Lucaszyf/Solar-Enhanced-Biomimetic-UAV/cad/No2/9gServo舵机/servo2.jpg

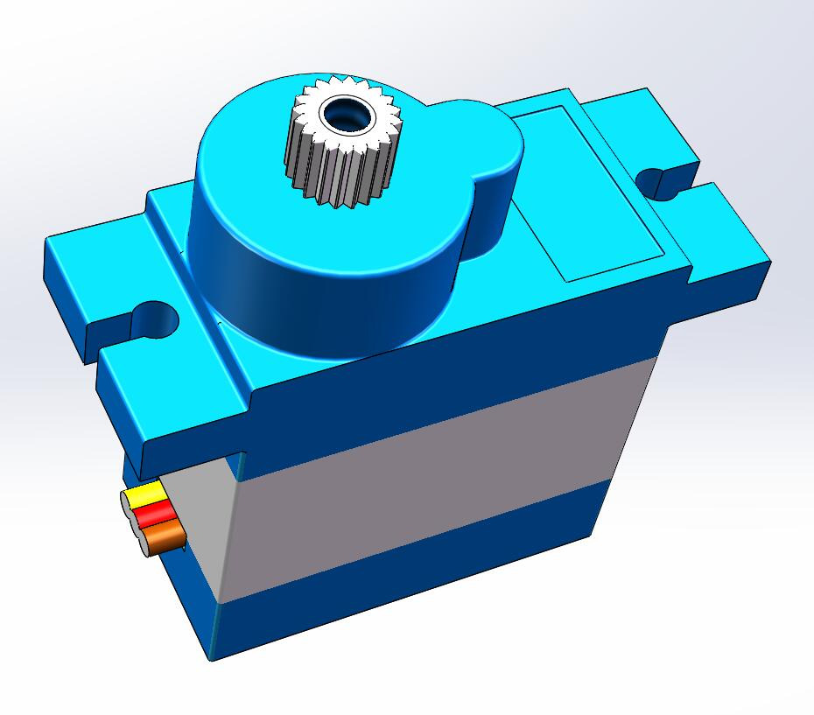
cad/No2/9gServo舵机/servo2.jpg
