Lucaszyf/Solar-Enhanced-Biomimetic-UAV/cad/No2/太阳能折叠总装/temp/images/6afcfdeb6e5e799abb95b9de54fae45f_preview_featured.jpg

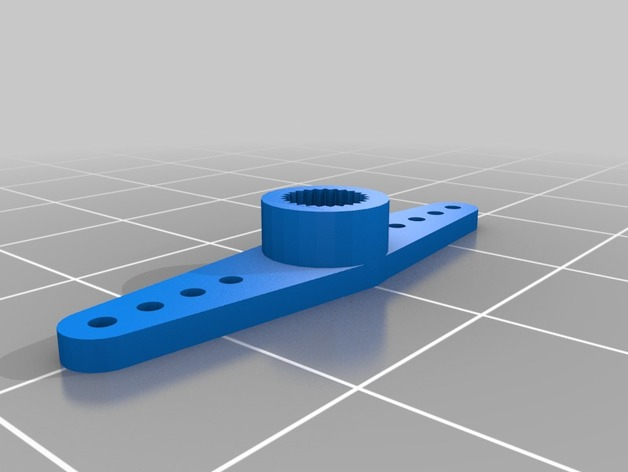
cad/No2/太阳能折叠总装/temp/images/6afcfdeb6e5e799abb95b9de54fae45f_preview_featured.jpg
