Lucaszyf/Solar-Enhanced-Biomimetic-UAV/cad/No2/太阳能折叠总装/temp/images/27f57d334d398717d7f864618033304d_preview_featured.jpg

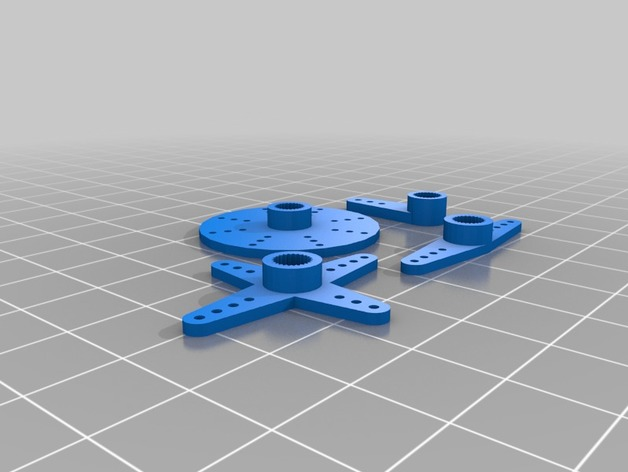
cad/No2/太阳能折叠总装/temp/images/27f57d334d398717d7f864618033304d_preview_featured.jpg
