Lucaszyf/Solar-Enhanced-Biomimetic-UAV/cad/No2/太阳能折叠总装/temp/images/63d8c76050e472f91e92825d48e62a55_preview_featured.jpg

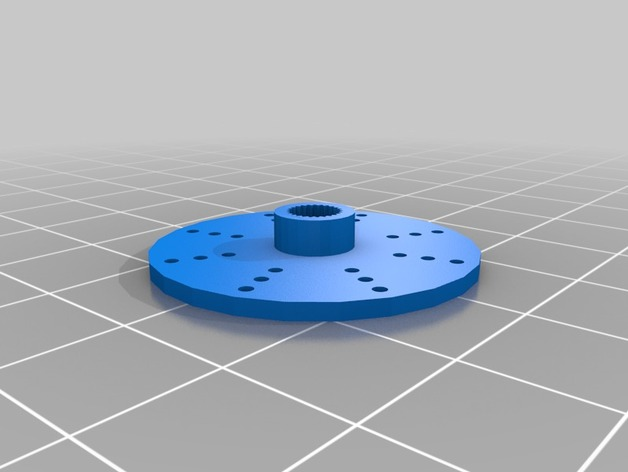
cad/No2/太阳能折叠总装/temp/images/63d8c76050e472f91e92825d48e62a55_preview_featured.jpg
