Lucaszyf/Solar-Enhanced-Biomimetic-UAV/cad/No2/太阳能折叠总装/temp/images/a5b6eb91ea950f15ae837887f96c0987_preview_featured.jpg

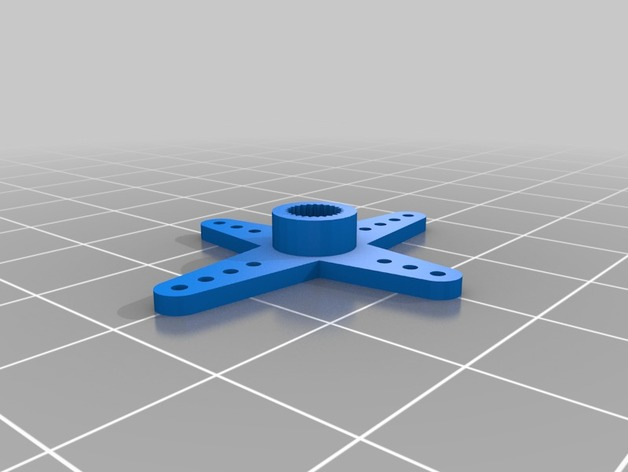
cad/No2/太阳能折叠总装/temp/images/a5b6eb91ea950f15ae837887f96c0987_preview_featured.jpg
