Lucaszyf/Solar-Enhanced-Biomimetic-UAV/cad/No2/太阳能折叠总装/temp/images/cd8d0d1ee94c76521f08f14a7efa53d7_preview_featured.jpg

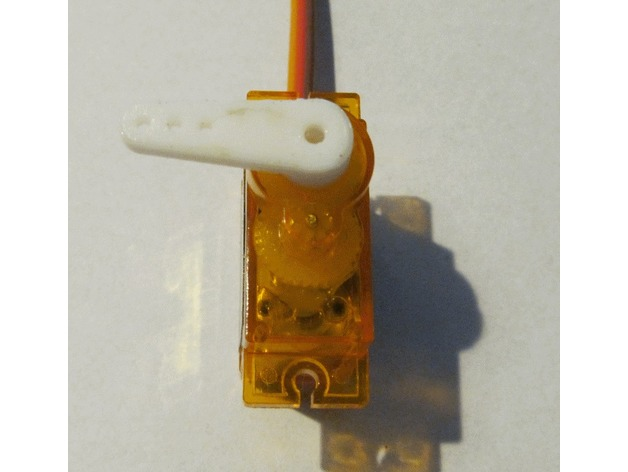
cad/No2/太阳能折叠总装/temp/images/cd8d0d1ee94c76521f08f14a7efa53d7_preview_featured.jpg
