Lucaszyf/Solar-Enhanced-Biomimetic-UAV/cad/No1/Lucas_3Dfile/尼龙碳纤维打印/数量.xlsx

名称 | 数量
inner suction cup connector | 2
outerconnectorv2 | 2
partCon01 | 1
partCon02 | 1
蜗杆1×1 | 2
蜗轮27×1 | 2
折叠架电机 | 4
齿条0.106814150222053×2 | 4
太阳能板夹持件 | 4
