Lucaszyf/Solar-Enhanced-Biomimetic-UAV/cad/No2/太阳能折叠总装/太阳能板子建模/n20 motor.SLDASM

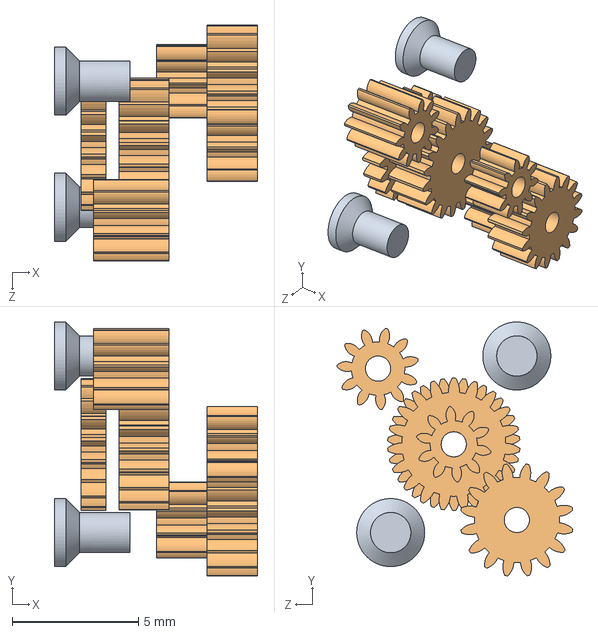
[picture p71: CAD file, 2026-10-14]
cad/No2/太阳能折叠总装/太阳能板子建模/n20 motor.SLDASM
8.05 x 10.1 x 9.34 mm
cross recessed countersunk head screws gb1 x 2
spur gear_gb x 6
