Lucaszyf/Solar-Enhanced-Biomimetic-UAV/cad/No3/三维模型总装配/Microswitch-SS-3GL13SL.SLDASM

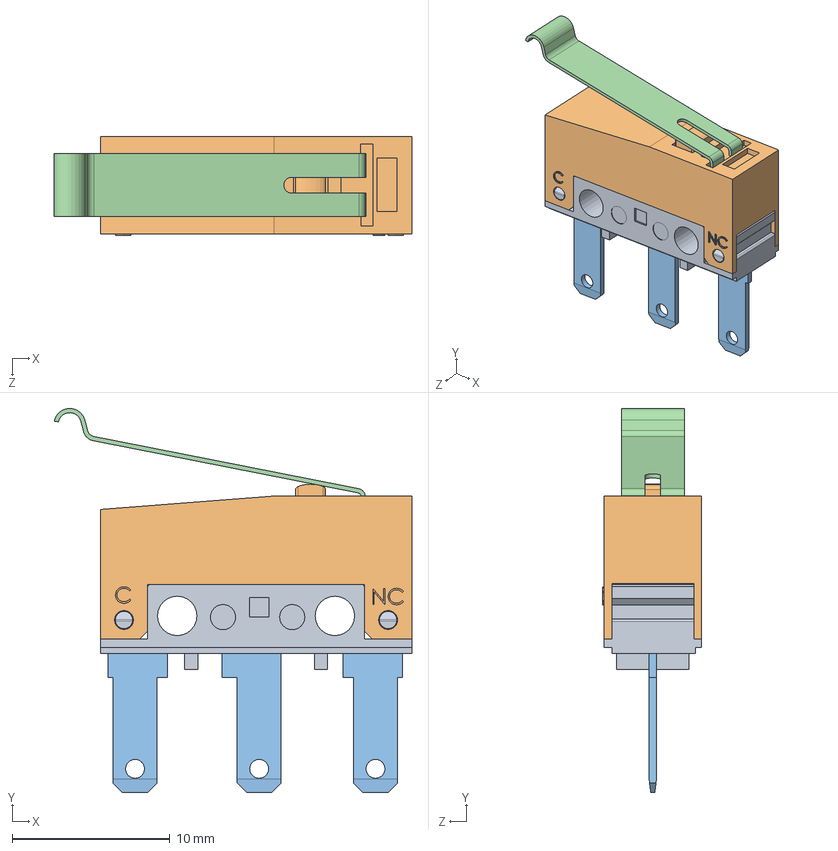
[picture p72: CAD file, 2026-10-14]
cad/No3/三维模型总装配/Microswitch-SS-3GL13SL.SLDASM
22.7 x 24.4 x 6.30 mm
limit-switch-bottomcase
limit-switch-top-case
pins
switch_lever
