Lucaszyf/Solar-Enhanced-Biomimetic-UAV/cad/No1/Lucas_3Dfile/整体装配.SLDASM

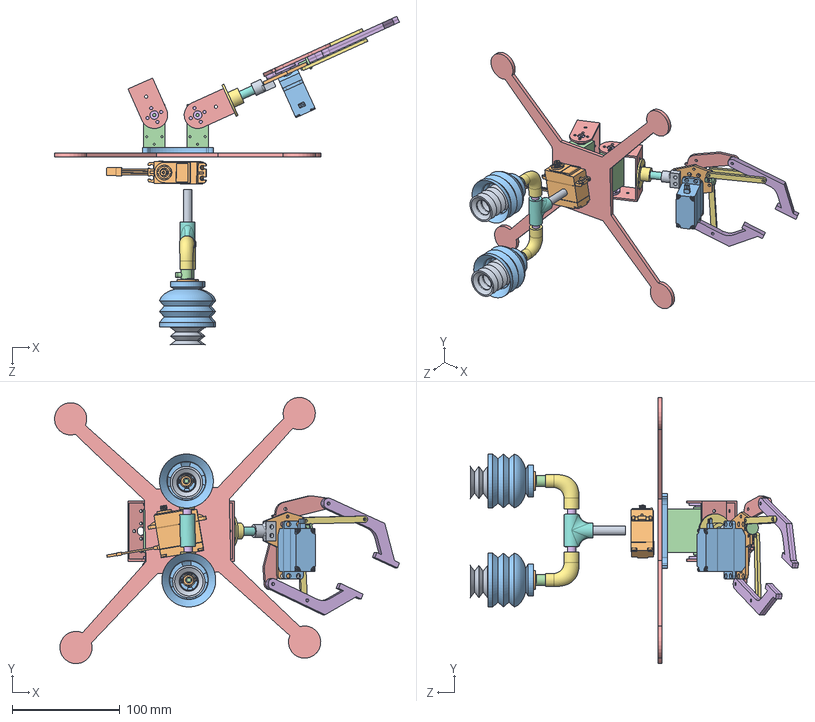
[picture p73: CAD file, 2026-10-14]
cad/No1/Lucas_3Dfile/整体装配.SLDASM
320.1 x 247.0 x 304.7 mm
INT_TUBE x 2
CON_2 x 2
EXT_TUBE x 2
CUP_HOL x 2
UAV_FRAME01
8x6碳管
CON_3 x 2
CON_4
8x6碳管02
25KG铝中壳舵机外形图
servodeck.step
3115舵机 x 2
短U支架 x 2
金属主舵盘 x 5
法兰盘01
8mm碳管
机械爪C01
单轴舵机
圆柱齿轮17×1.25从动 x 2
