Lucaszyf/Solar-Enhanced-Biomimetic-UAV/cad/No2/舵机云台/solidworks/pan_tilt.SLDASM

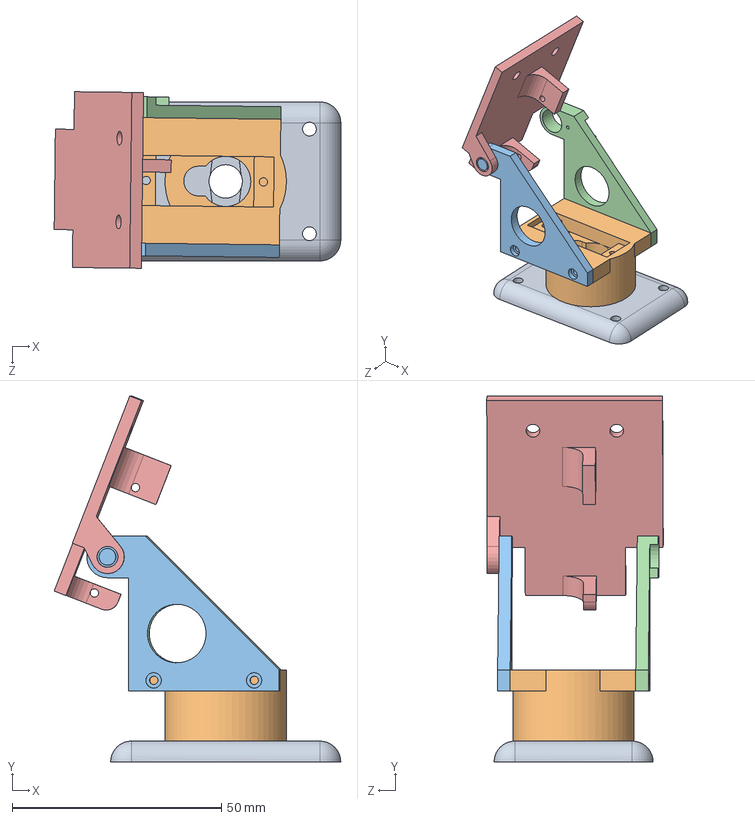
[picture p74: CAD file, 2026-10-14]
cad/No2/舵机云台/solidworks/pan_tilt.SLDASM
68.5 x 87.4 x 42.2 mm
base
rotate
left
right
head
