Lucaszyf/Solar-Enhanced-Biomimetic-UAV/cad/No1/3D零件图/双轴舵机3D图/3115舵机加舵盘.sldasm

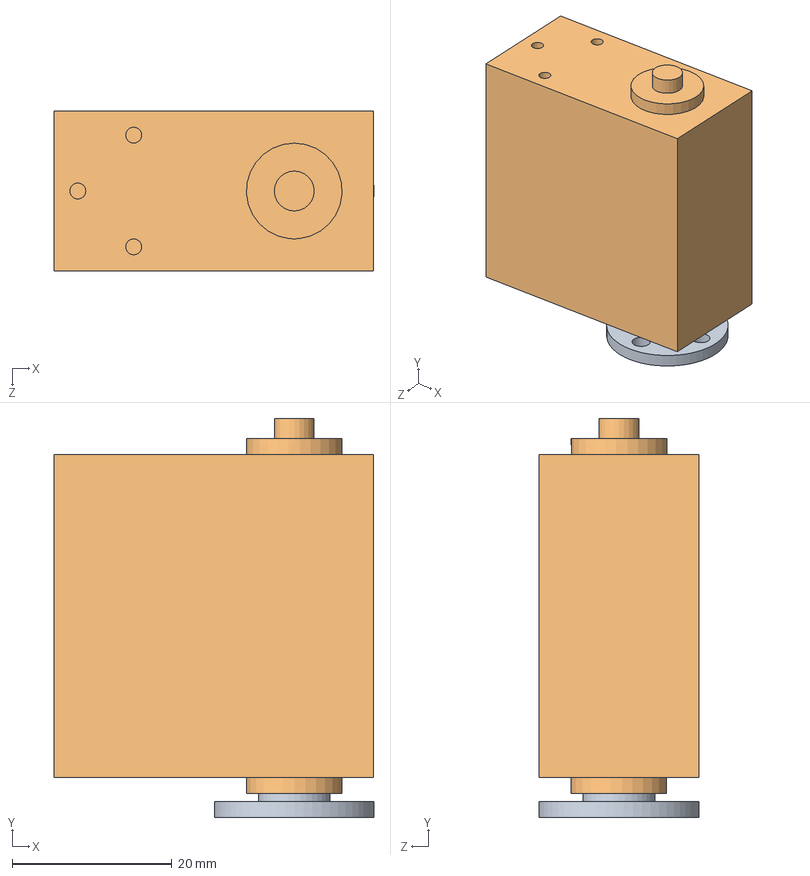
[picture p75: CAD file, 2026-10-14]
cad/No1/3D零件图/双轴舵机3D图/3115舵机加舵盘.sldasm
40.1 x 50.0 x 20.0 mm
3115舵机
虚轴舵盘
