Lucaszyf/Solar-Enhanced-Biomimetic-UAV/cad/No1/3D零件图/机械臂总装.SLDASM

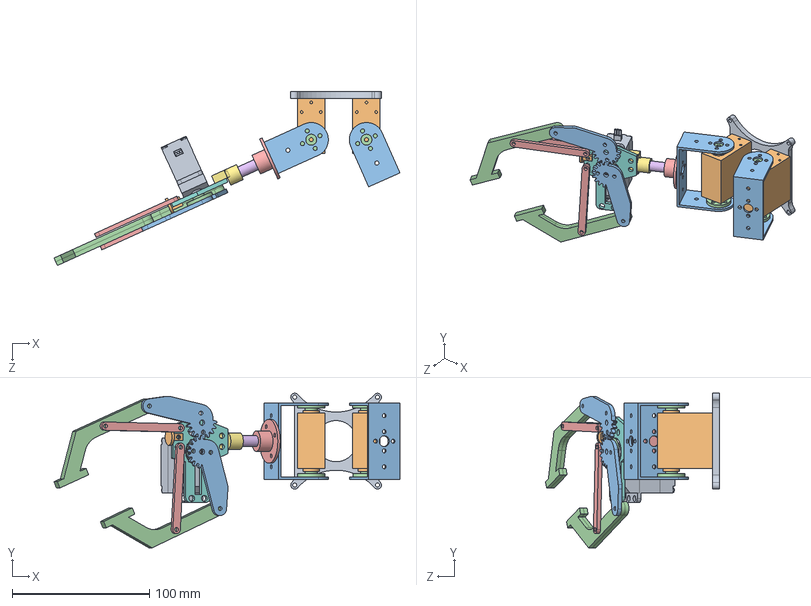
[picture p77: CAD file, 2026-10-14]
cad/No1/3D零件图/机械臂总装.SLDASM
251.9 x 112.6 x 126.7 mm
servodeck.step
3115舵机 x 2
短U支架 x 2
金属主舵盘 x 5
法兰盘01
8mm碳管
机械爪C01
单轴舵机
圆柱齿轮17×1.25从动 x 2
