Lucaszyf/Solar-Enhanced-Biomimetic-UAV/cad/No1/Lucas_3Dfile/机械爪/总装.SLDASM

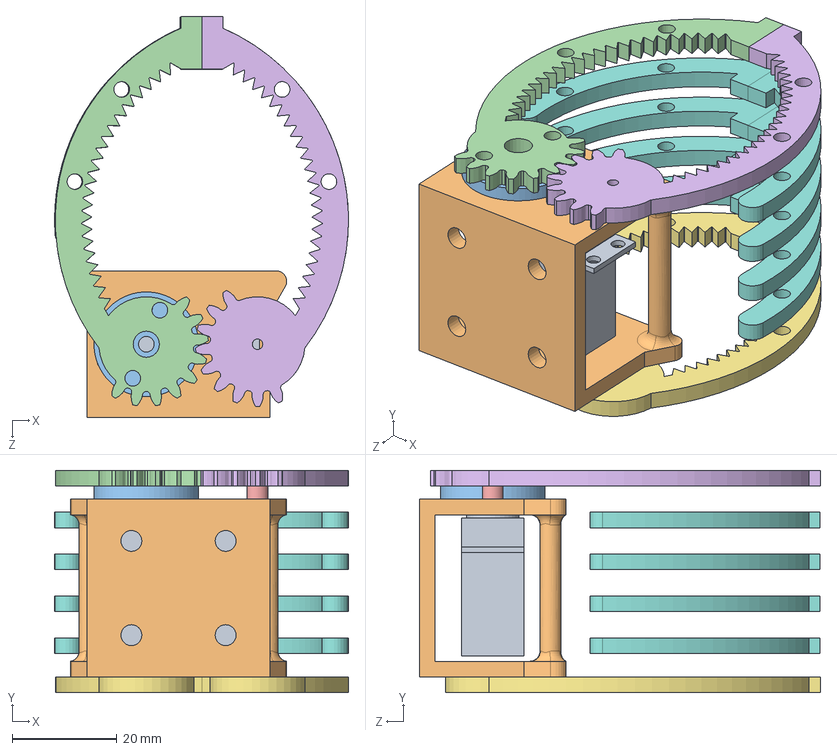
[picture p78: CAD file, 2026-10-14]
cad/No1/Lucas_3Dfile/机械爪/总装.SLDASM
56.2 x 42.5 x 76.6 mm
servo
金属主舵盘
圆柱齿轮17×1.25
圆柱齿轮17×1.2502
