Lucaszyf/Solar-Enhanced-Biomimetic-UAV/cad/No1/Lucas_3Dfile/吸盘支架总装.SLDASM

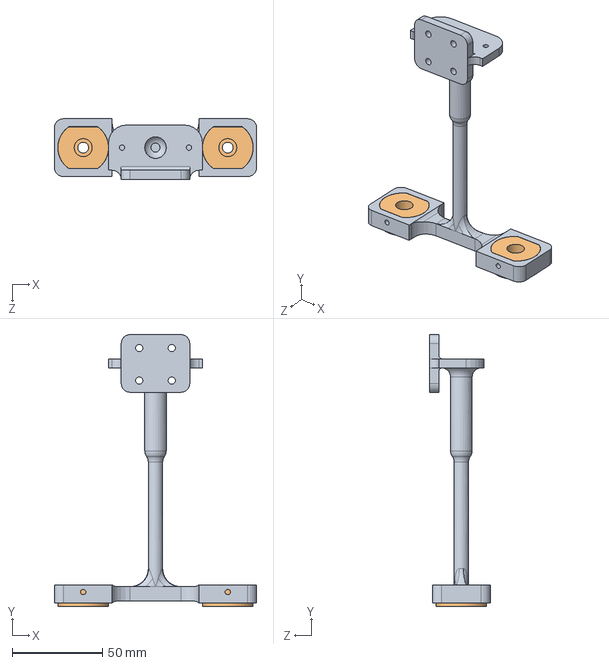
[picture p79: CAD file, 2026-10-14]
cad/No1/Lucas_3Dfile/吸盘支架总装.SLDASM
112.0 x 150.5 x 33.5 mm
partCon01
iconCon x 2
