Lucaszyf/Solar-Enhanced-Biomimetic-UAV/cad/No1/Lucas_3Dfile/模具总装.SLDASM

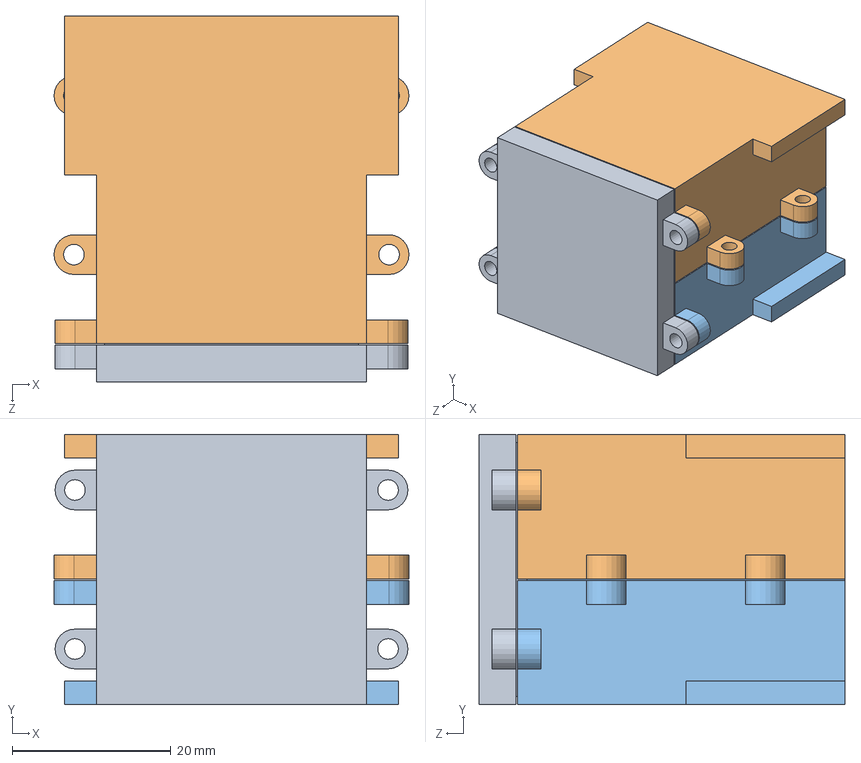
[picture p80: CAD file, 2026-10-14]
cad/No1/Lucas_3Dfile/模具总装.SLDASM
44.7 x 34.0 x 46.0 mm
模型内胆
上模具
下模具
