Lucaszyf/Solar-Enhanced-Biomimetic-UAV/cad/No1/Lucas_3Dfile/模具总装02.SLDASM

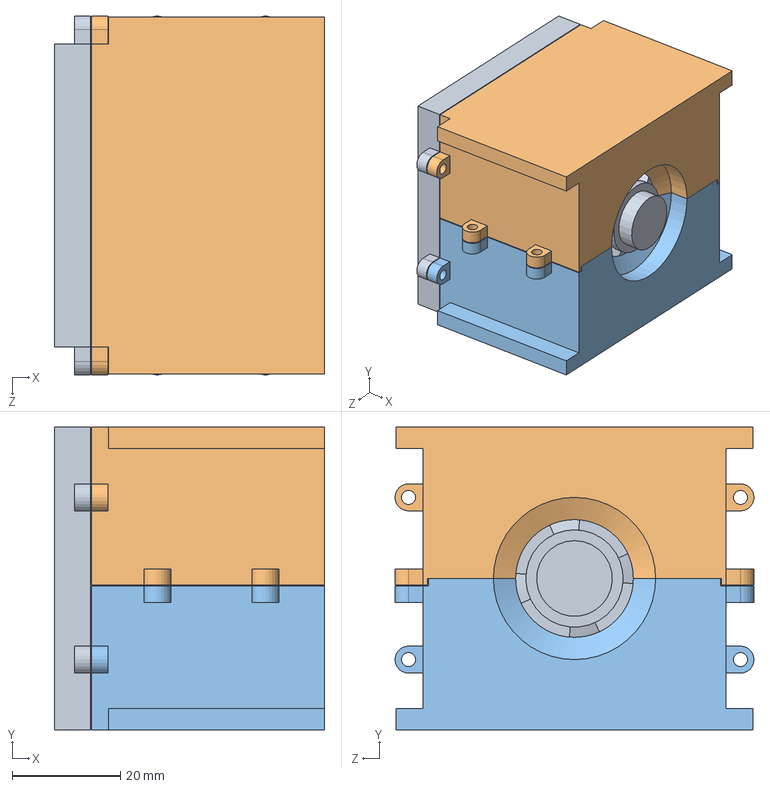
[picture p81: CAD file, 2026-10-14]
cad/No1/Lucas_3Dfile/模具总装02.SLDASM
50.0 x 56.0 x 66.4 mm
模型内胆02
上模具02
下模具02
