Lucaszyf/Solar-Enhanced-Biomimetic-UAV/cad/No1/2D/圆柱齿轮17×1.25从动.dxf

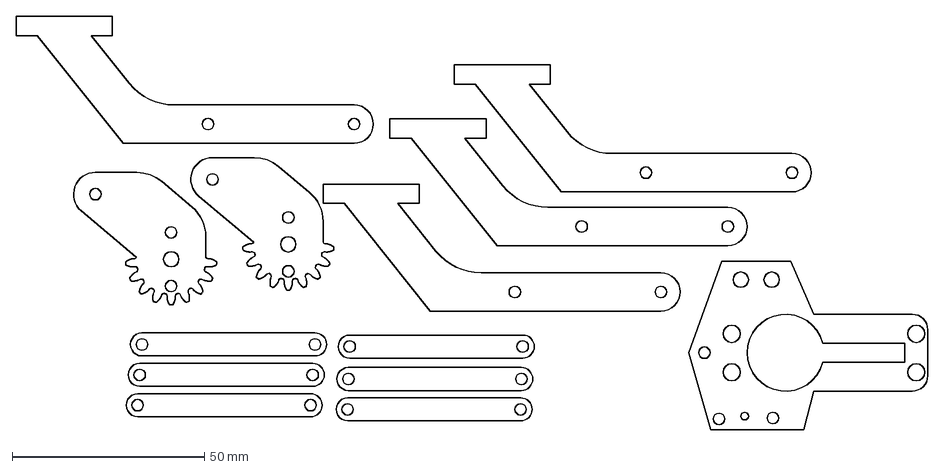
[picture p82: CAD file, 2026-10-14]
cad/No1/2D/圆柱齿轮17×1.25从动.dxf
237.1 x 107.5 mm
