Lucaszyf/Solar-Enhanced-Biomimetic-UAV/cad/No1/3D尺寸图/202315抛投器零件PDF档/1.抛丸器图纸.STEP

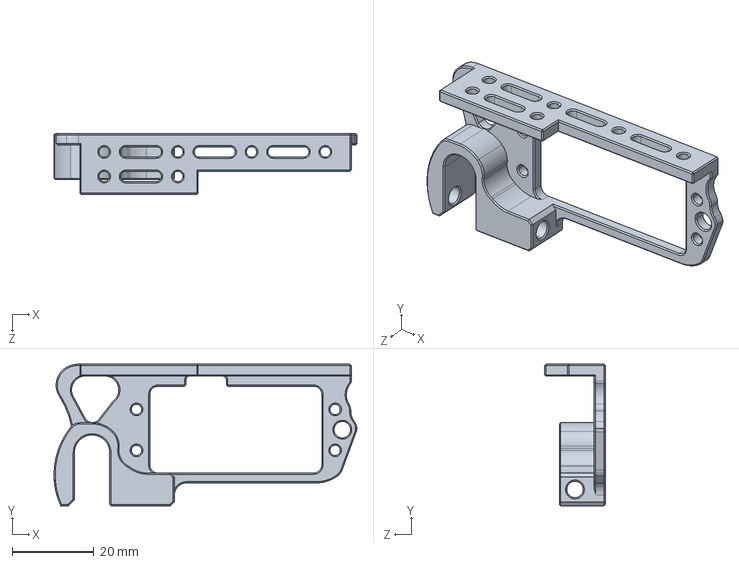
[picture p83: CAD file, 2026-10-14]
cad/No1/3D尺寸图/202315抛投器零件PDF档/1.抛丸器图纸.STEP
74.0 x 34.6 x 14.8 mm
