Lucaszyf/Solar-Enhanced-Biomimetic-UAV/cad/No1/3D尺寸图/TD-9412MG.stp

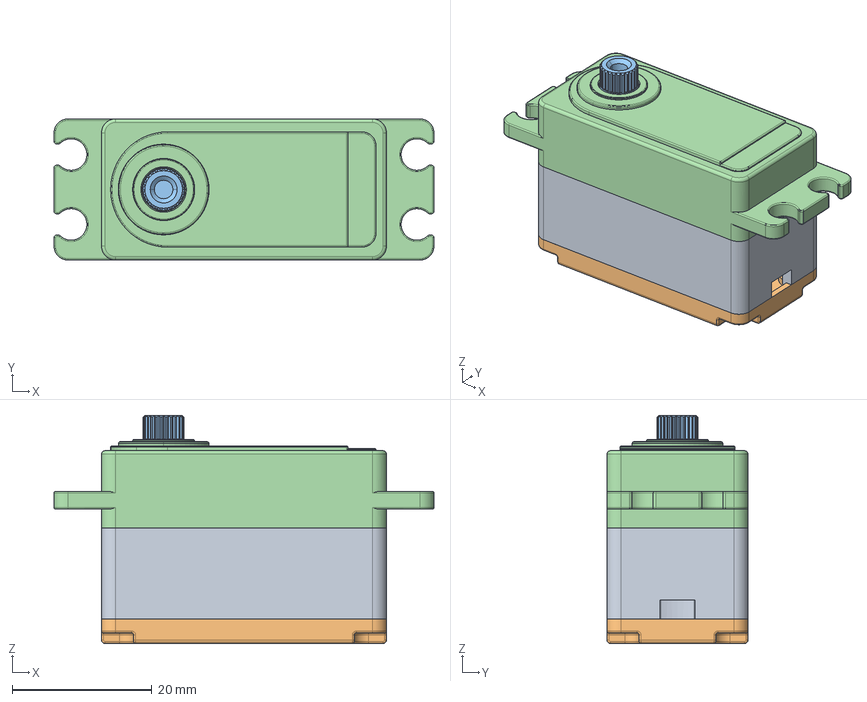
[picture p84: CAD file, 2026-10-14]
cad/No1/3D尺寸图/TD-9412MG.stp
54.4 x 20.2 x 32.6 mm
PRT0007_1
PRT0008_1
PRT0009_1
