Lucaszyf/Solar-Enhanced-Biomimetic-UAV/cad/No1/3D零件图/一字型支架.stp

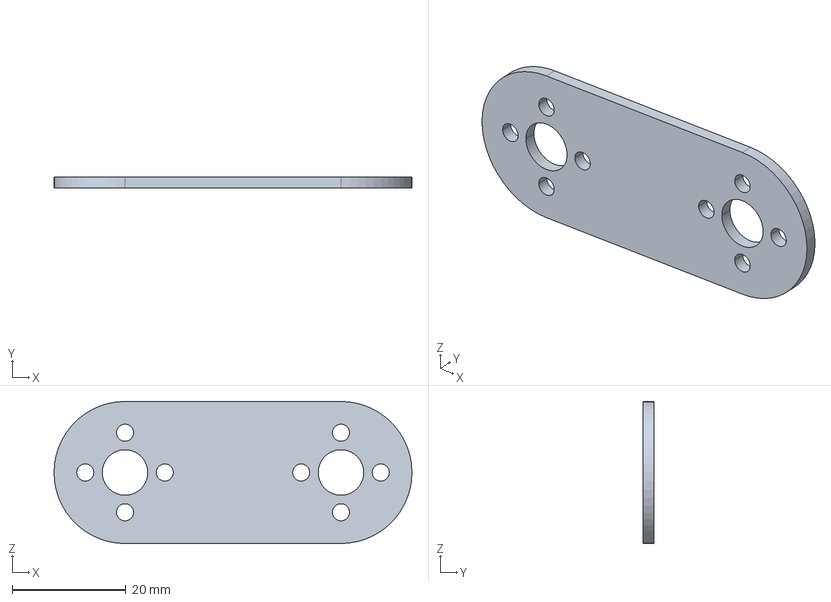
[picture p86: CAD file, 2026-10-14]
cad/No1/3D零件图/一字型支架.stp
63.0 x 2.00 x 25.0 mm
