Lucaszyf/Solar-Enhanced-Biomimetic-UAV/cad/No1/3D零件图/双轴舵机3D图/3115舵机.SLDPRT

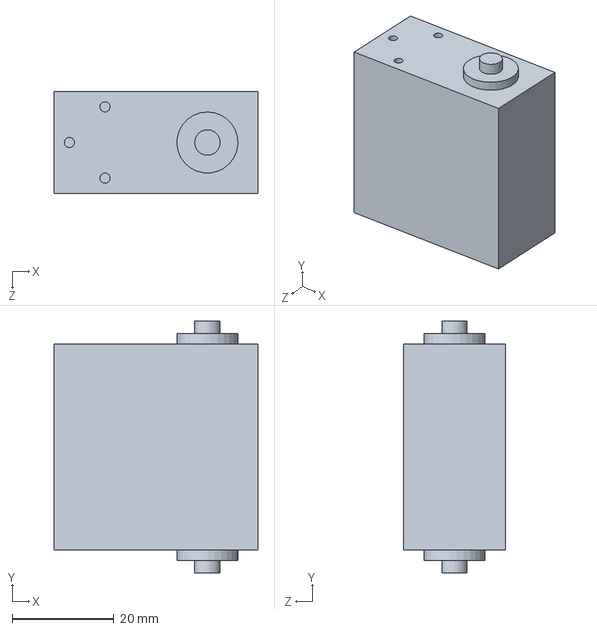
[picture p87: CAD file, 2026-10-14]
cad/No1/3D零件图/双轴舵机3D图/3115舵机.SLDPRT
40.0 x 49.5 x 20.0 mm
