Lucaszyf/Solar-Enhanced-Biomimetic-UAV/cad/No1/Lucas_3Dfile/CNC加工/iconCon.STEP

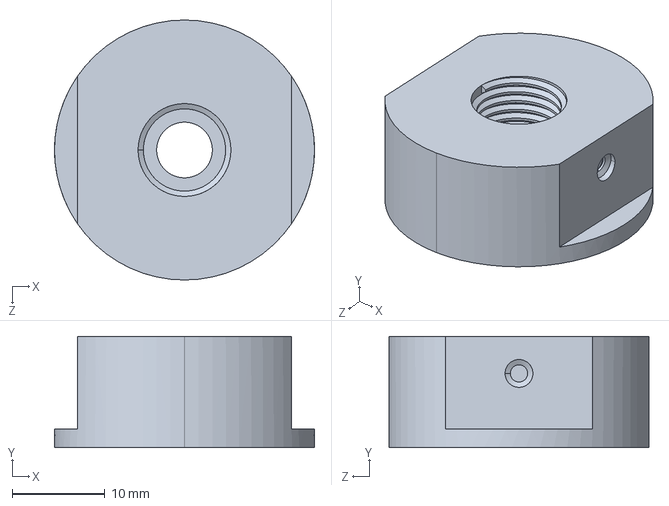
[picture p88: CAD file, 2026-10-14]
cad/No1/Lucas_3Dfile/CNC加工/iconCon.STEP
28.0 x 12.0 x 28.0 mm
