Lucaszyf/Solar-Enhanced-Biomimetic-UAV/cad/No1/Lucas_3Dfile/Lucas/inner suction cup connector.STEP

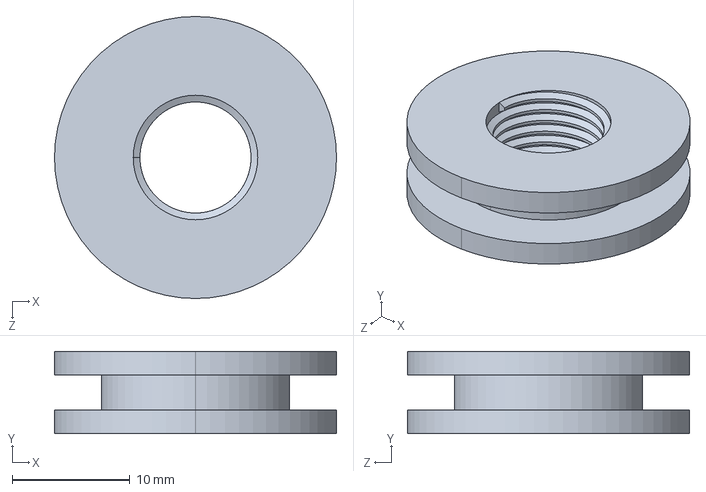
[picture p89: CAD file, 2026-10-14]
cad/No1/Lucas_3Dfile/Lucas/inner suction cup connector.STEP
24.0 x 7.00 x 24.0 mm
