Lucaszyf/Solar-Enhanced-Biomimetic-UAV/cad/No1/Lucas_3Dfile/上模具02.SLDPRT

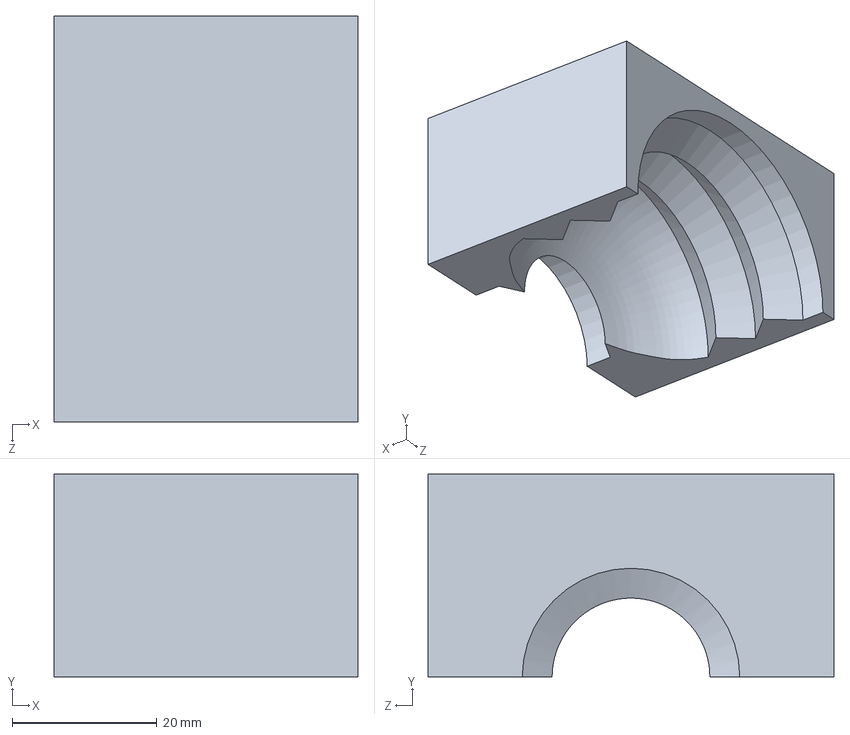
[picture p90: CAD file, 2026-10-14]
cad/No1/Lucas_3Dfile/上模具02.SLDPRT
41.9 x 28.0 x 56.0 mm
