Lucaszyf/Solar-Enhanced-Biomimetic-UAV/cad/No1/Lucas_3Dfile/尼龙碳纤维打印/齿条0.106814150222053×2.STEP

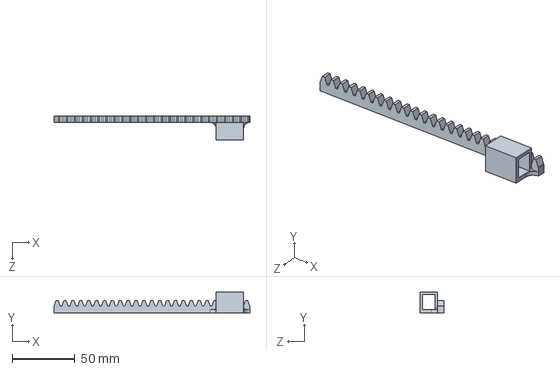
[picture p91: CAD file, 2026-10-14]
cad/No1/Lucas_3Dfile/尼龙碳纤维打印/齿条0.106814150222053×2.STEP
156.0 x 16.5 x 19.0 mm
