Lucaszyf/Solar-Enhanced-Biomimetic-UAV/cad/No1/Lucas_3Dfile/机械爪/2D/part04.dxf

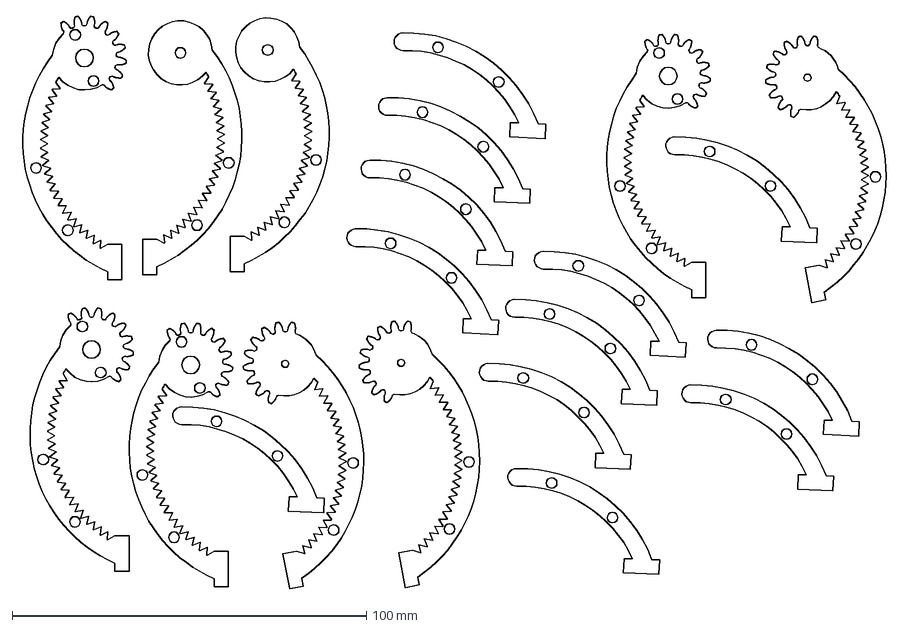
[picture p92: CAD file, 2026-10-14]
cad/No1/Lucas_3Dfile/机械爪/2D/part04.dxf
246.3 x 161.7 mm
