Lucaszyf/Solar-Enhanced-Biomimetic-UAV/cad/No1/Lucas_3Dfile/机械爪/part02.SLDPRT

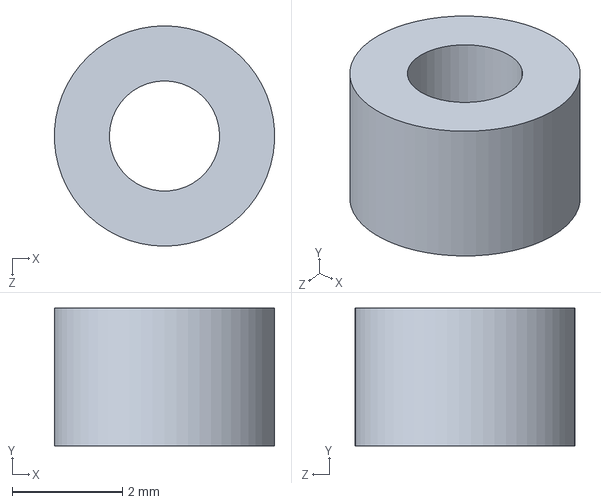
[picture p93: CAD file, 2026-10-14]
cad/No1/Lucas_3Dfile/机械爪/part02.SLDPRT
3.99 x 2.50 x 4.00 mm
