Lucaszyf/Solar-Enhanced-Biomimetic-UAV/cad/No1/吸盘打印件/吸盘支撑.SLDPRT

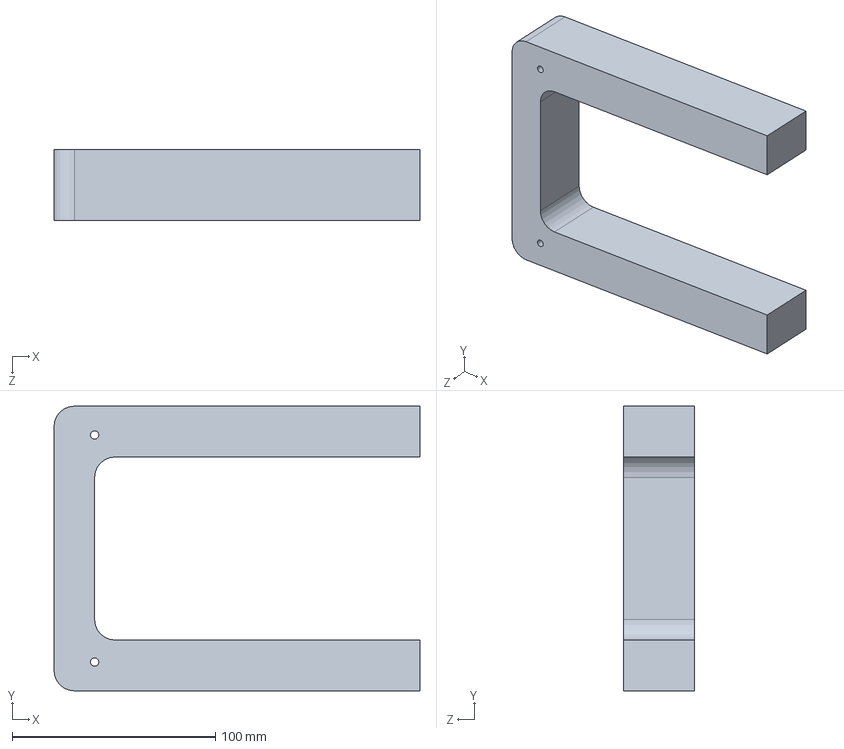
[picture p94: CAD file, 2026-10-14]
cad/No1/吸盘打印件/吸盘支撑.SLDPRT
180.0 x 140.0 x 35.0 mm
