Lucaszyf/Solar-Enhanced-Biomimetic-UAV/cad/No1/第二版/CON01.SLDPRT

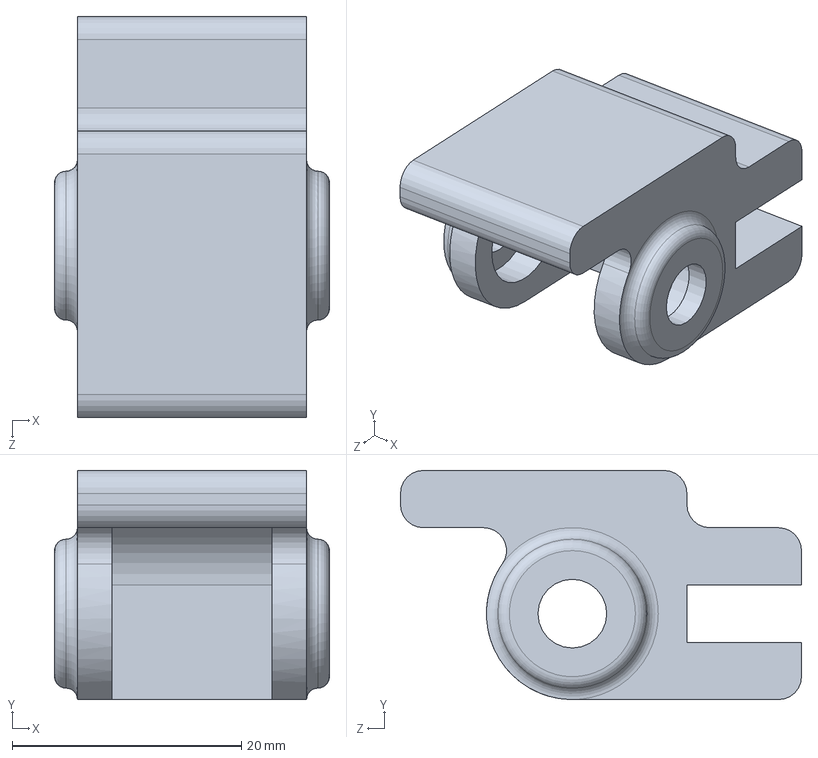
[picture p95: CAD file, 2026-10-14]
cad/No1/第二版/CON01.SLDPRT
24.0 x 20.0 x 35.0 mm
