Lucaszyf/Solar-Enhanced-Biomimetic-UAV/cad/No2/9gServo舵机/舵机.SLDPRT

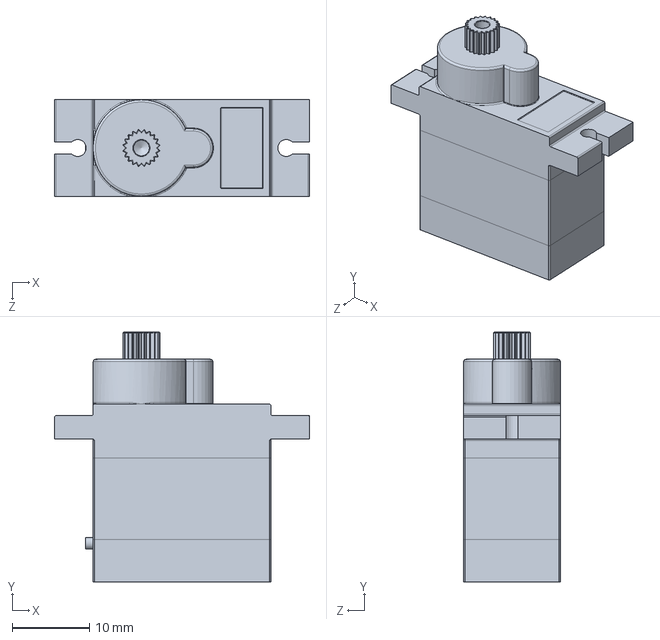
[picture p96: CAD file, 2026-10-14]
cad/No2/9gServo舵机/舵机.SLDPRT
33.0 x 32.3 x 12.5 mm
