Lucaszyf/Solar-Enhanced-Biomimetic-UAV/cad/No2/N20微型金属齿轮电机/motor.SLDPRT

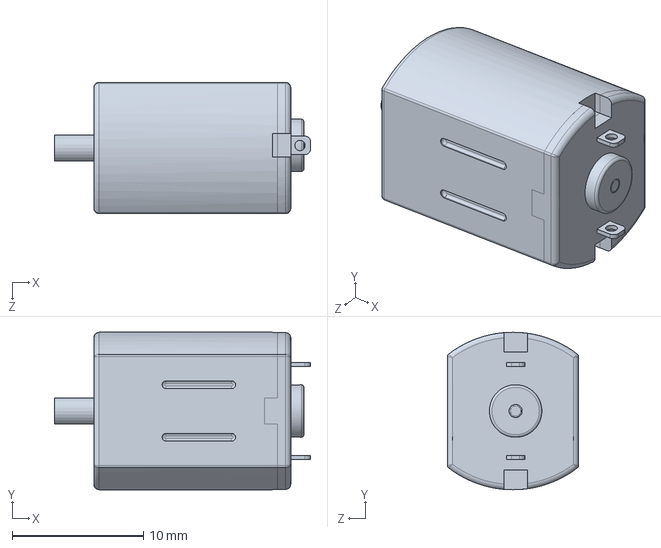
[picture p97: CAD file, 2026-10-14]
cad/No2/N20微型金属齿轮电机/motor.SLDPRT
19.5 x 12.0 x 10.0 mm
