Lucaszyf/Solar-Enhanced-Biomimetic-UAV/cad/No2/太阳能折叠总装/temp/files/9g_servo_arm_single.stl

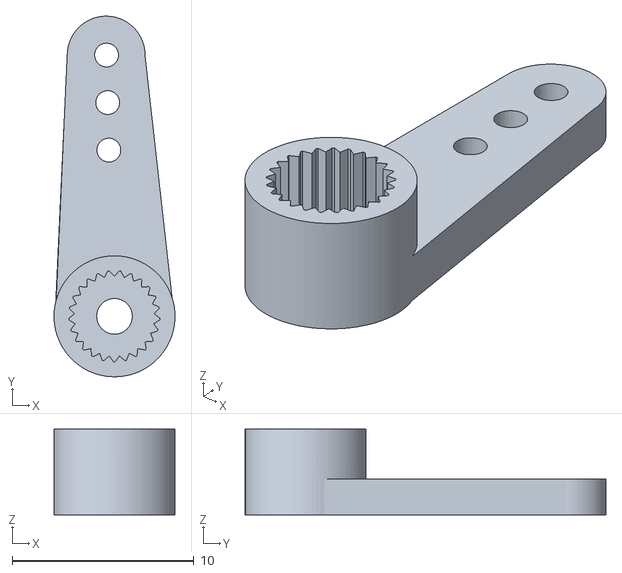
[picture p98: CAD file, 2026-10-14]
cad/No2/太阳能折叠总装/temp/files/9g_servo_arm_single.stl
6.65 x 19.8 x 4.70
