Lucaszyf/Solar-Enhanced-Biomimetic-UAV/cad/No2/太阳能折叠总装/圆柱齿轮17×21.SLDPRT

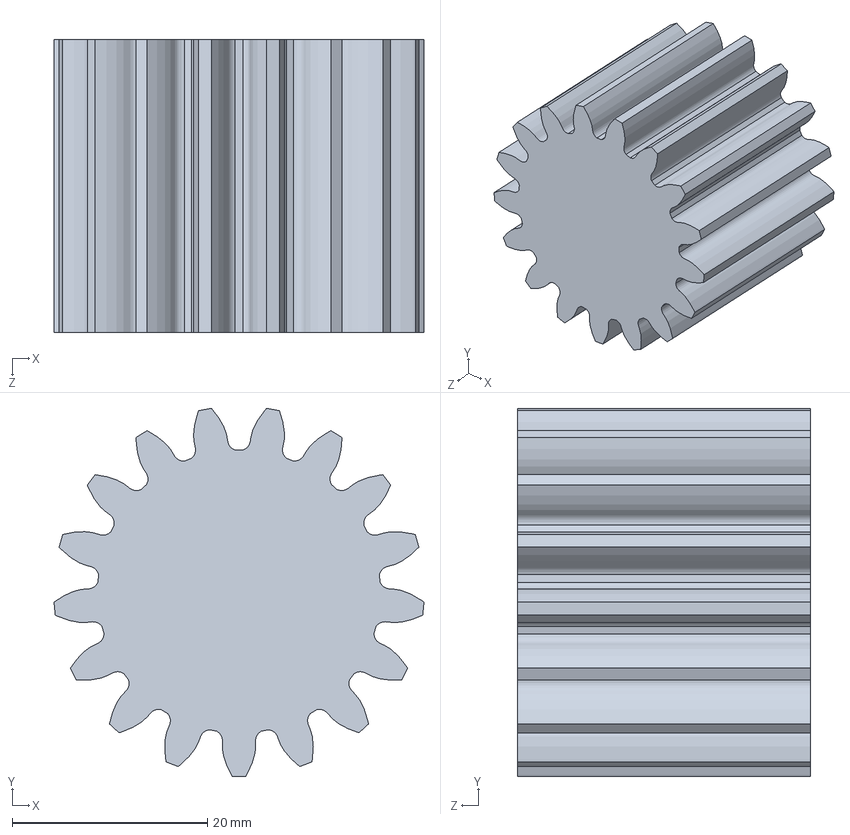
[picture p99: CAD file, 2026-10-14]
cad/No2/太阳能折叠总装/圆柱齿轮17×21.SLDPRT
37.9 x 37.8 x 30.0 mm
