Lucaszyf/Solar-Enhanced-Biomimetic-UAV/cad/No2/舵机云台/solidworks/left.SLDPRT

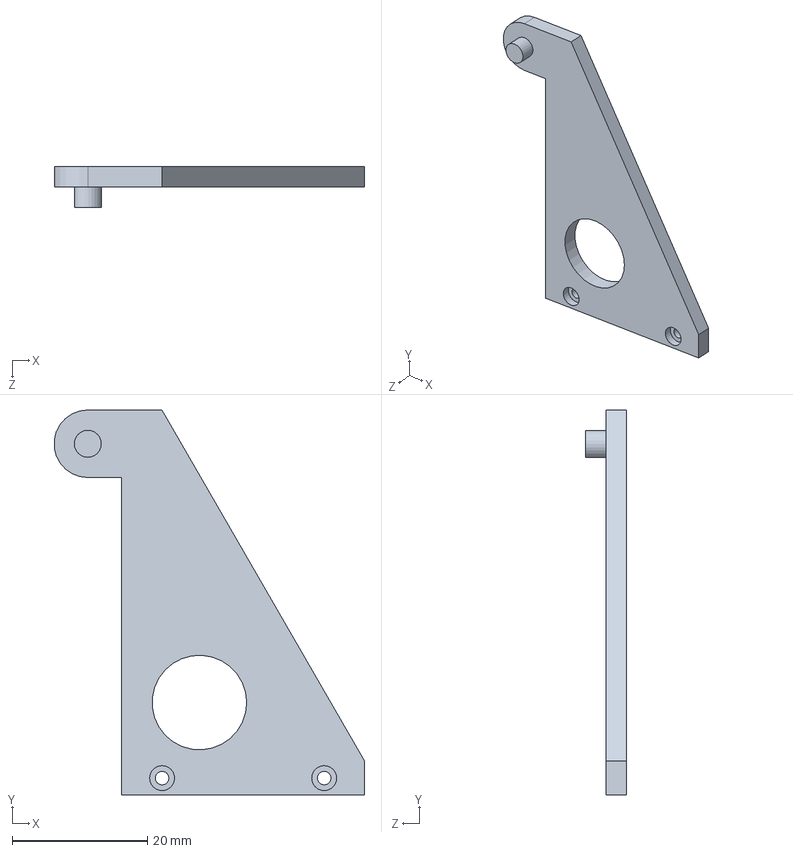
[picture p100: CAD file, 2026-10-14]
cad/No2/舵机云台/solidworks/left.SLDPRT
46.0 x 57.0 x 6.00 mm
