Lucaszyf/Solar-Enhanced-Biomimetic-UAV/cad/No3/三维模型总装配/part05.SLDPRT

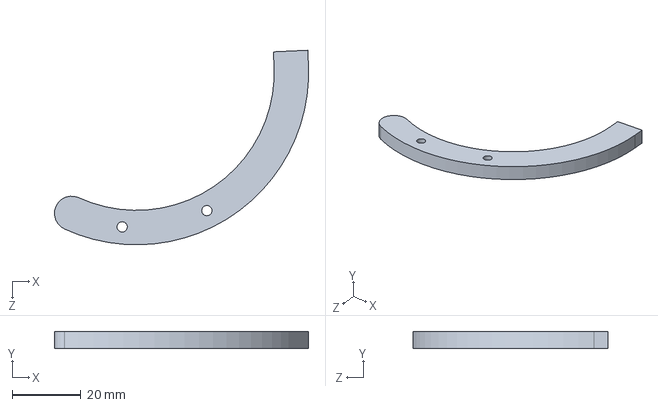
[picture p101: CAD file, 2026-10-14]
cad/No3/三维模型总装配/part05.SLDPRT
73.8 x 5.00 x 56.5 mm
