Lucaszyf/Solar-Enhanced-Biomimetic-UAV/cad/No3/游泳圈建模/rotate-s.SLDPRT

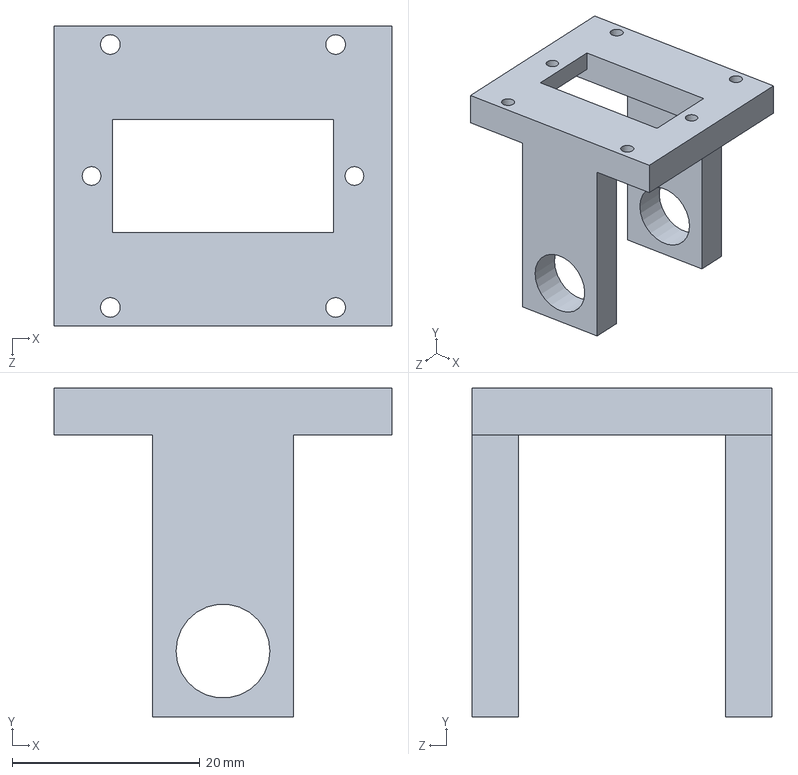
[picture p102: CAD file, 2026-10-14]
cad/No3/游泳圈建模/rotate-s.SLDPRT
36.0 x 35.0 x 32.0 mm
