Lucaszyf/Solar-Enhanced-Biomimetic-UAV/cad/华馨京科技 25-50kg 舵机模型图纸（含配件）/华馨京 25-50kg单轴舵机系列/华馨京 25-50kg单轴舵机 3D.STEP

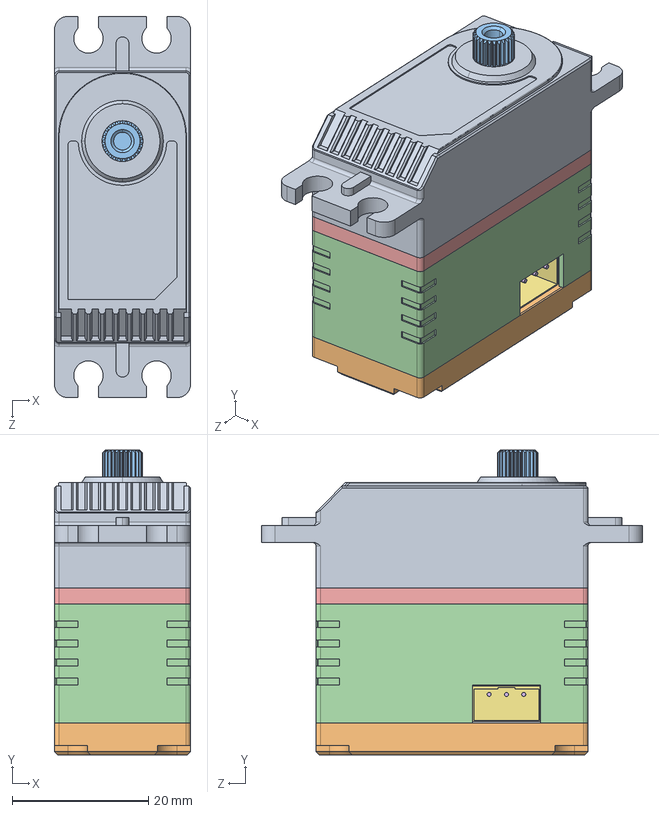
[picture p103: CAD file, 2026-10-14]
cad/华馨京科技 25-50kg 舵机模型图纸（含配件）/华馨京 25-50kg单轴舵机系列/华馨京 25-50kg单轴舵机 3D.STEP
20.0 x 44.8 x 56.0 mm
上盖（单轴）.step
下盖（单轴）.step
怀堤喘.step
中段-绿色
中盖组件
3pin諉諳.step x 2
