Lucaszyf/Solar-Enhanced-Biomimetic-UAV/cad/华馨京科技 25-50kg 舵机模型图纸（含配件）/华馨京 舵机 D型输出轴系列/华馨京 25-50kg双轴舵机外观尺寸图-D型输出轴/华馨京 25-50kg双轴舵机（D轴）-3D.STEP

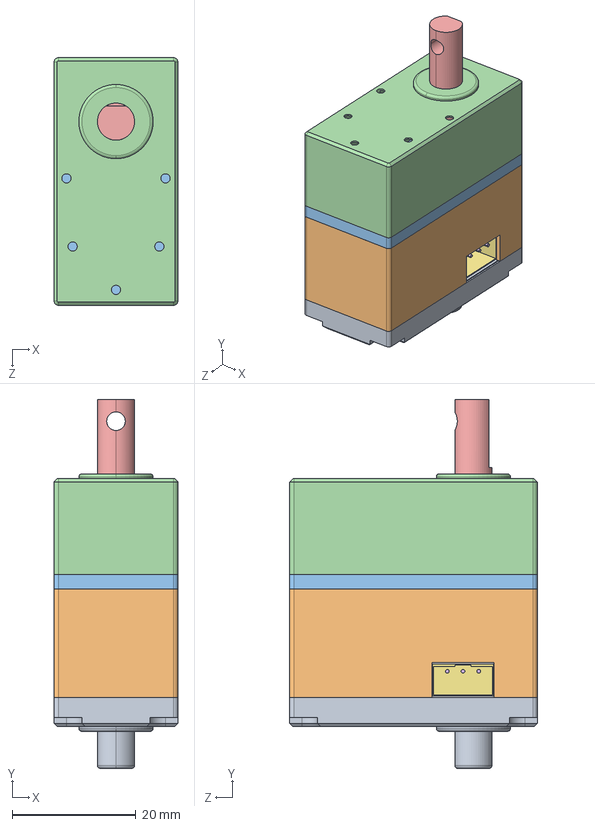
[picture p104: CAD file, 2026-10-14]
cad/华馨京科技 25-50kg 舵机模型图纸（含配件）/华馨京 舵机 D型输出轴系列/华馨京 25-50kg双轴舵机外观尺寸图-D型输出轴/华馨京 25-50kg双轴舵机（D轴）-3D.STEP
20.0 x 59.6 x 40.0 mm
442Dﾏﾂｸﾇ｣ｨﾋｫﾖ皀ｩ
442D笢僇
442D中盖组件
442Dﾉﾏｸﾇ｣ｨﾋｫﾖ皀ｩ
D型输出齿.step
3pin諉諳.step x 2
