Lucaszyf/Solar-Enhanced-Biomimetic-UAV/cad/华馨京科技 OpenMV舵机云台图纸/华馨京 OpenMV舵机云台-3D.STEP

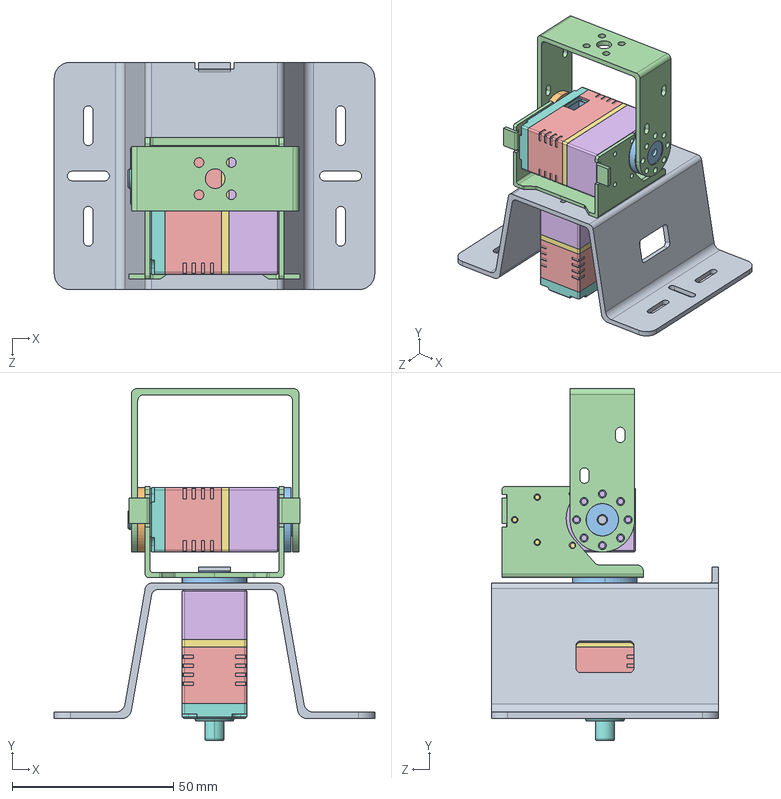
[picture p105: CAD file, 2026-10-14]
cad/华馨京科技 OpenMV舵机云台图纸/华馨京 OpenMV舵机云台-3D.STEP
99.4 x 109.1 x 70.5 mm
底部支架（新款,正确）
嗆攫ㄗ萵ㄘ
嗆攫ㄗ翋ㄘ x 2
二级支架（新款）.step
____-____.STEP x 2
____________.STEP x 2
________.STEP x 2
____________-0.STEP x 2
______.step.STEP x 2
3pin____.step.STEP x 4
大U舵机支架
