Lucaszyf/Solar-Enhanced-Biomimetic-UAV/cad/No1/3D尺寸图/3.7克微型舵机.SLDPRT

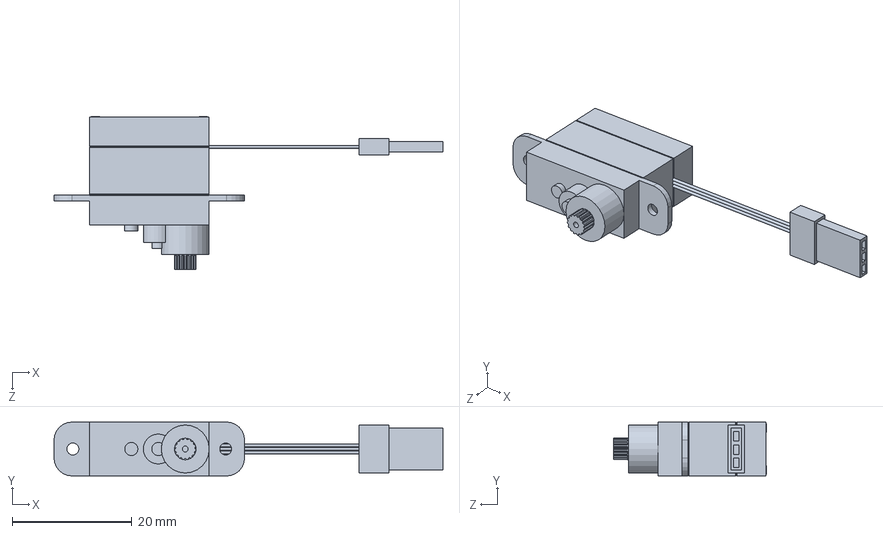
[picture p106: CAD file, 2026-10-14]
cad/No1/3D尺寸图/3.7克微型舵机.SLDPRT
64.9 x 9.00 x 25.6 mm
