Lucaszyf/Solar-Enhanced-Biomimetic-UAV/cad/No1/3D零件图/双轴舵机3D图/窄U支架.SLDPRT

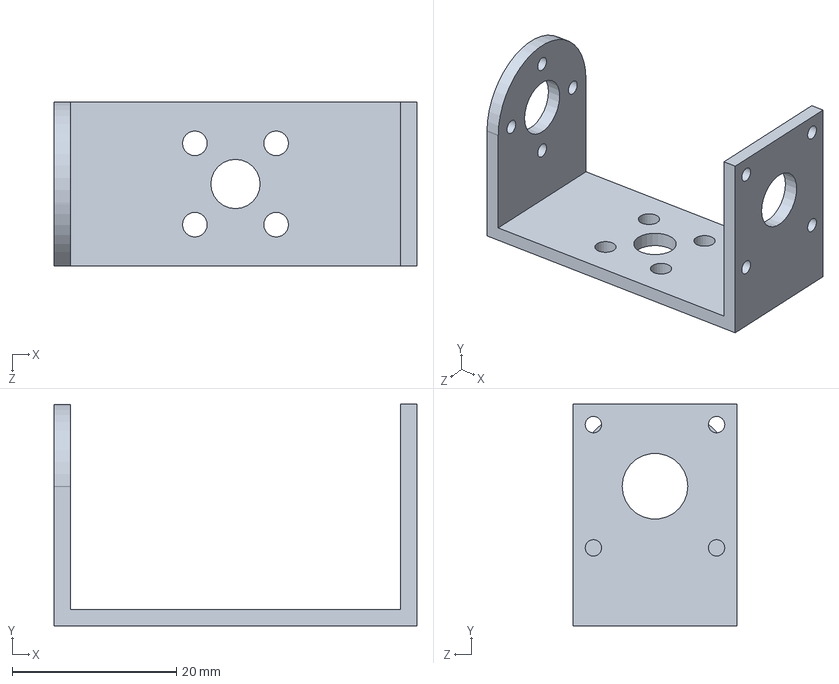
[picture p107: CAD file, 2026-10-14]
cad/No1/3D零件图/双轴舵机3D图/窄U支架.SLDPRT
44.2 x 27.0 x 20.0 mm
