Lucaszyf/Solar-Enhanced-Biomimetic-UAV/cad/No1/3D零件图/斜u支架.STEP

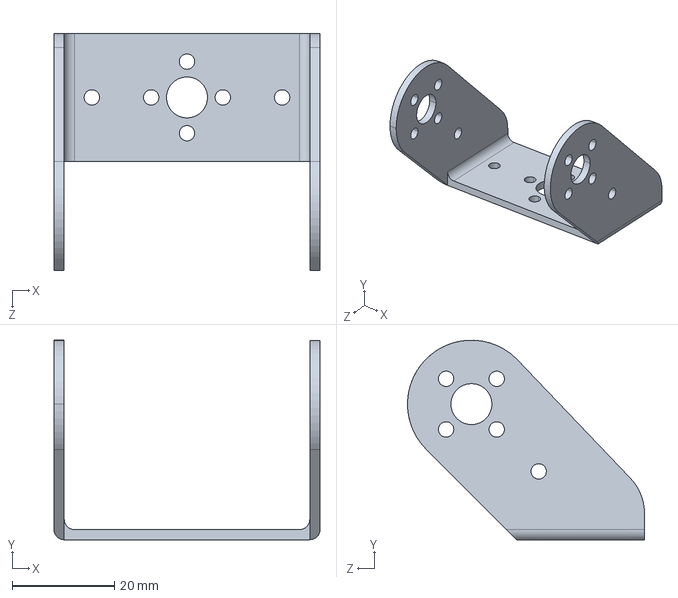
[picture p108: CAD file, 2026-10-14]
cad/No1/3D零件图/斜u支架.STEP
52.0 x 39.0 x 46.3 mm
