Lucaszyf/Solar-Enhanced-Biomimetic-UAV/cad/No1/Lucas_3Dfile/Lucas/outer suction cup.STEP

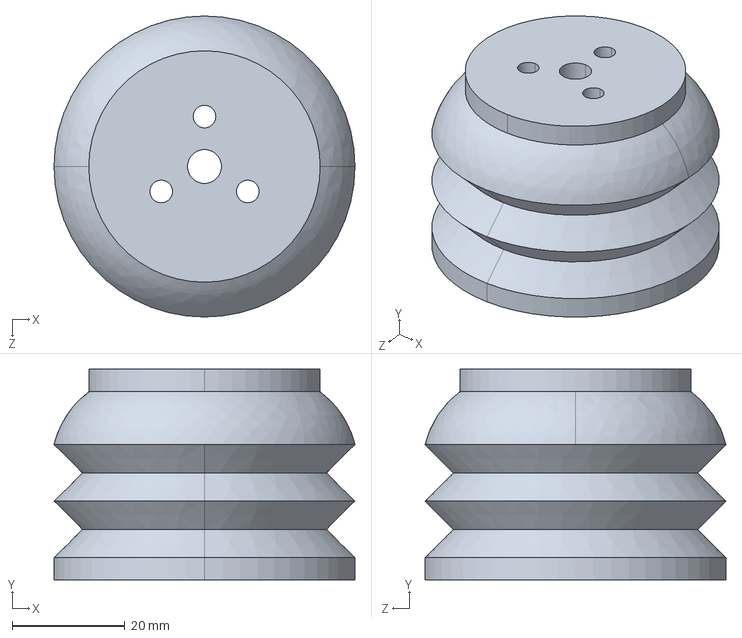
[picture p109: CAD file, 2026-10-14]
cad/No1/Lucas_3Dfile/Lucas/outer suction cup.STEP
53.3 x 37.3 x 53.3 mm
