Lucaszyf/Solar-Enhanced-Biomimetic-UAV/cad/No1/Lucas_3Dfile/part03.SLDPRT

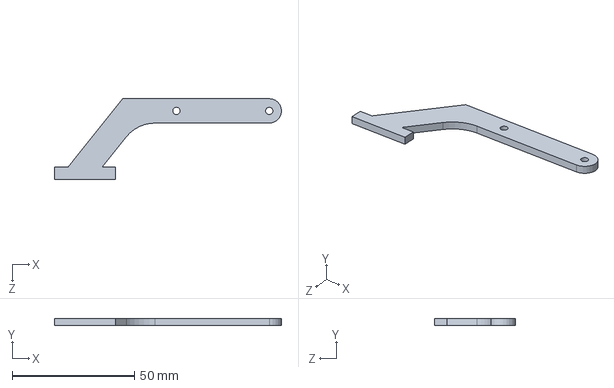
[picture p110: CAD file, 2026-10-14]
cad/No1/Lucas_3Dfile/part03.SLDPRT
92.9 x 3.00 x 33.0 mm
