Lucaszyf/Solar-Enhanced-Biomimetic-UAV/cad/No1/Lucas_3Dfile/机械爪/servo.SLDPRT

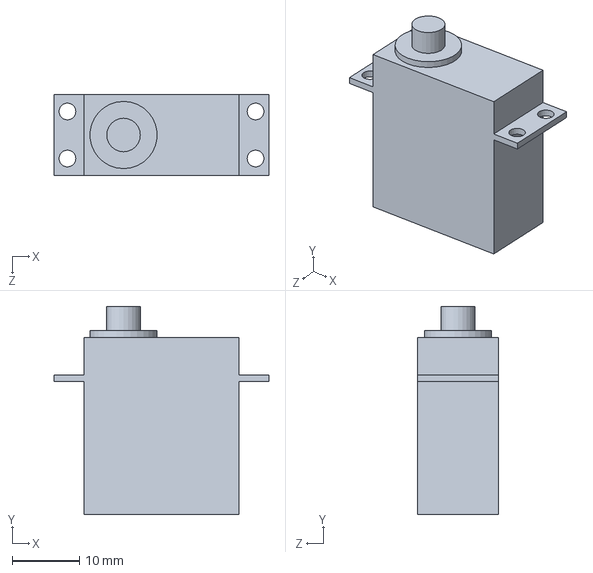
[picture p111: CAD file, 2026-10-14]
cad/No1/Lucas_3Dfile/机械爪/servo.SLDPRT
32.0 x 31.0 x 12.0 mm
