Lucaszyf/Solar-Enhanced-Biomimetic-UAV/cad/No1/吸盘打印件/模型内胆.SLDPRT

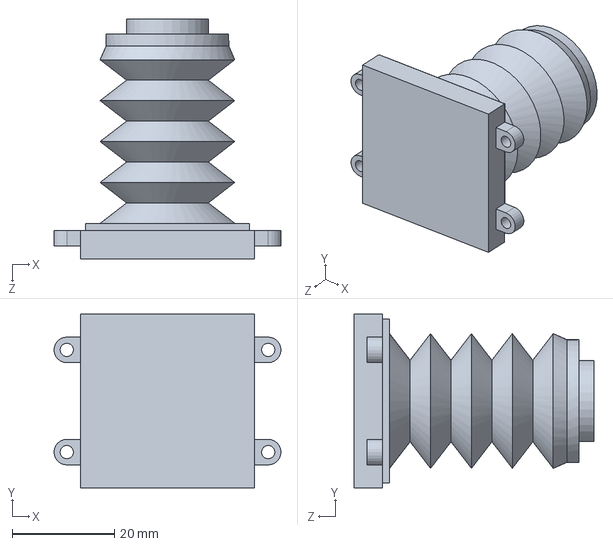
[picture p112: CAD file, 2026-10-14]
cad/No1/吸盘打印件/模型内胆.SLDPRT
44.4 x 34.0 x 47.0 mm
