Lucaszyf/Solar-Enhanced-Biomimetic-UAV/cad/No1/第二版/CON02.SLDPRT

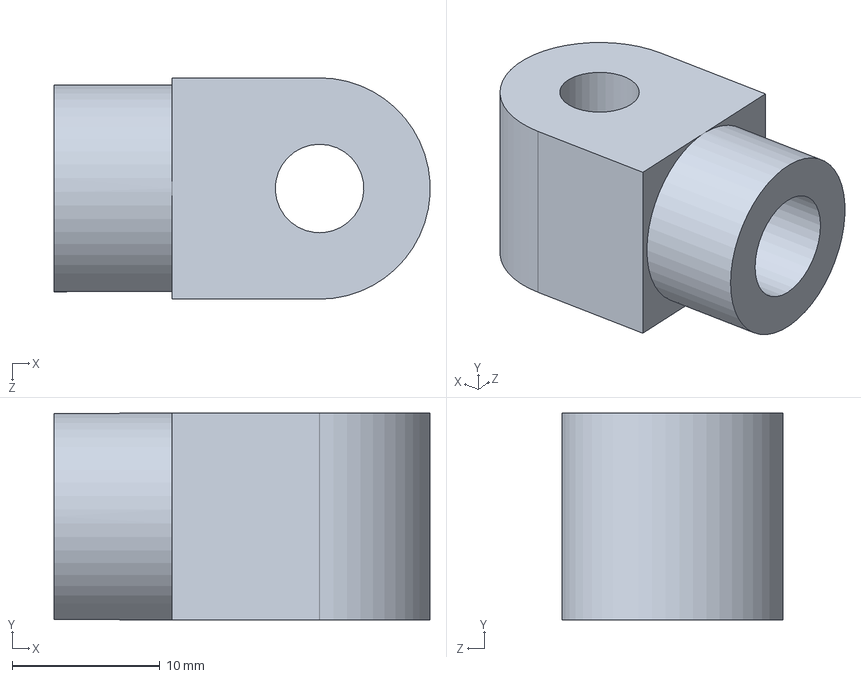
[picture p113: CAD file, 2026-10-14]
cad/No1/第二版/CON02.SLDPRT
25.5 x 14.0 x 15.0 mm
