Lucaszyf/Solar-Enhanced-Biomimetic-UAV/cad/No2/9gServo舵机/servo arm.SLDPRT

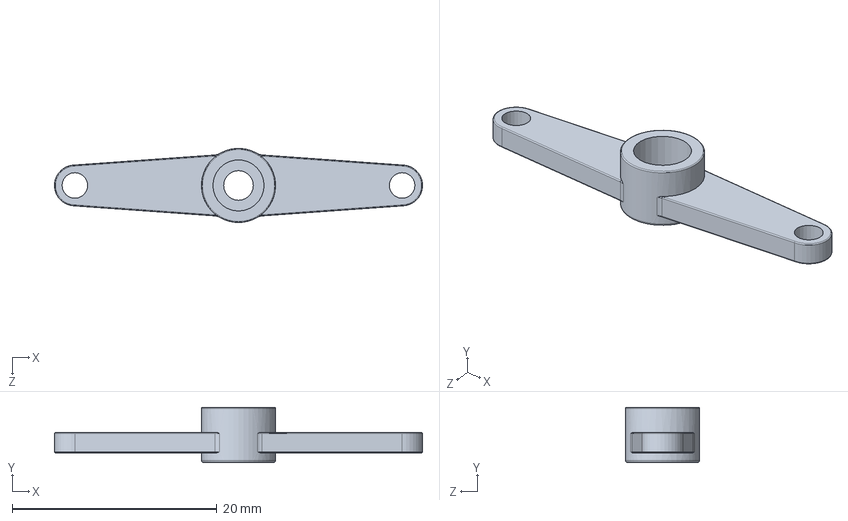
[picture p114: CAD file, 2026-10-14]
cad/No2/9gServo舵机/servo arm.SLDPRT
36.0 x 5.40 x 7.24 mm
