Lucaszyf/Solar-Enhanced-Biomimetic-UAV/cad/No2/N20微型金属齿轮电机/n20_gearbox.SLDPRT

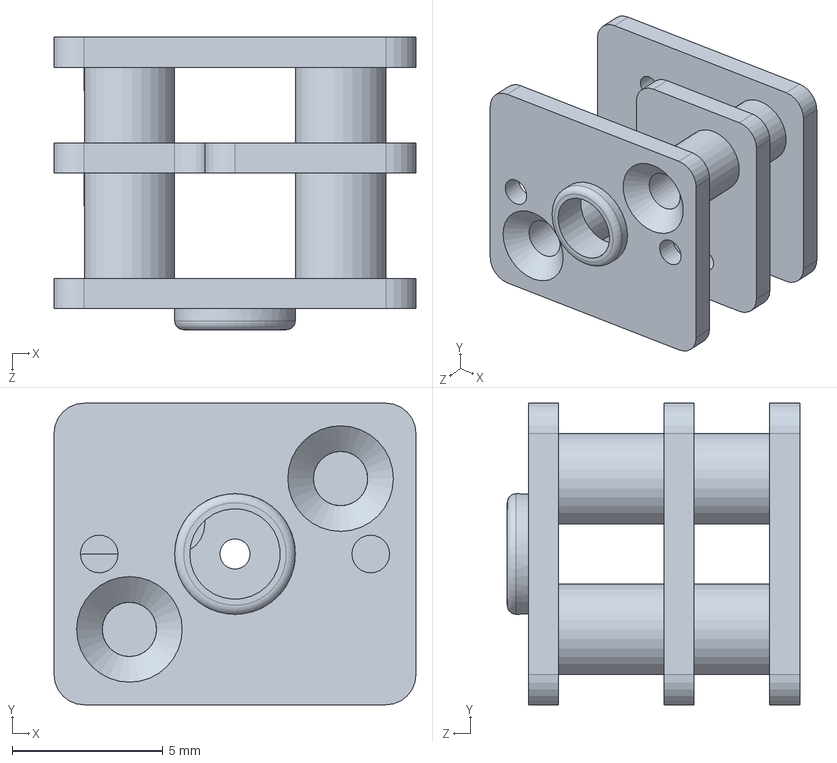
[picture p115: CAD file, 2026-10-14]
cad/No2/N20微型金属齿轮电机/n20_gearbox.SLDPRT
12.0 x 10.0 x 9.70 mm
