Lucaszyf/Solar-Enhanced-Biomimetic-UAV/cad/No2/太阳能折叠总装/temp/files/9g_servo_arm_dual.stl

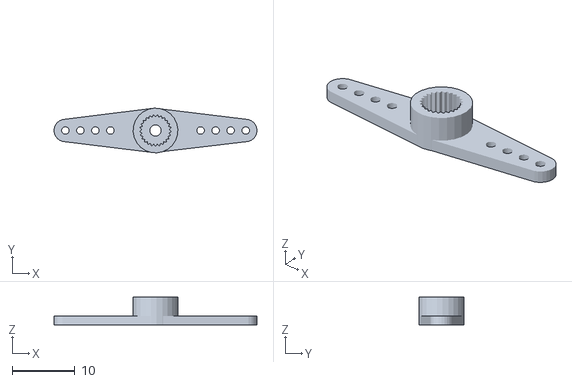
[picture p116: CAD file, 2026-10-14]
cad/No2/太阳能折叠总装/temp/files/9g_servo_arm_dual.stl
32.4 x 7.14 x 4.45
