Lucaszyf/Solar-Enhanced-Biomimetic-UAV/cad/No2/太阳能折叠总装/太阳能板子建模/太阳能板夹持件.SLDPRT

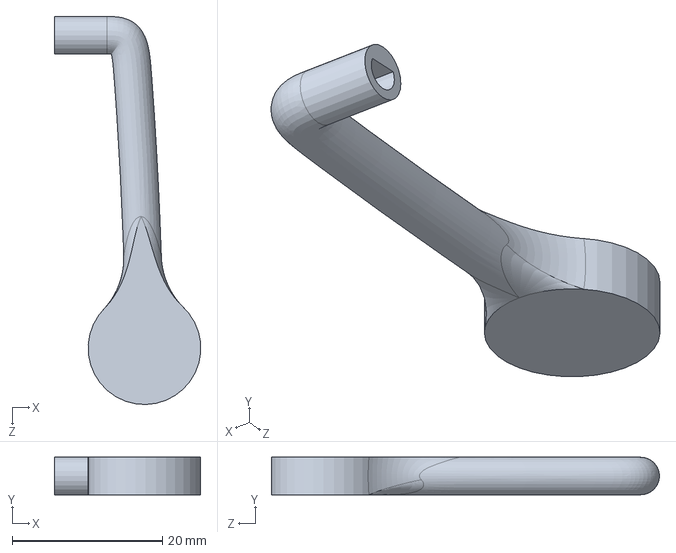
[picture p118: CAD file, 2026-10-14]
cad/No2/太阳能折叠总装/太阳能板子建模/太阳能板夹持件.SLDPRT
19.5 x 5.00 x 51.6 mm
