Lucaszyf/Solar-Enhanced-Biomimetic-UAV/cad/No2/舵机云台/solidworks/base.SLDPRT

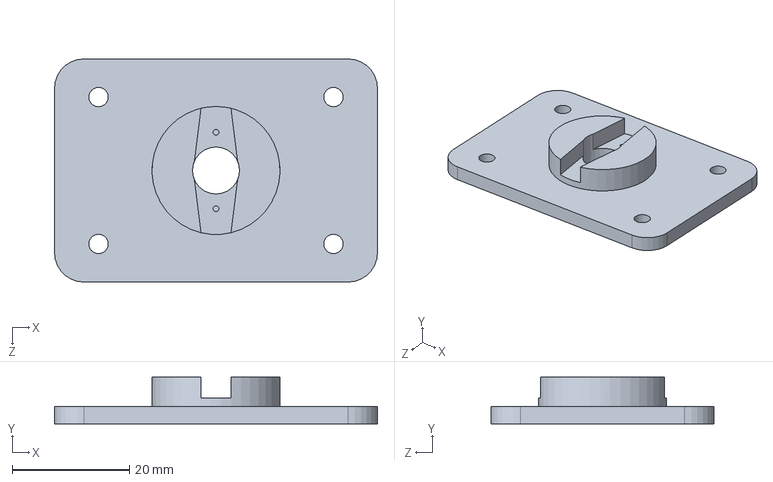
[picture p119: CAD file, 2026-10-14]
cad/No2/舵机云台/solidworks/base.SLDPRT
55.0 x 8.00 x 38.0 mm
