Lucaszyf/Solar-Enhanced-Biomimetic-UAV/cad/No3/三维模型总装配/motor.SLDPRT

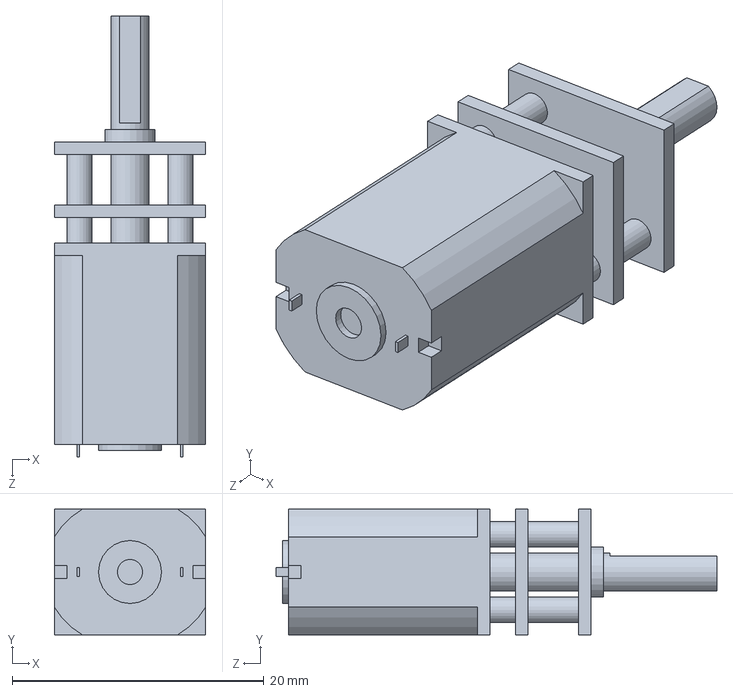
[picture p120: CAD file, 2026-10-14]
cad/No3/三维模型总装配/motor.SLDPRT
12.0 x 10.0 x 35.0 mm
