Lucaszyf/Solar-Enhanced-Biomimetic-UAV/cad/No3/游泳圈建模/6mm下部分碳棍.SLDPRT

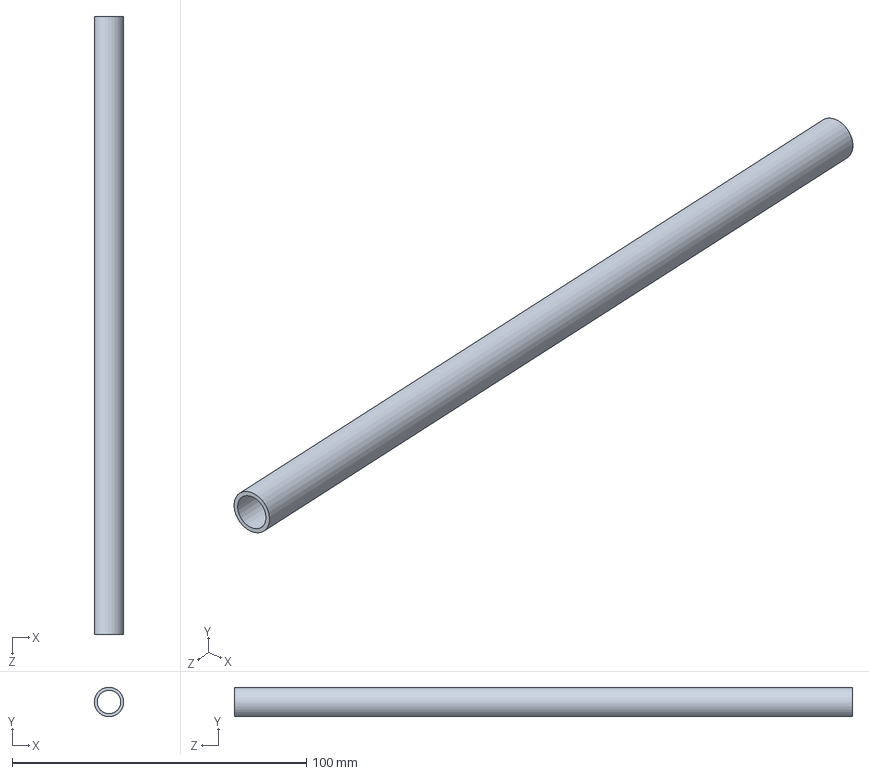
[picture p121: CAD file, 2026-10-14]
cad/No3/游泳圈建模/6mm下部分碳棍.SLDPRT
10.0 x 9.99 x 210.0 mm
