Lucaszyf/Solar-Enhanced-Biomimetic-UAV/cad/华馨京科技 25-50kg 舵机模型图纸（含配件）/华馨京 25-50kg双轴舵机系列/华馨京 25-50kg双轴舵机-3D.STEP

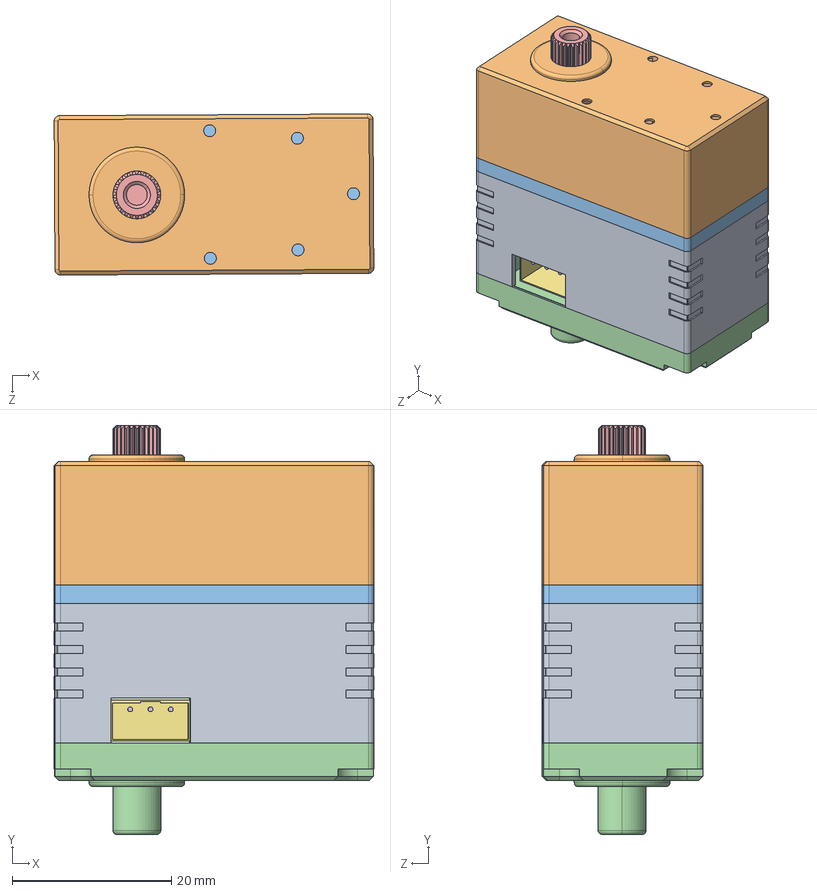
[picture p122: CAD file, 2026-10-14]
cad/华馨京科技 25-50kg 舵机模型图纸（含配件）/华馨京 25-50kg双轴舵机系列/华馨京 25-50kg双轴舵机-3D.STEP
40.1 x 51.3 x 20.2 mm
中段-绿色
ﾉﾏｸﾇ｣ｨﾋｫﾖ皀ｩ
中盖组件
ﾏﾂｸﾇ｣ｨﾋｫﾖ皀ｩ
怀堤喘.step
3pin諉諳.step x 2
