Lucaszyf/Solar-Enhanced-Biomimetic-UAV/cad/华馨京科技 25-50kg 舵机模型图纸（含配件）/华馨京 25-50kg舵机系列配件/华馨京 25-50kg舵机系列主舵盘（四孔）-3D.STEP

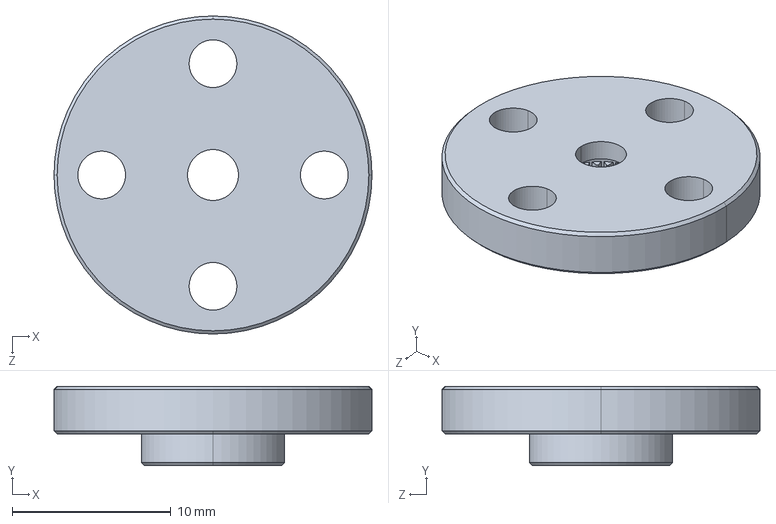
[picture p123: CAD file, 2026-10-14]
cad/华馨京科技 25-50kg 舵机模型图纸（含配件）/华馨京 25-50kg舵机系列配件/华馨京 25-50kg舵机系列主舵盘（四孔）-3D.STEP
20.0 x 5.00 x 20.0 mm
