Lucaszyf/Solar-Enhanced-Biomimetic-UAV/cad/华馨京科技 25-50kg 舵机模型图纸（含配件）/华馨京 舵机 D型输出轴系列/华馨京 单轴舵机 RX8-U29H-M D型输出轴/华馨京 RX8-U29H-M 3D.STEP

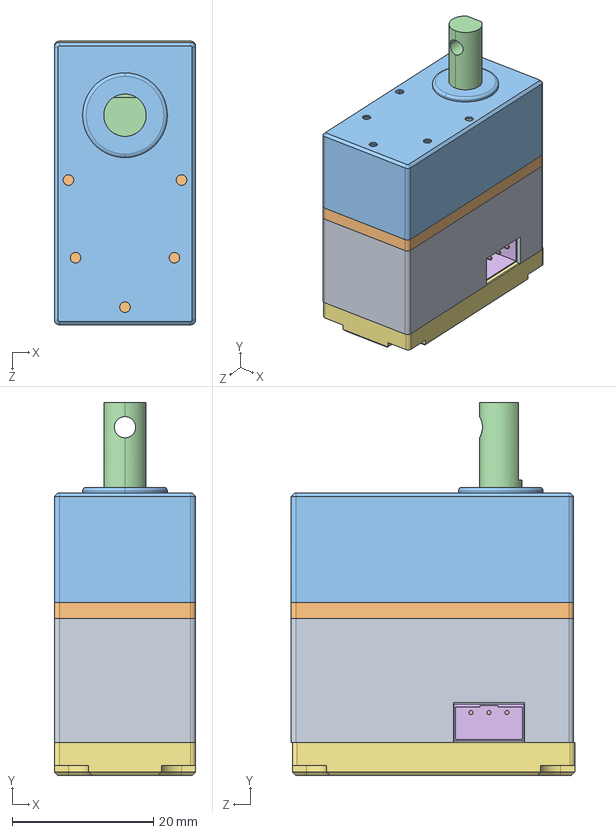
[picture p125: CAD file, 2026-10-14]
cad/华馨京科技 25-50kg 舵机模型图纸（含配件）/华馨京 舵机 D型输出轴系列/华馨京 单轴舵机 RX8-U29H-M D型输出轴/华馨京 RX8-U29H-M 3D.STEP
20.0 x 52.8 x 40.2 mm
442D笢僇
442D中盖组件
442Dﾉﾏｸﾇ｣ｨﾋｫﾖ皀ｩ
D型输出齿.step
3pin諉諳.step x 2
442D下盖（单轴）.step
