Lucaszyf/Solar-Enhanced-Biomimetic-UAV/cad/No1/3D尺寸图/舵机外形图/35KG铝壳舵机双出轴外形图.SLDPRT

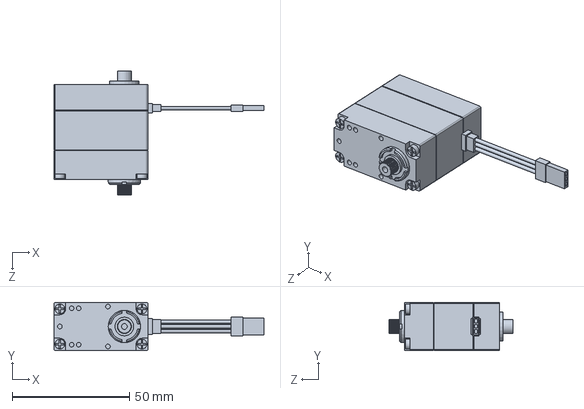
[picture p126: CAD file, 2026-10-14]
cad/No1/3D尺寸图/舵机外形图/35KG铝壳舵机双出轴外形图.SLDPRT
89.5 x 20.5 x 52.8 mm
