Lucaszyf/Solar-Enhanced-Biomimetic-UAV/cad/No1/3D零件图/单轴舵机.SLDPRT

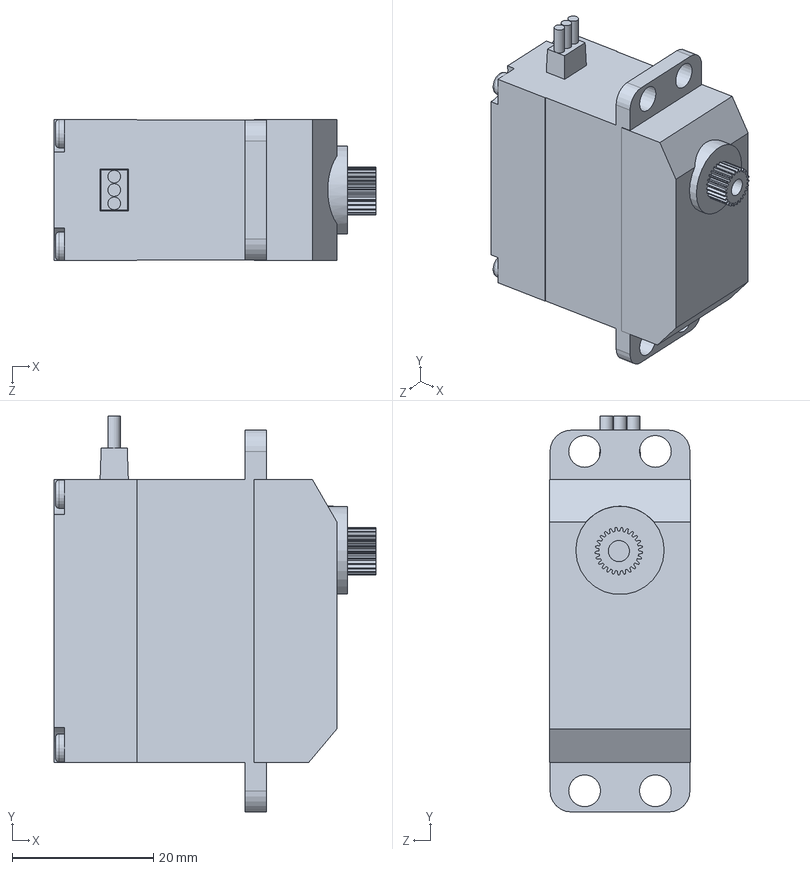
[picture p127: CAD file, 2026-10-14]
cad/No1/3D零件图/单轴舵机.SLDPRT
45.5 x 56.0 x 20.0 mm
