Lucaszyf/Solar-Enhanced-Biomimetic-UAV/cad/No1/Lucas_3Dfile/Lucas/outerconnectorv2.STEP

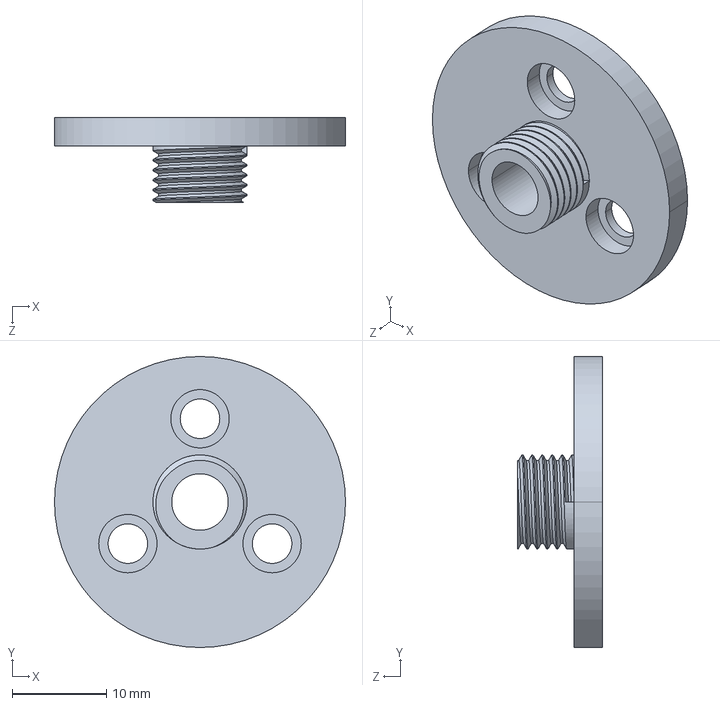
[picture p129: CAD file, 2026-10-14]
cad/No1/Lucas_3Dfile/Lucas/outerconnectorv2.STEP
30.9 x 30.9 x 9.00 mm
