Lucaszyf/Solar-Enhanced-Biomimetic-UAV/cad/No1/Lucas_3Dfile/上模具.SLDPRT

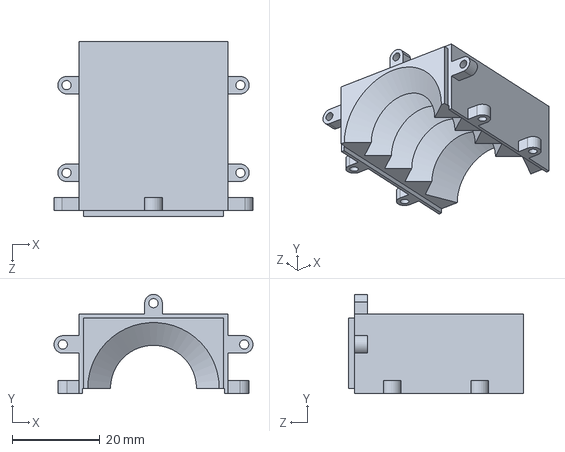
[picture p130: CAD file, 2026-10-14]
cad/No1/Lucas_3Dfile/上模具.SLDPRT
45.4 x 22.6 x 40.0 mm
