Lucaszyf/Solar-Enhanced-Biomimetic-UAV/cad/No1/Lucas_3Dfile/尼龙碳纤维打印/蜗轮27×1.STEP

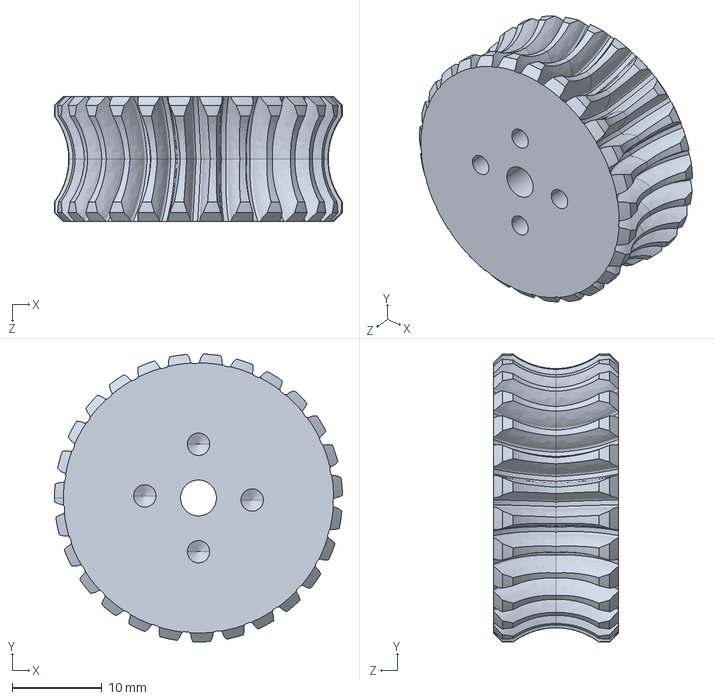
[picture p131: CAD file, 2026-10-14]
cad/No1/Lucas_3Dfile/尼龙碳纤维打印/蜗轮27×1.STEP
32.2 x 32.2 x 14.0 mm
