Lucaszyf/Solar-Enhanced-Biomimetic-UAV/cad/No1/Lucas_3Dfile/机械爪/part04.SLDPRT

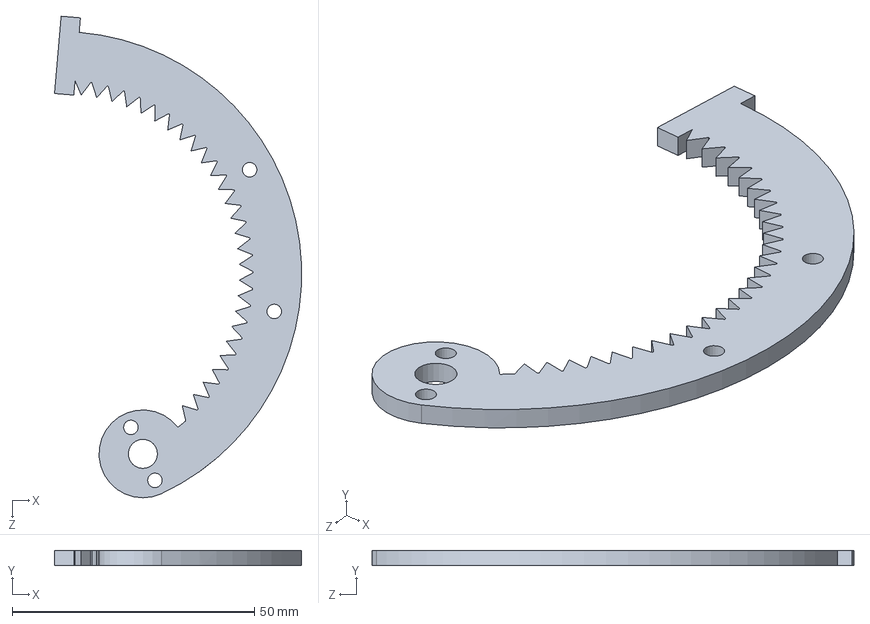
[picture p132: CAD file, 2026-10-14]
cad/No1/Lucas_3Dfile/机械爪/part04.SLDPRT
51.0 x 3.00 x 99.4 mm
