Lucaszyf/Solar-Enhanced-Biomimetic-UAV/cad/No1/吸盘打印件/吸盘支撑延长座.SLDPRT

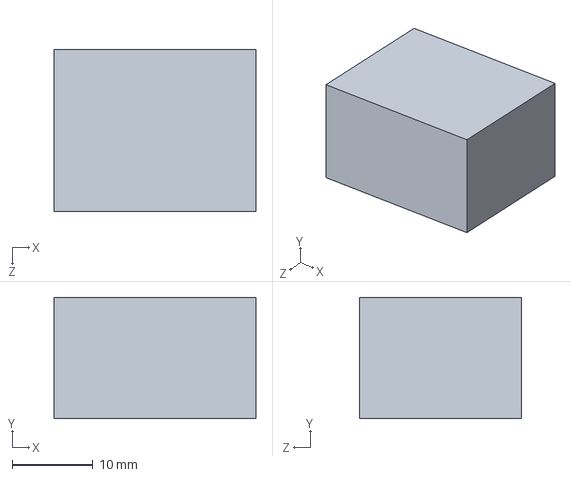
[picture p133: CAD file, 2026-10-14]
cad/No1/吸盘打印件/吸盘支撑延长座.SLDPRT
25.0 x 15.0 x 20.0 mm
