Lucaszyf/Solar-Enhanced-Biomimetic-UAV/cad/No1/第二版/body.SLDPRT

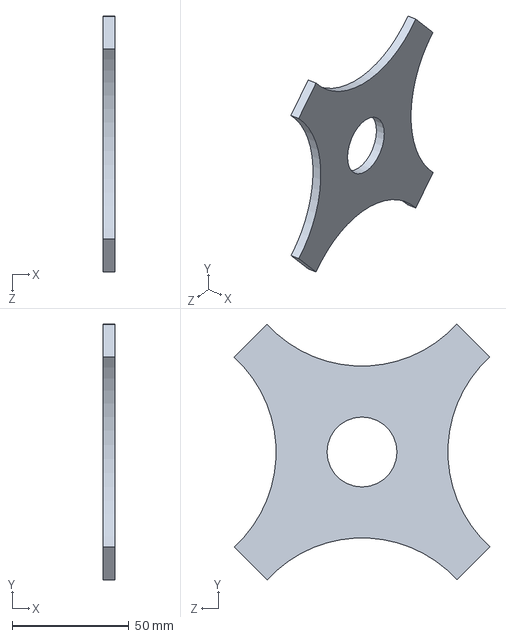
[picture p134: CAD file, 2026-10-14]
cad/No1/第二版/body.SLDPRT
5.00 x 109.8 x 109.8 mm
