Lucaszyf/Solar-Enhanced-Biomimetic-UAV/cad/No2/太阳能折叠总装/temp/files/9g_servo_arm_round.stl

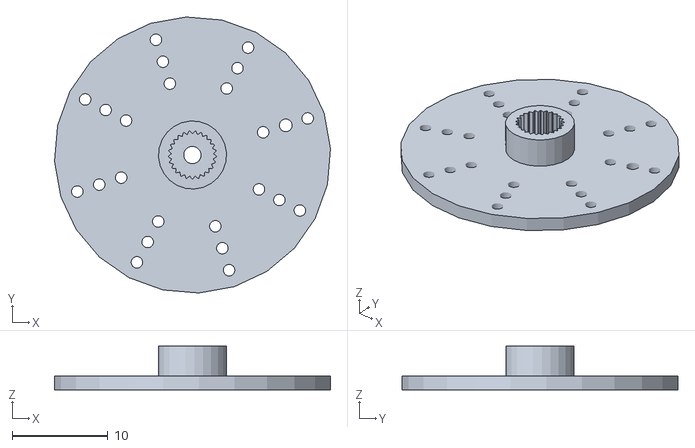
[picture p135: CAD file, 2026-10-14]
cad/No2/太阳能折叠总装/temp/files/9g_servo_arm_round.stl
28.8 x 28.8 x 4.57
