Lucaszyf/Solar-Enhanced-Biomimetic-UAV/cad/No2/太阳能折叠总装/支架test1_v1.SLDPRT

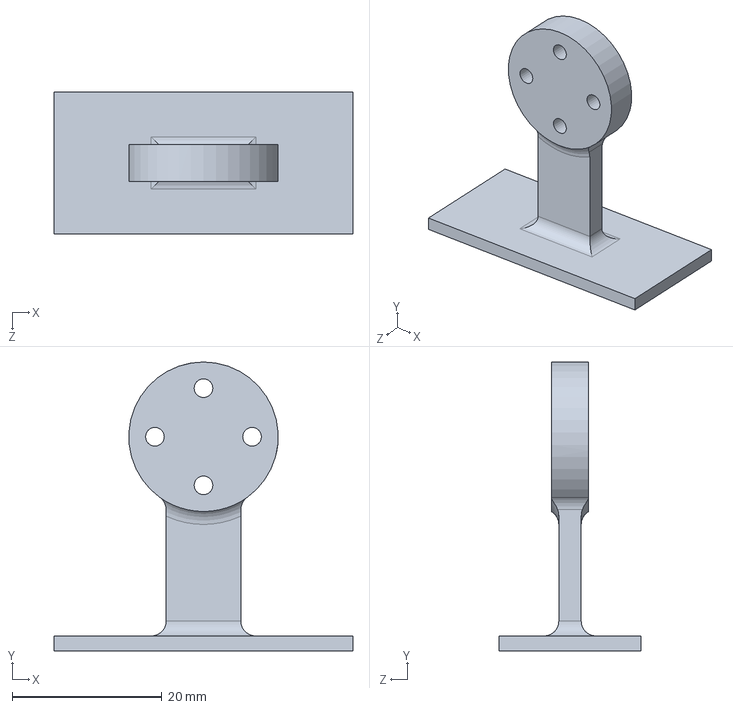
[picture p136: CAD file, 2026-10-14]
cad/No2/太阳能折叠总装/支架test1_v1.SLDPRT
40.0 x 38.7 x 19.0 mm
