Lucaszyf/Solar-Enhanced-Biomimetic-UAV/cad/No2/舵机云台/solidworks/head.SLDPRT

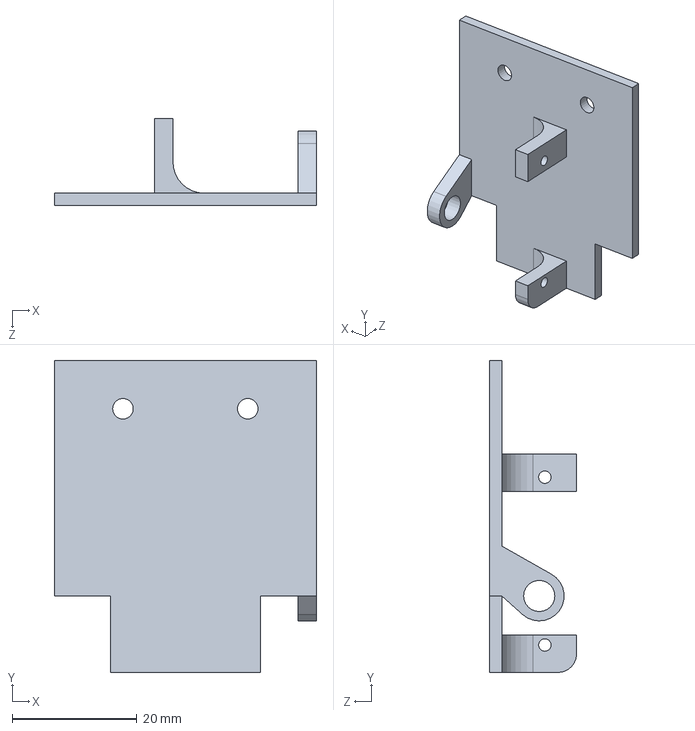
[picture p137: CAD file, 2026-10-14]
cad/No2/舵机云台/solidworks/head.SLDPRT
42.0 x 50.0 x 14.0 mm
