Lucaszyf/Solar-Enhanced-Biomimetic-UAV/cad/No3/游泳圈建模/rotate.SLDPRT

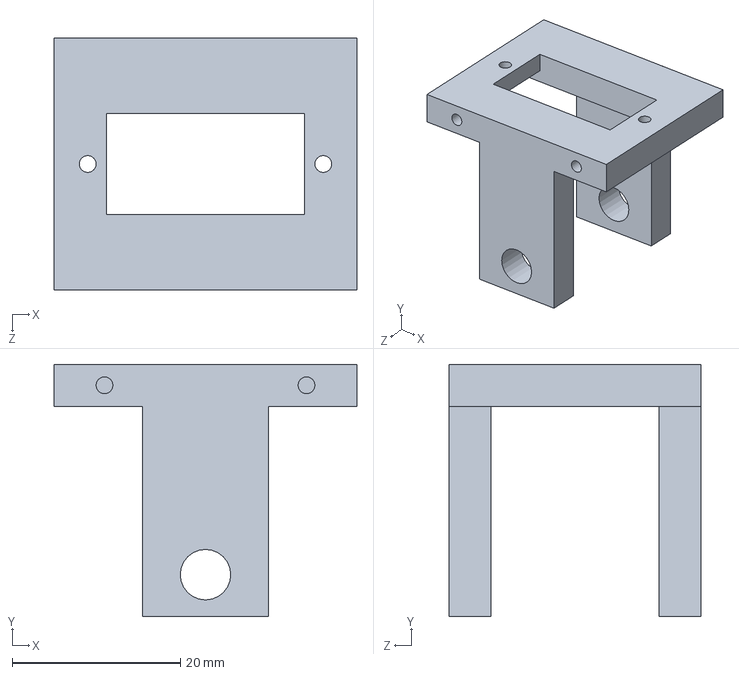
[picture p138: CAD file, 2026-10-14]
cad/No3/游泳圈建模/rotate.SLDPRT
36.0 x 30.0 x 30.0 mm
