Lucaszyf/Solar-Enhanced-Biomimetic-UAV/cad/华馨京科技 25-50kg 舵机模型图纸（含配件）/华馨京 25-50kg舵机系列配件/华馨京 25-50kg舵机系列U型舵盘支架（标准）-3D.STEP

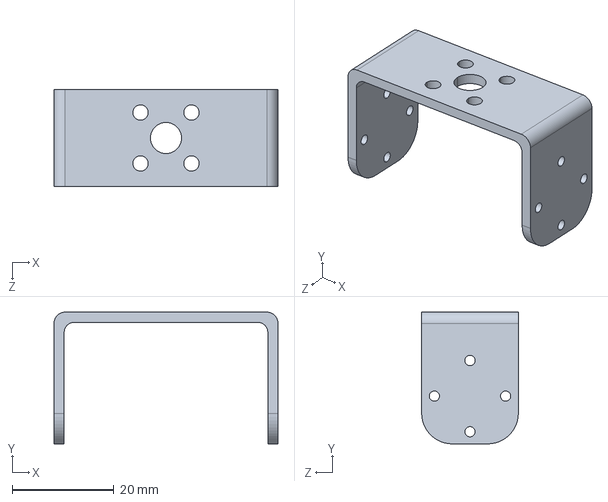
[picture p139: CAD file, 2026-10-14]
cad/华馨京科技 25-50kg 舵机模型图纸（含配件）/华馨京 25-50kg舵机系列配件/华馨京 25-50kg舵机系列U型舵盘支架（标准）-3D.STEP
44.0 x 25.9 x 19.0 mm
