Lucaszyf/Solar-Enhanced-Biomimetic-UAV/cad/No1/3D尺寸图/舵机外形图/9克（TS90A）微型数字舵机.SLDPRT

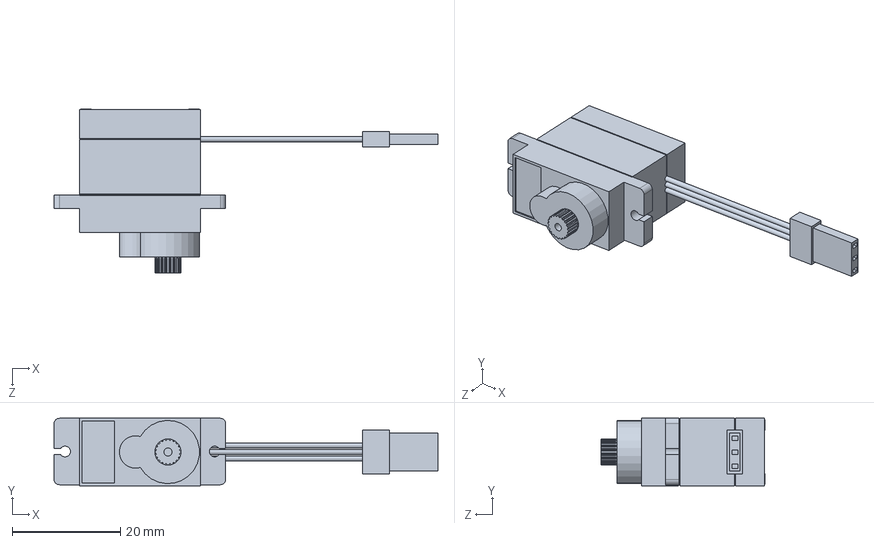
[picture p140: CAD file, 2026-10-14]
cad/No1/3D尺寸图/舵机外形图/9克（TS90A）微型数字舵机.SLDPRT
71.1 x 12.5 x 30.4 mm
