Lucaszyf/Solar-Enhanced-Biomimetic-UAV/cad/No1/3D零件图/双轴舵机3D图/长U支架.SLDPRT

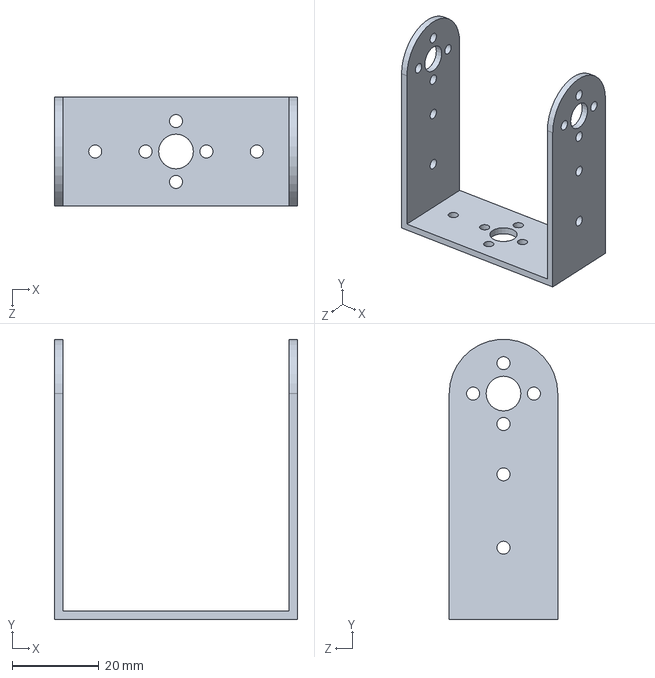
[picture p141: CAD file, 2026-10-14]
cad/No1/3D零件图/双轴舵机3D图/长U支架.SLDPRT
56.0 x 64.4 x 25.0 mm
