Lucaszyf/Solar-Enhanced-Biomimetic-UAV/cad/No1/3D零件图/多功能支架.SLDPRT

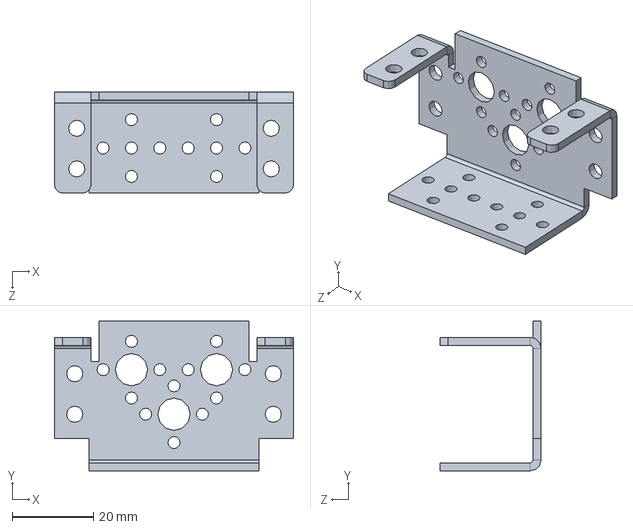
[picture p142: CAD file, 2026-10-14]
cad/No1/3D零件图/多功能支架.SLDPRT
59.0 x 37.0 x 25.0 mm
