Lucaszyf/Solar-Enhanced-Biomimetic-UAV/cad/No1/Lucas_3Dfile/太阳能板夹持件.SLDPRT

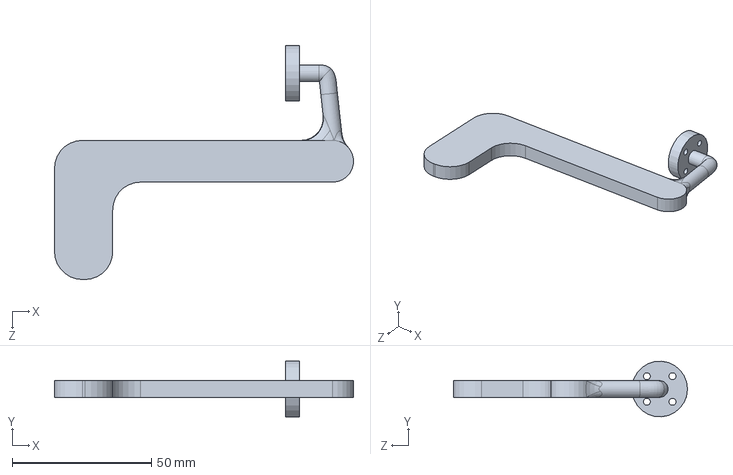
[picture p143: CAD file, 2026-10-14]
cad/No1/Lucas_3Dfile/太阳能板夹持件.SLDPRT
107.5 x 20.0 x 84.1 mm
