Lucaszyf/Solar-Enhanced-Biomimetic-UAV/cad/No1/Lucas_3Dfile/机械爪/圆柱齿轮17×1.25.SLDPRT

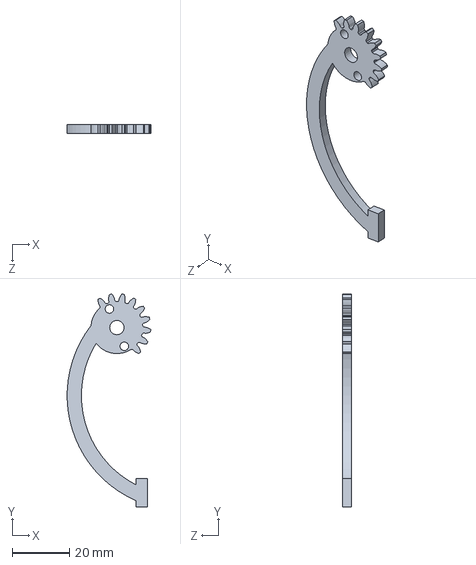
[picture p144: CAD file, 2026-10-14]
cad/No1/Lucas_3Dfile/机械爪/圆柱齿轮17×1.25.SLDPRT
29.2 x 74.4 x 3.00 mm
