Lucaszyf/Solar-Enhanced-Biomimetic-UAV/cad/No1/吸盘打印件/uphalfmold.SLDPRT

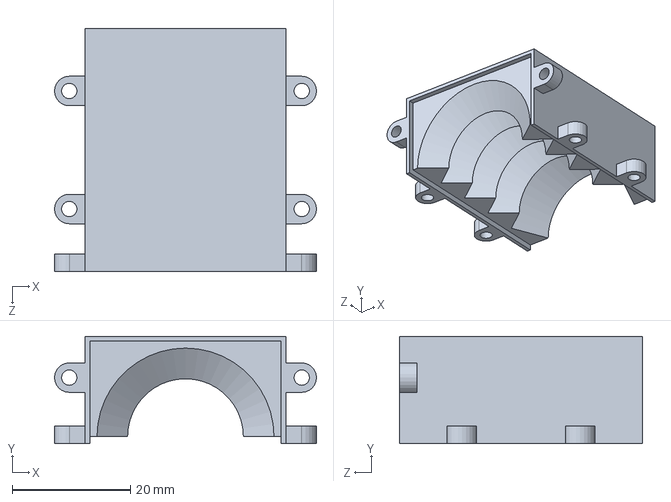
[picture p145: CAD file, 2026-10-14]
cad/No1/吸盘打印件/uphalfmold.SLDPRT
44.4 x 18.2 x 41.2 mm
