Lucaszyf/Solar-Enhanced-Biomimetic-UAV/cad/No1/第二版/bear10x6x3.SLDPRT

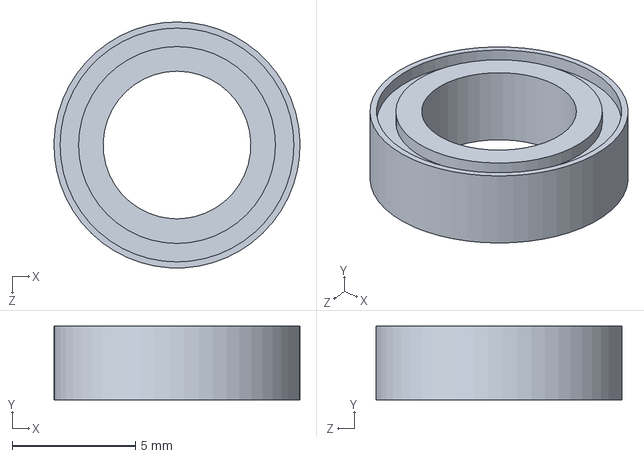
[picture p146: CAD file, 2026-10-14]
cad/No1/第二版/bear10x6x3.SLDPRT
10.00 x 3.00 x 10.0 mm
