Lucaszyf/Solar-Enhanced-Biomimetic-UAV/cad/No2/N20微型金属齿轮电机/n20_shaft.SLDPRT

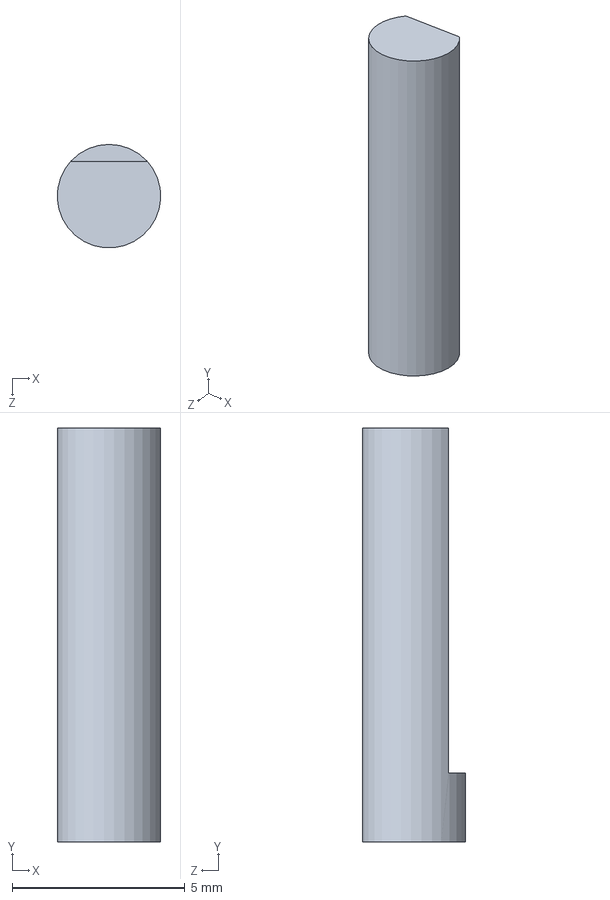
[picture p147: CAD file, 2026-10-14]
cad/No2/N20微型金属齿轮电机/n20_shaft.SLDPRT
3.00 x 12.0 x 2.99 mm
