Lucaszyf/Solar-Enhanced-Biomimetic-UAV/cad/No2/太阳能折叠总装/temp/files/9g_servo_arm_set.stl

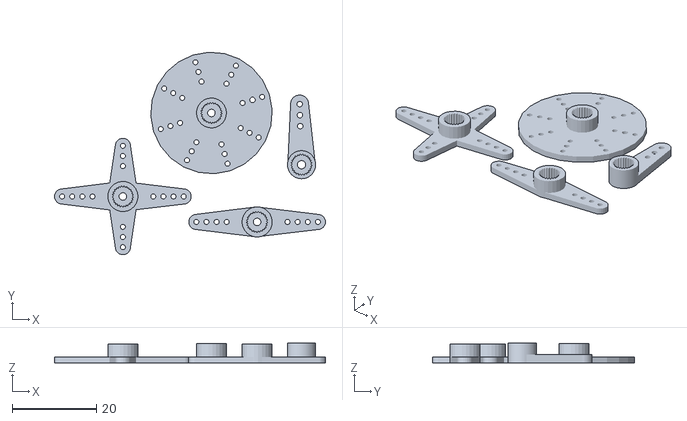
[picture p148: CAD file, 2026-10-14]
cad/No2/太阳能折叠总装/temp/files/9g_servo_arm_set.stl
64.2 x 48.0 x 4.70
