Lucaszyf/Solar-Enhanced-Biomimetic-UAV/cad/No2/太阳能折叠总装/喷水装置齿轮.SLDPRT

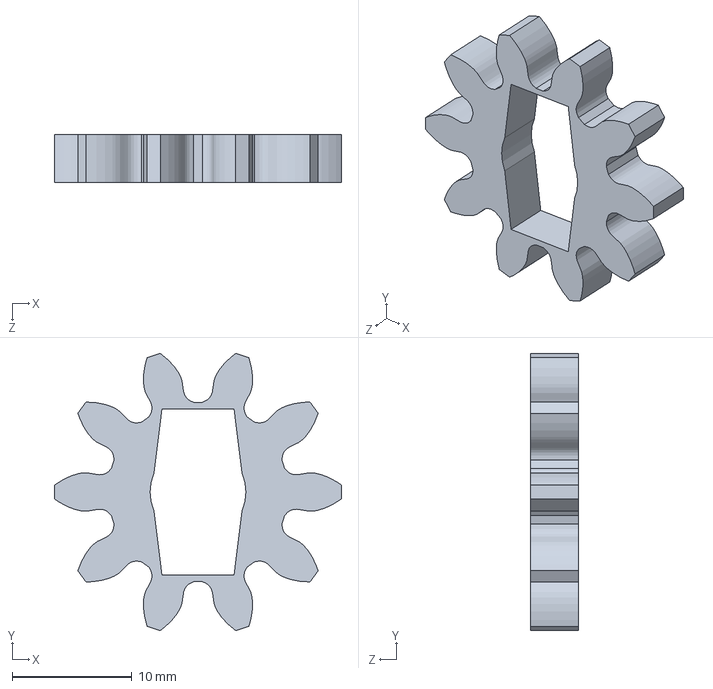
[picture p149: CAD file, 2026-10-14]
cad/No2/太阳能折叠总装/喷水装置齿轮.SLDPRT
24.0 x 23.2 x 4.00 mm
