Lucaszyf/Solar-Enhanced-Biomimetic-UAV/cad/No2/太阳能折叠总装/太阳能板子建模/圆柱齿轮17×2.SLDPRT

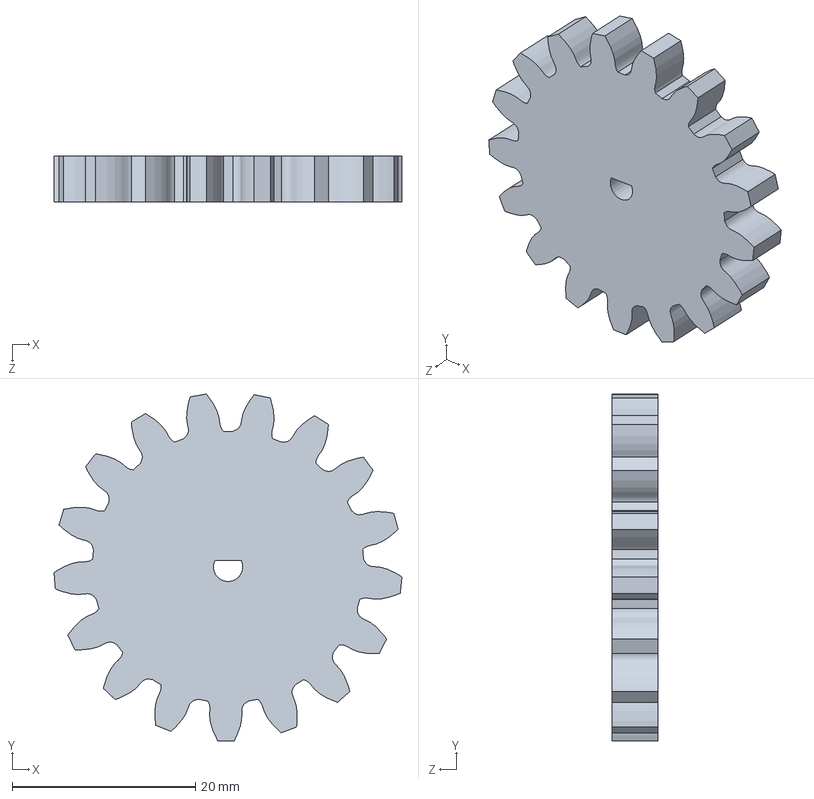
[picture p150: CAD file, 2026-10-14]
cad/No2/太阳能折叠总装/太阳能板子建模/圆柱齿轮17×2.SLDPRT
38.0 x 37.8 x 5.00 mm
