Lucaszyf/Solar-Enhanced-Biomimetic-UAV/cad/No2/舵机云台/solidworks/rotate.SLDPRT

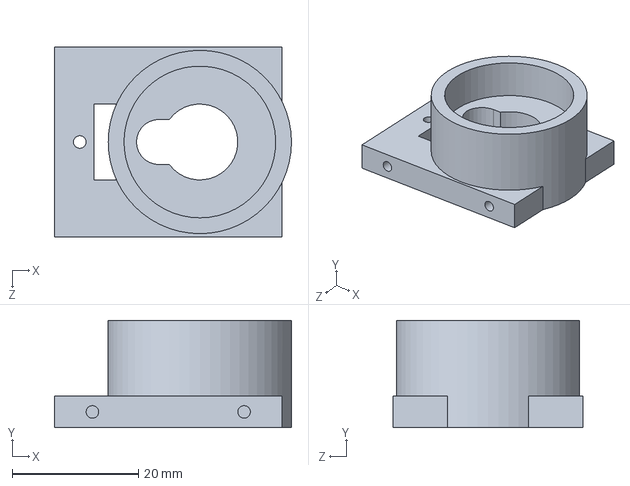
[picture p151: CAD file, 2026-10-14]
cad/No2/舵机云台/solidworks/rotate.SLDPRT
37.5 x 17.0 x 30.0 mm
