Lucaszyf/Solar-Enhanced-Biomimetic-UAV/cad/No3/游泳圈建模/3mm_v1.SLDPRT

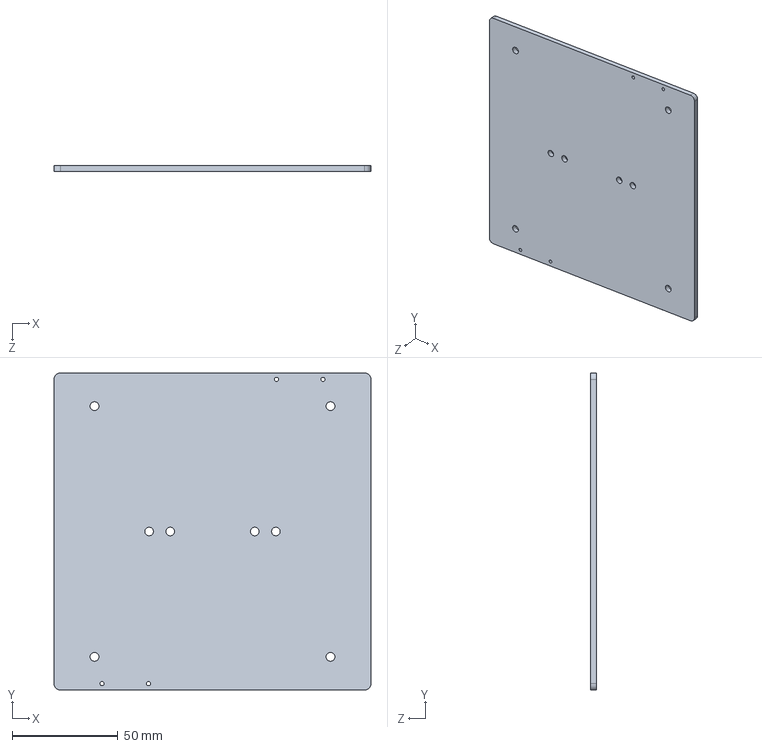
[picture p152: CAD file, 2026-10-14]
cad/No3/游泳圈建模/3mm_v1.SLDPRT
150.0 x 150.0 x 3.00 mm
