Lucaszyf/Solar-Enhanced-Biomimetic-UAV/cad/No1/3D尺寸图/12KG舵机半金属外形图.SLDPRT

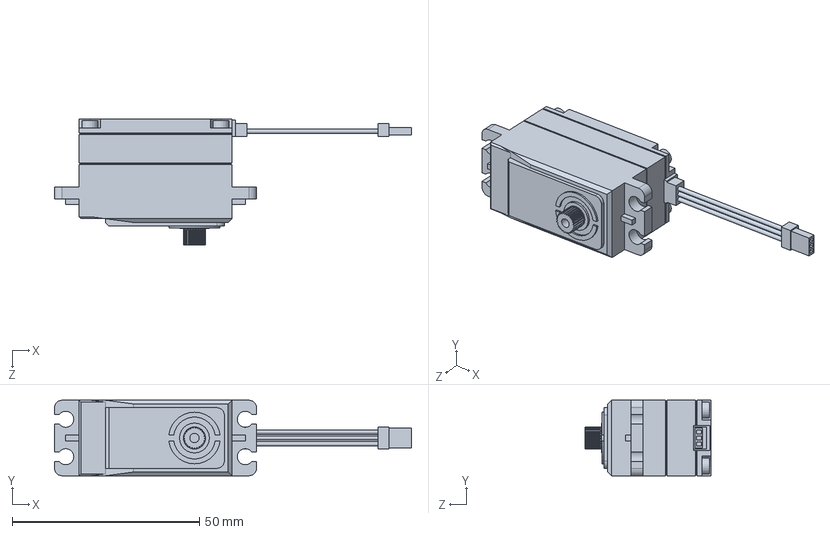
[picture p154: CAD file, 2026-10-14]
cad/No1/3D尺寸图/12KG舵机半金属外形图.SLDPRT
95.4 x 20.2 x 33.8 mm
