Lucaszyf/Solar-Enhanced-Biomimetic-UAV/cad/No1/3D零件图/双轴舵机3D图/实轴舵盘.SLDPRT

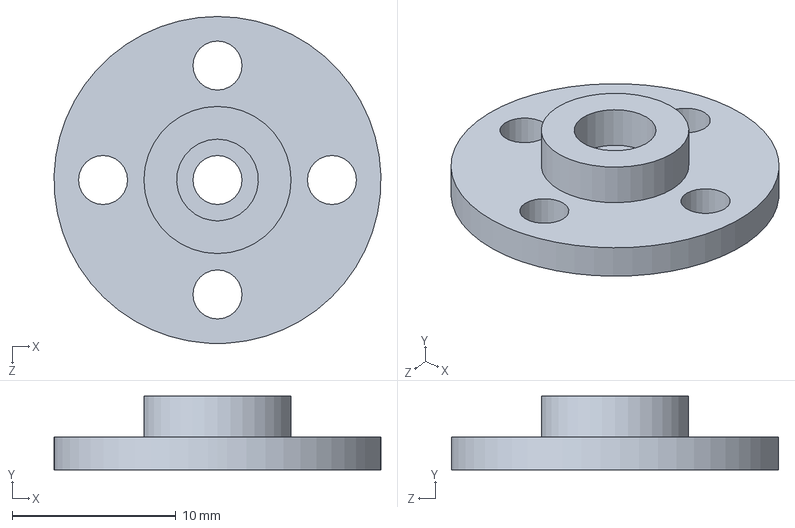
[picture p155: CAD file, 2026-10-14]
cad/No1/3D零件图/双轴舵机3D图/实轴舵盘.SLDPRT
20.0 x 4.50 x 20.0 mm
