Lucaszyf/Solar-Enhanced-Biomimetic-UAV/cad/No1/3D零件图/杯士轴承.SLDPRT

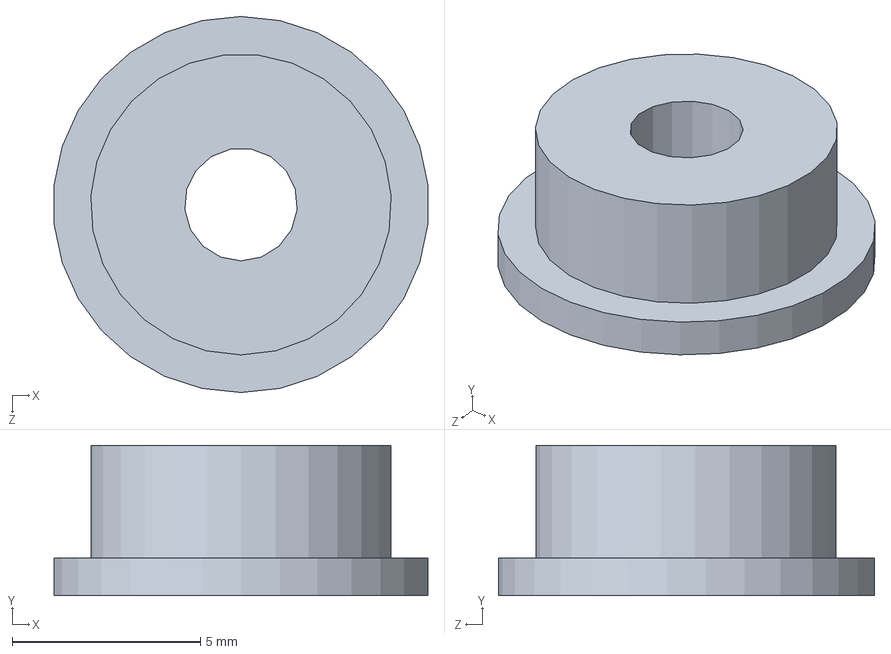
[picture p156: CAD file, 2026-10-14]
cad/No1/3D零件图/杯士轴承.SLDPRT
9.95 x 4.00 x 10.0 mm
