Lucaszyf/Solar-Enhanced-Biomimetic-UAV/cad/No1/Lucas_3Dfile/尼龙碳纤维打印/折叠架电机.STEP

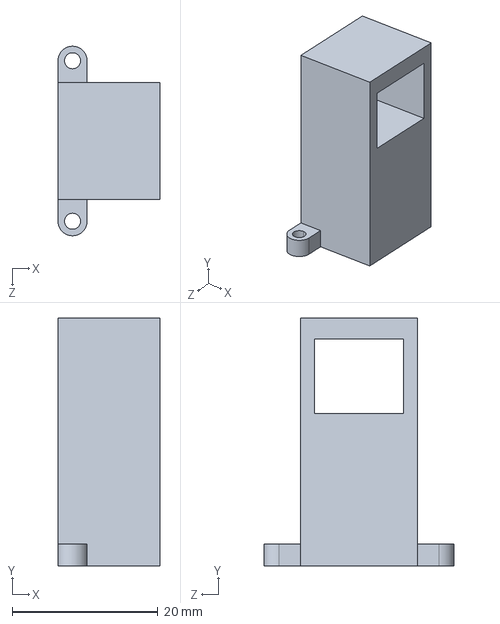
[picture p157: CAD file, 2026-10-14]
cad/No1/Lucas_3Dfile/尼龙碳纤维打印/折叠架电机.STEP
14.0 x 34.0 x 26.0 mm
