Lucaszyf/Solar-Enhanced-Biomimetic-UAV/cad/No1/Lucas_3Dfile/机械爪/part05.SLDPRT

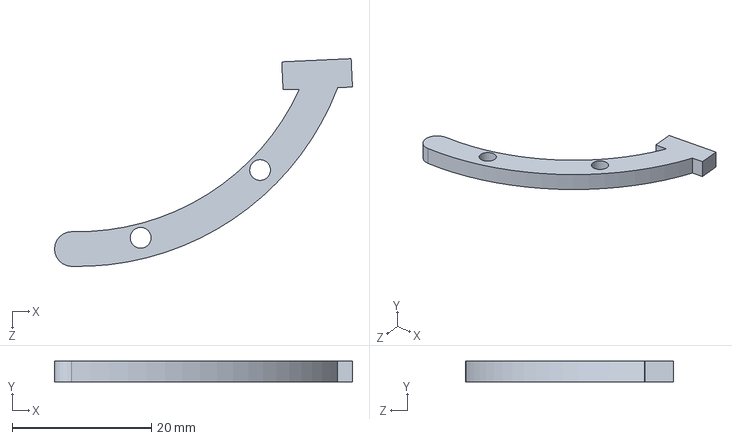
[picture p158: CAD file, 2026-10-14]
cad/No1/Lucas_3Dfile/机械爪/part05.SLDPRT
42.9 x 3.00 x 29.9 mm
