Lucaszyf/Solar-Enhanced-Biomimetic-UAV/cad/No1/吸盘打印件/内胆.STEP

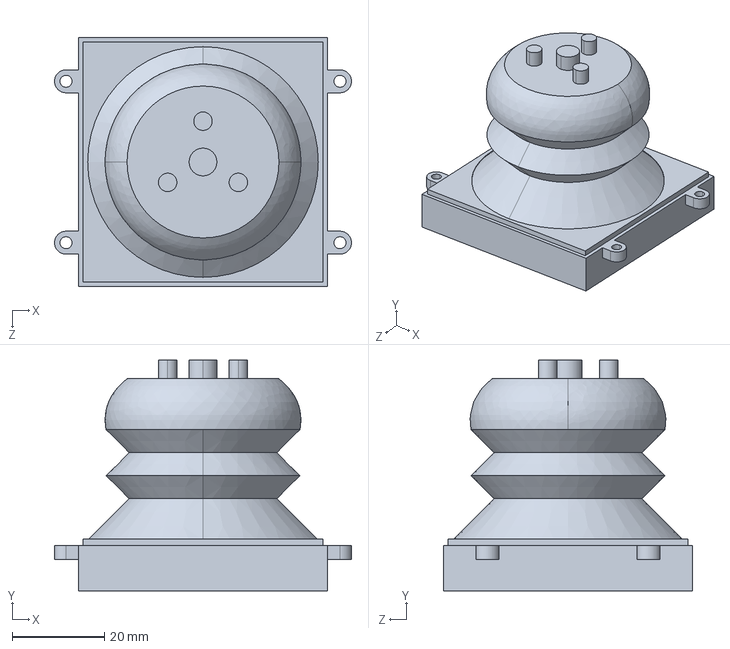
[picture p159: CAD file, 2026-10-14]
cad/No1/吸盘打印件/内胆.STEP
64.4 x 50.0 x 54.0 mm
