Lucaszyf/Solar-Enhanced-Biomimetic-UAV/cad/No2/太阳能折叠总装/temp/files/9g_servo_arm_quad.stl

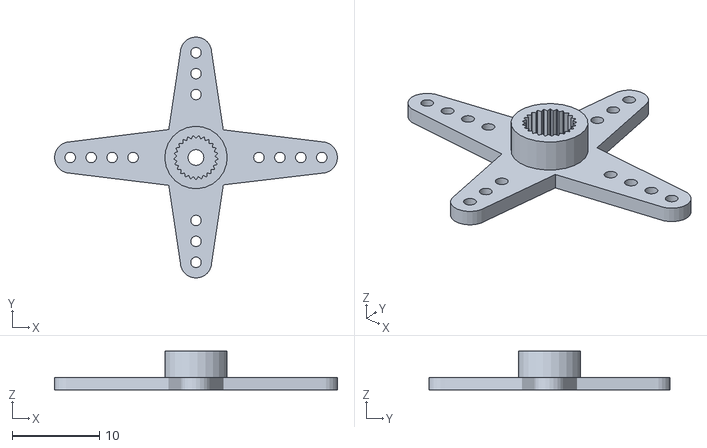
[picture p160: CAD file, 2026-10-14]
cad/No2/太阳能折叠总装/temp/files/9g_servo_arm_quad.stl
32.4 x 27.6 x 4.45
