Lucaszyf/Solar-Enhanced-Biomimetic-UAV/cad/No3/三维模型总装配/N20_A.SLDPRT

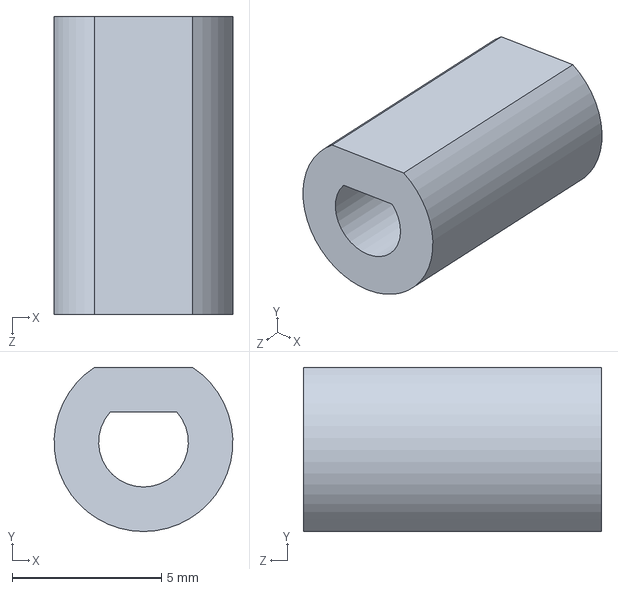
[picture p161: CAD file, 2026-10-14]
cad/No3/三维模型总装配/N20_A.SLDPRT
5.99 x 5.51 x 10.0 mm
