Lucaszyf/Solar-Enhanced-Biomimetic-UAV/cad/No1/3D尺寸图/TS90A.STEP

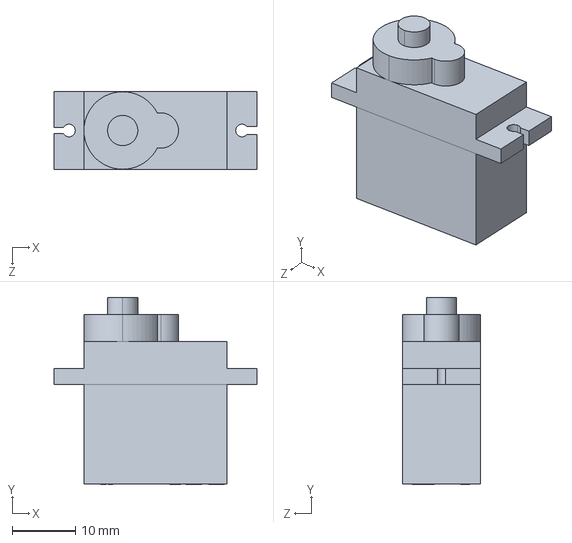
[picture p162: CAD file, 2026-10-14]
cad/No1/3D尺寸图/TS90A.STEP
32.2 x 29.7 x 12.3 mm
