Lucaszyf/Solar-Enhanced-Biomimetic-UAV/cad/No1/3D尺寸图/舵机外形图/40KG铝壳舵机外形图.SLDPRT

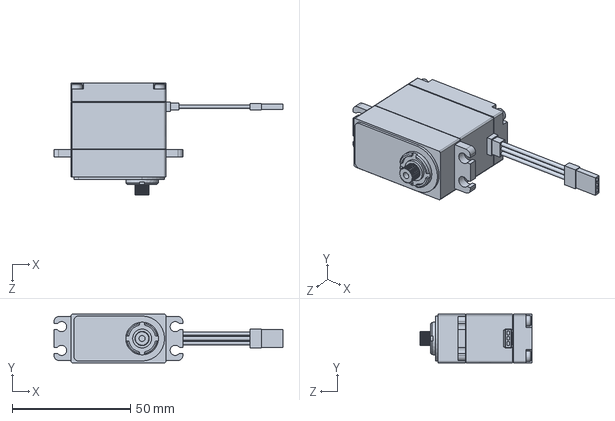
[picture p163: CAD file, 2026-10-14]
cad/No1/3D尺寸图/舵机外形图/40KG铝壳舵机外形图.SLDPRT
96.7 x 20.5 x 47.3 mm
