Lucaszyf/Solar-Enhanced-Biomimetic-UAV/cad/No1/Lucas_3Dfile/尼龙碳纤维打印/蜗杆1×1.STEP

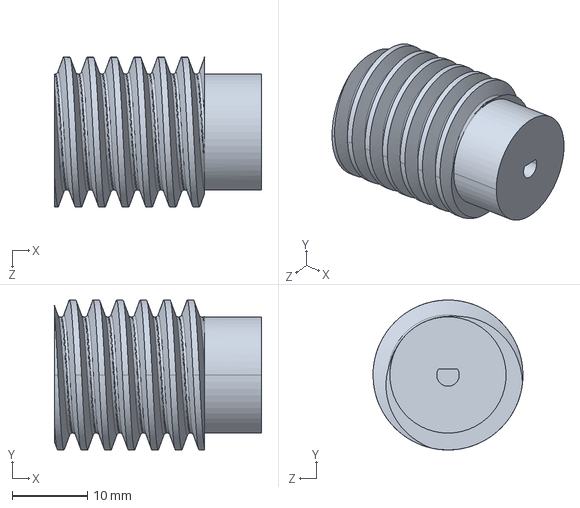
[picture p164: CAD file, 2026-10-14]
cad/No1/Lucas_3Dfile/尼龙碳纤维打印/蜗杆1×1.STEP
27.6 x 20.0 x 20.0 mm
