Lucaszyf/Solar-Enhanced-Biomimetic-UAV/cad/No1/吸盘打印件/lower half.STEP

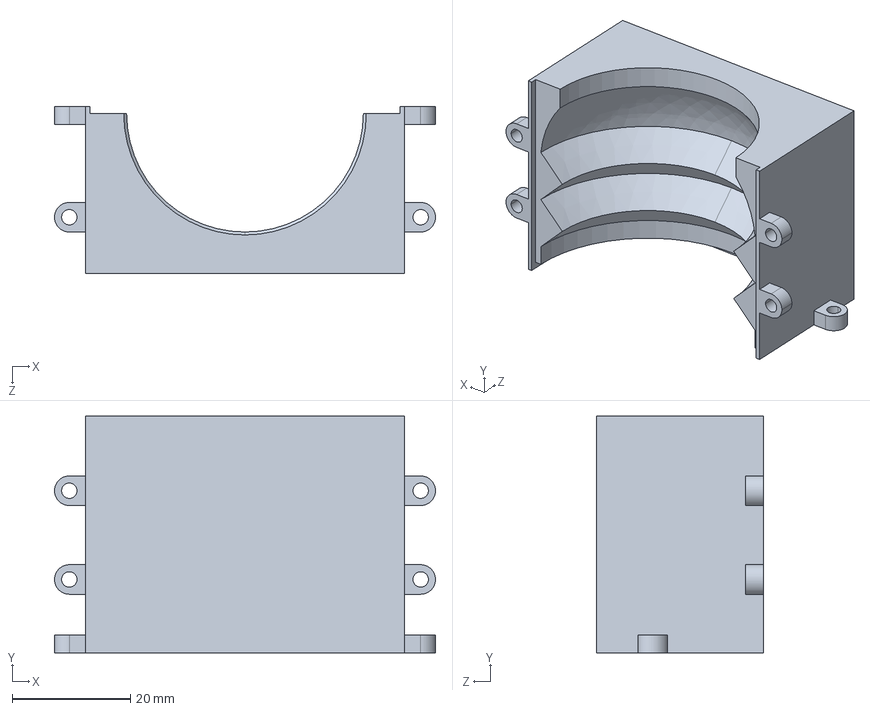
[picture p165: CAD file, 2026-10-14]
cad/No1/吸盘打印件/lower half.STEP
64.4 x 40.0 x 28.2 mm
