Lucaszyf/Solar-Enhanced-Biomimetic-UAV/cad/No2/太阳能折叠总装/齿条固定件.SLDPRT

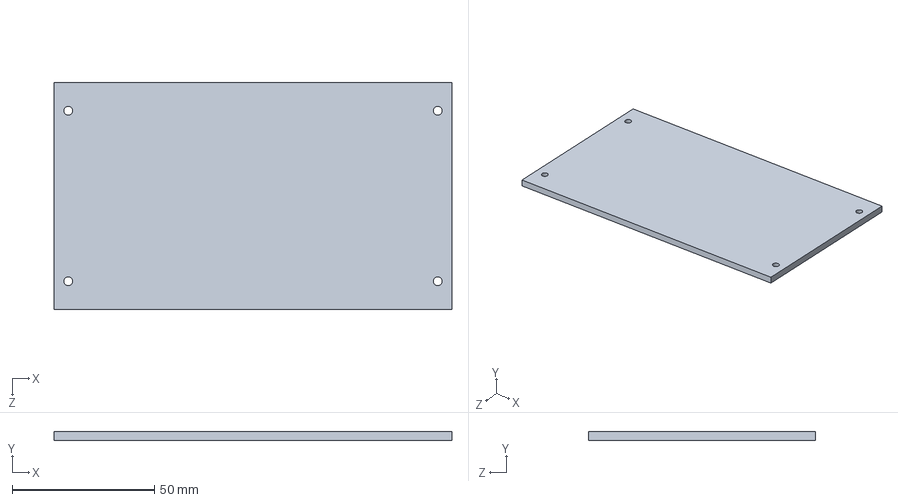
[picture p166: CAD file, 2026-10-14]
cad/No2/太阳能折叠总装/齿条固定件.SLDPRT
140.0 x 3.00 x 80.0 mm
