Lucaszyf/Solar-Enhanced-Biomimetic-UAV/cad/No2/舵机云台/solidworks/right.SLDPRT

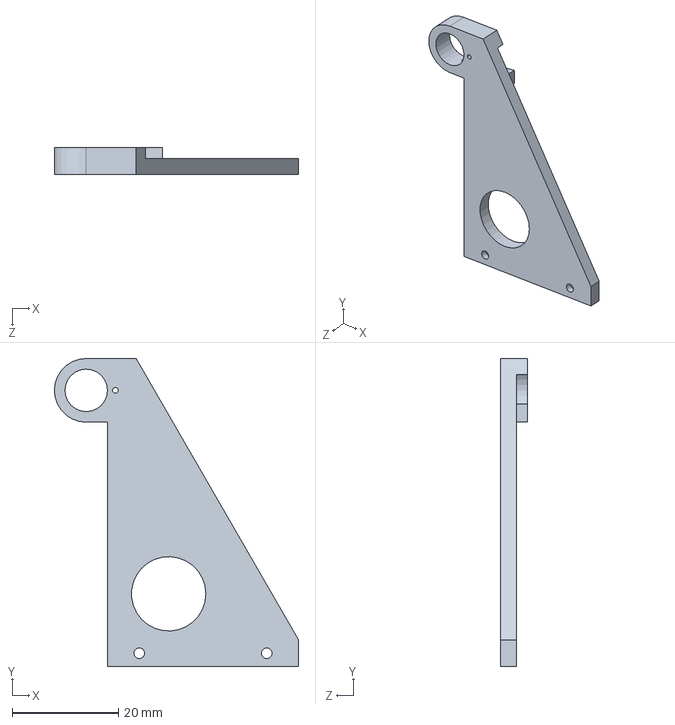
[picture p167: CAD file, 2026-10-14]
cad/No2/舵机云台/solidworks/right.SLDPRT
46.0 x 58.0 x 5.00 mm
