Lucaszyf/Solar-Enhanced-Biomimetic-UAV/cad/No3/三维模型总装配/limit-switch-top-case.SLDPRT

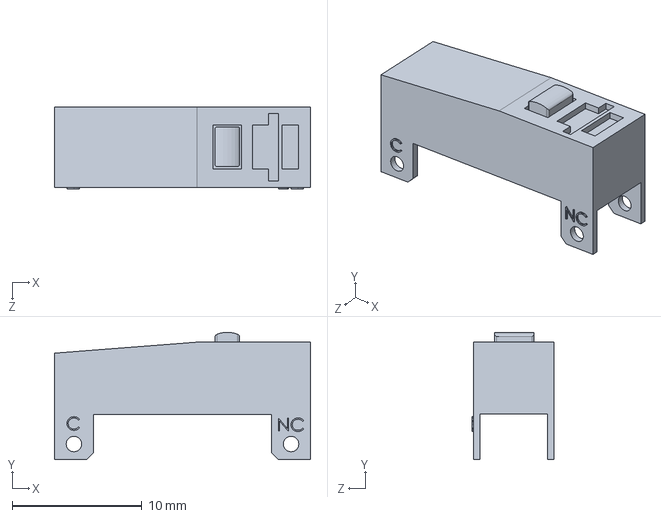
[picture p168: CAD file, 2026-10-14]
cad/No3/三维模型总装配/limit-switch-top-case.SLDPRT
19.8 x 9.81 x 6.30 mm
