Lucaszyf/Solar-Enhanced-Biomimetic-UAV/cad/No3/游泳圈建模/固定座.SLDPRT

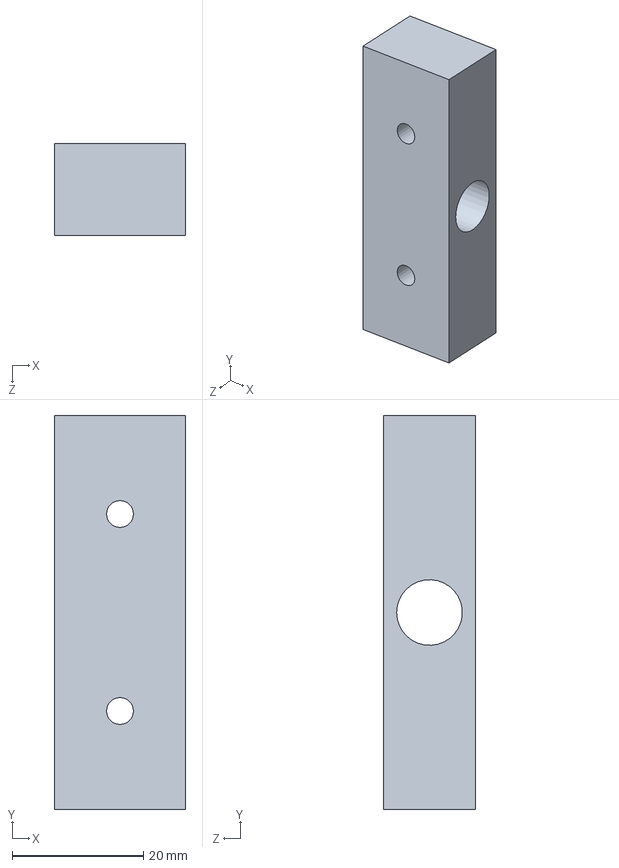
[picture p169: CAD file, 2026-10-14]
cad/No3/游泳圈建模/固定座.SLDPRT
20.0 x 60.0 x 14.0 mm
