Lucaszyf/Solar-Enhanced-Biomimetic-UAV/cad/No1/3D尺寸图/202315抛投器零件PDF档/1.产品组装体.STEP

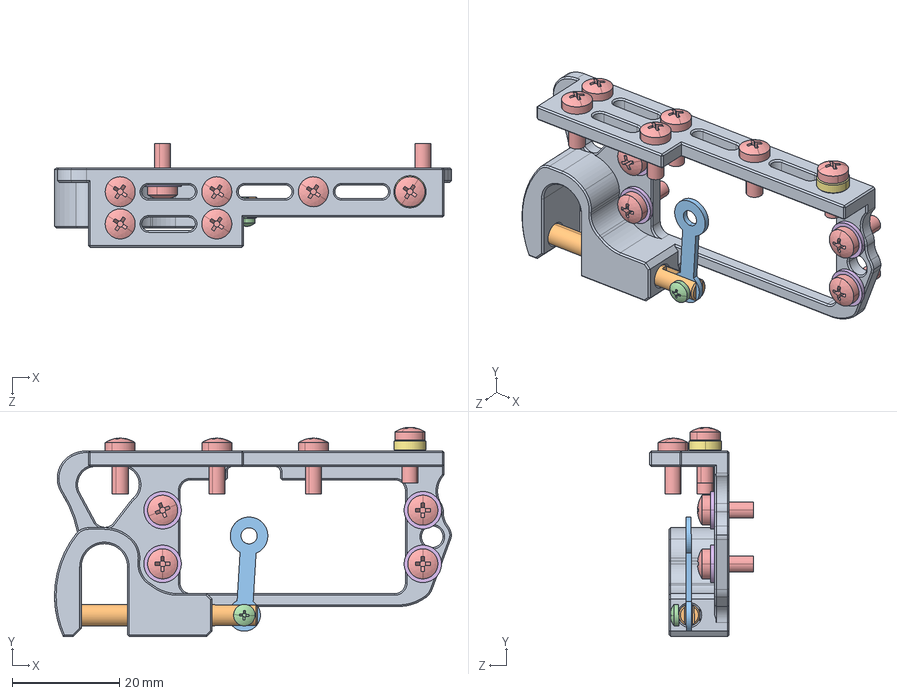
[picture p170: CAD file, 2026-10-14]
cad/No1/3D尺寸图/202315抛投器零件PDF档/1.产品组装体.STEP
74.0 x 39.0 x 19.3 mm
1.抛丸器图纸
2.怀堤粣4
3.蟀裝え
cross recessed pan head screws gb_GB_CROSS_SCREWS_TYPE1 M2X4-4 H type-N
cross recessed pan head screws gb_GB_CROSS_SCREWS_TYPE1 M3X8-8 H type-N x 10
7.菜え4 x 4
8.臏輸菜3.0
