Lucaszyf/Solar-Enhanced-Biomimetic-UAV/cad/No1/3D尺寸图/舵机外形图/12KG舵机全金属外形图.SLDPRT

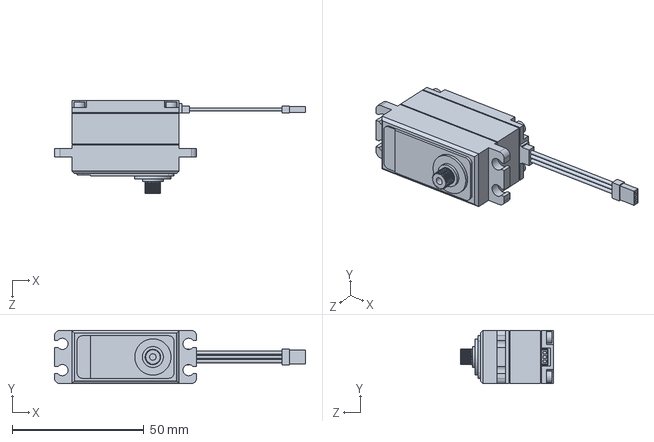
[picture p171: CAD file, 2026-10-14]
cad/No1/3D尺寸图/舵机外形图/12KG舵机全金属外形图.SLDPRT
95.4 x 20.2 x 35.2 mm
