Lucaszyf/Solar-Enhanced-Biomimetic-UAV/cad/No1/3D尺寸图/舵盘25T.STEP

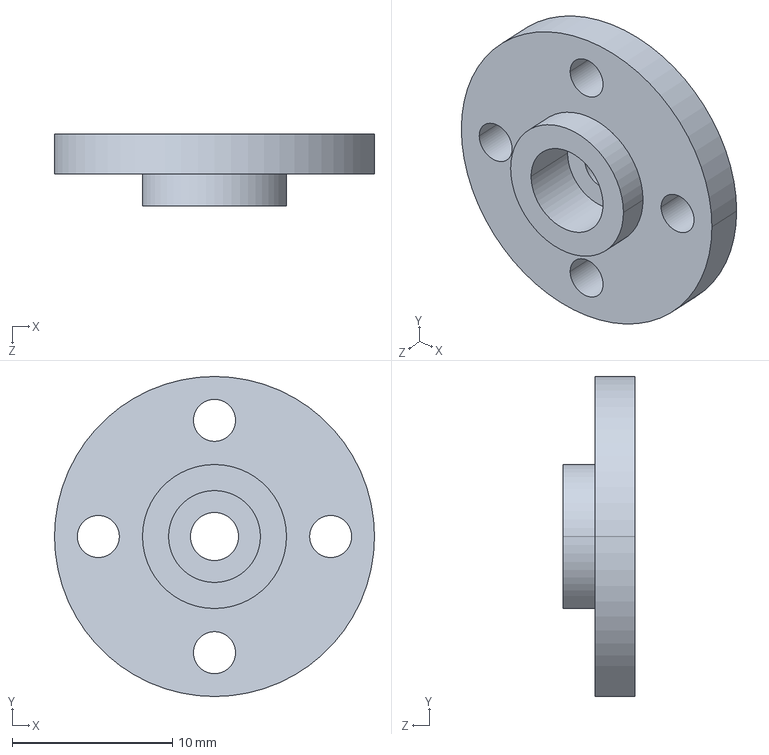
[picture p172: CAD file, 2026-10-14]
cad/No1/3D尺寸图/舵盘25T.STEP
20.0 x 20.0 x 4.53 mm
