Lucaszyf/Solar-Enhanced-Biomimetic-UAV/cad/No1/3D零件图/侧面支架.SLDPRT

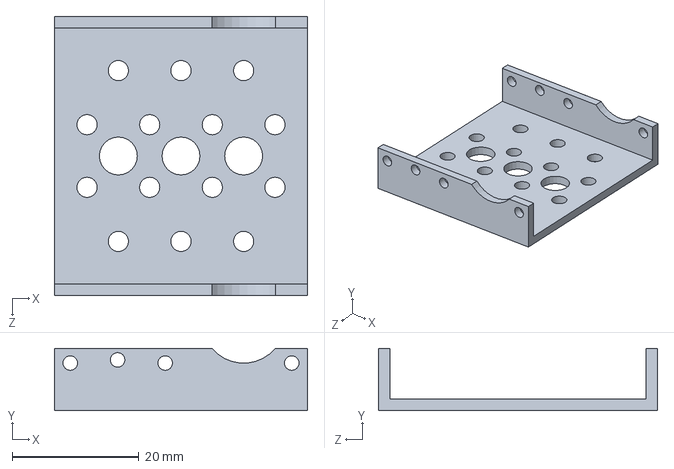
[picture p173: CAD file, 2026-10-14]
cad/No1/3D零件图/侧面支架.SLDPRT
40.0 x 9.80 x 44.1 mm
