Lucaszyf/Solar-Enhanced-Biomimetic-UAV/cad/No1/Lucas_3Dfile/part04.SLDPRT

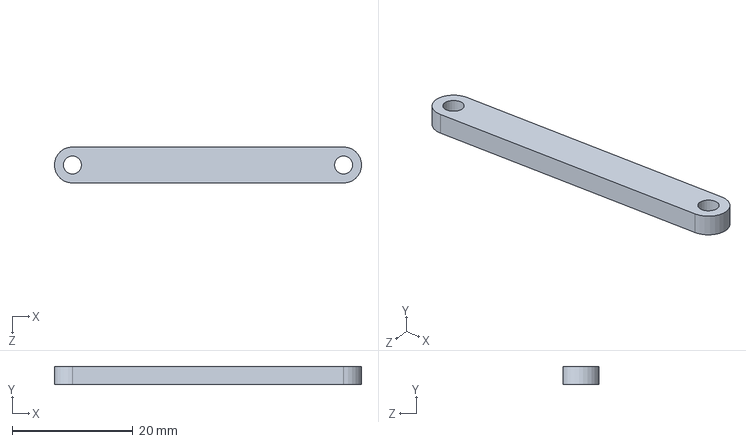
[picture p174: CAD file, 2026-10-14]
cad/No1/Lucas_3Dfile/part04.SLDPRT
51.0 x 3.00 x 6.00 mm
