Lucaszyf/Solar-Enhanced-Biomimetic-UAV/cad/No2/太阳能折叠总装/太阳能板子建模/太阳能板折叠总装.SLDASM

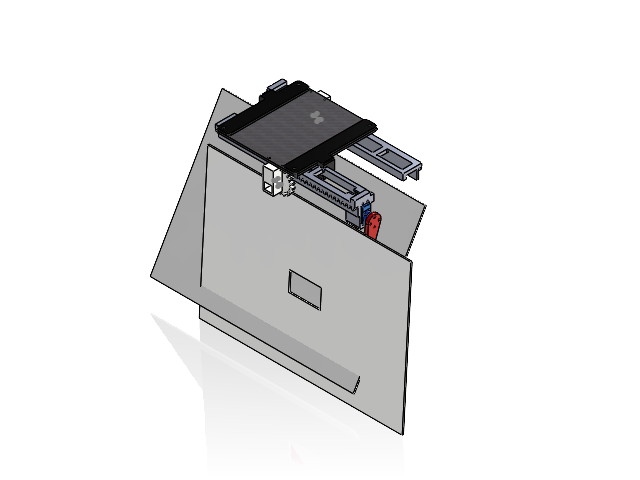
[picture p176: CAD file, 2026-10-14]
cad/No2/太阳能折叠总装/太阳能板子建模/太阳能板折叠总装.SLDASM
3mm
折叠架电机 x 2
圆柱齿轮17×2 x 2
轨道固定2 x 2
支架test1 x 2
太阳能板 x 2
9克 x 2
齿条舵机test3.step x 2
