Lucaszyf/Solar-Enhanced-Biomimetic-UAV/cad/No2/N20微型金属齿轮电机/n20 motor.SLDASM

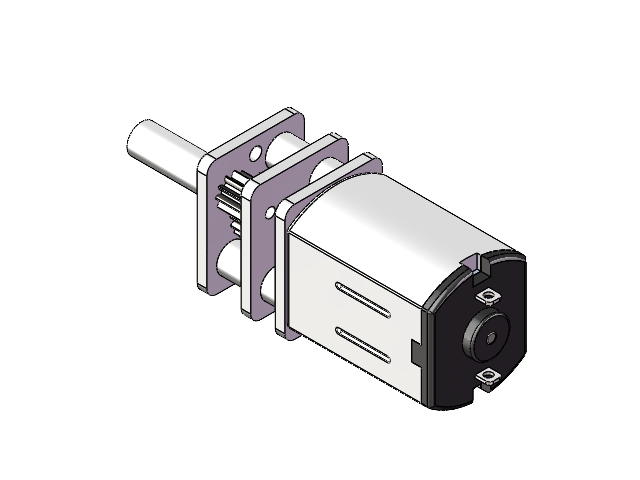
[picture p177: CAD file, 2026-10-14]
cad/No2/N20微型金属齿轮电机/n20 motor.SLDASM
motor
n20_shaft
n20_gearbox
cross recessed countersunk head screws gb1 x 2
spur gear_gb x 6
