Lucaszyf/Solar-Enhanced-Biomimetic-UAV/cad/No1/第二版/UAVASM.SLDASM

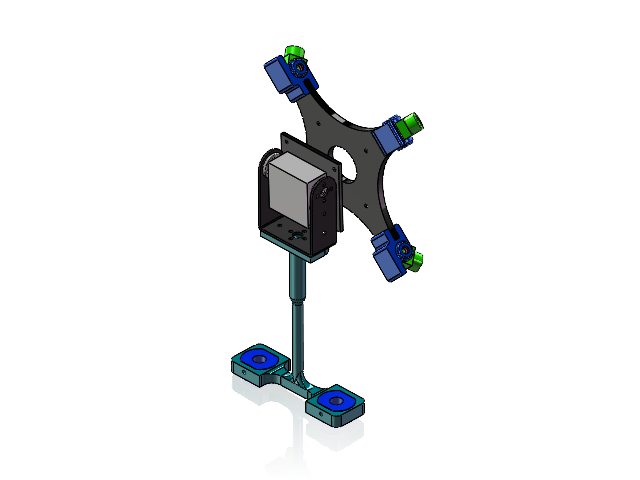
[picture p178: CAD file, 2026-10-14]
cad/No1/第二版/UAVASM.SLDASM
CON01 x 4
bear10x6x3 x 8
CON02 x 4
3115舵机
长U支架
金属主舵盘 x 2
