Lucaszyf/Solar-Enhanced-Biomimetic-UAV/cad/No1/Lucas_3Dfile/机械爪/太阳能折叠总装.SLDASM

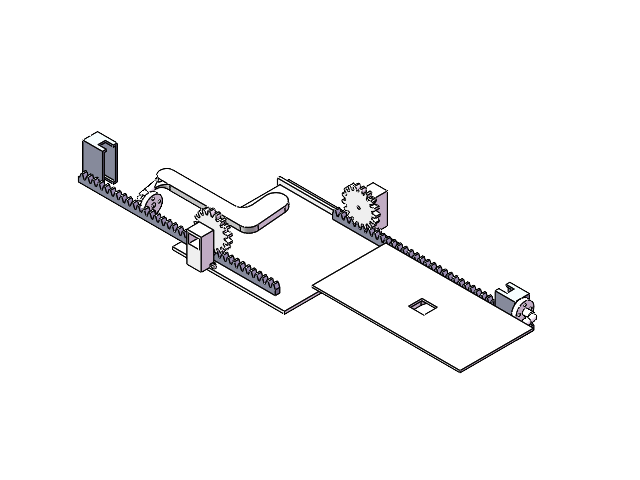
[picture p180: CAD file, 2026-10-14]
cad/No1/Lucas_3Dfile/机械爪/太阳能折叠总装.SLDASM
零件2^太阳能折叠总装
圆柱齿轮17×2 x 2
折叠架电机 x 2
太阳能板夹持件 x 2
齿条舵机 x 2
太阳能齿条固定
太阳能齿条固定2
太阳能板
