Lucaszyf/Solar-Enhanced-Biomimetic-UAV/cad/No2/太阳能折叠总装/太阳能折叠总装.SLDASM

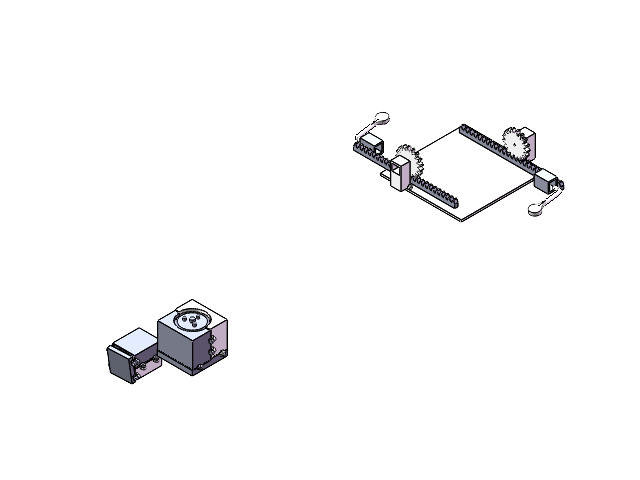
[picture p181: CAD file, 2026-10-14]
cad/No2/太阳能折叠总装/太阳能折叠总装.SLDASM
零件2^太阳能折叠总装
圆柱齿轮17×2 x 2
折叠架电机 x 2
太阳能板夹持件 x 2
齿条0.106814150222053×2 x 2
uphalfmold
upper half
模型内胆
内胆
lower half
lowerhalfmold
