Lucaszyf/Solar-Enhanced-Biomimetic-UAV/cad/No2/太阳能折叠总装/太阳能板折叠总装.SLDASM

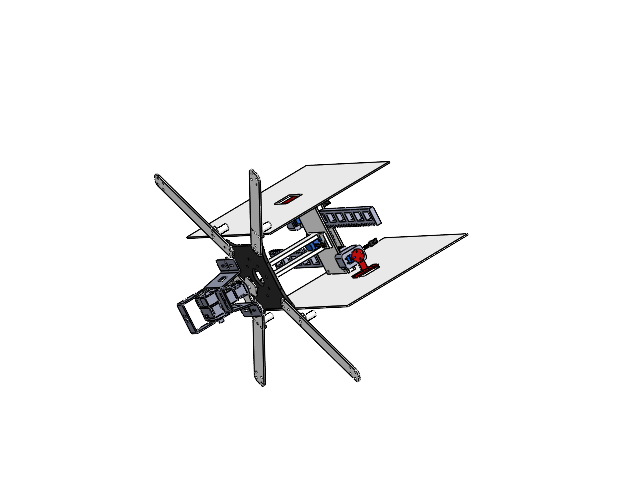
[picture p182: CAD file, 2026-10-14]
cad/No2/太阳能折叠总装/太阳能板折叠总装.SLDASM
太阳能板 x 2
9克 x 3
9g_servo_arm_dual
rotate
齿轮固定板
齿条固定件
太阳能齿条固定件 x 2
bodyv2
爪子和吸盘固定件
____-____.STEP.STEP x 2
____________.STEP.STEP x 2
________.STEP.STEP x 2
____________-0.STEP.STEP x 2
______.step.STEP.STEP x 2
3pin____.step.STEP.STEP x 4
______________,______.STEP
__________.STEP
__________-0.STEP x 2
________________.step.STEP
__U________.STEP
支架test1_v1 x 2
圆柱齿轮20×2
齿条V2 x 2
无人机机臂 x 4
固定件 x 4
