Lucaszyf/Solar-Enhanced-Biomimetic-UAV/cad/No3/三维模型总装配/总装配体.SLDASM

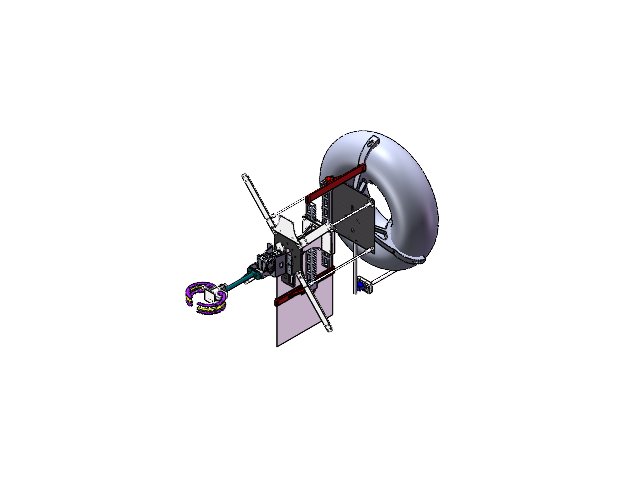
[picture p183: CAD file, 2026-10-14]
cad/No3/三维模型总装配/总装配体.SLDASM
太阳能板
rotate
齿轮固定板
齿条固定件
太阳能齿条固定件 x 2
9克 x 2
bodyv2
爪子和吸盘固定件
____-____.STEP.STEP x 2
____________.STEP.STEP x 2
________.STEP.STEP x 2
____________-0.STEP.STEP x 2
______.step.STEP.STEP x 2
3pin____.step.STEP.STEP x 4
______________,______.STEP
__________.STEP
__________-0.STEP x 2
________________.step.STEP
__U________.STEP
支架test1_v1 x 2
圆柱齿轮20×2
齿条V2 x 2
无人机机臂 x 4
固定件 x 8
DS3218MG MS24 Digital Servo 270
3mm
游泳圈固定件 x 3
游泳圈模型V2
Tower Pro 9g Micro Servo SG90
6mm碳棍
固定座
6mm下部分碳棍
base_head
喷水装置齿轮
喷水装置齿轮配套
齿轮固定
M4-300 x 4
partCon02_V2
motor
尼龙涡轮 x 2
金属蜗杆
爪子伸长件 x 2
n20_gearmotor_mount
M3-12 x 2
M3-9 x 4
M3-6 x 2
N20_A
触碰开关
limit-switch-bottomcase
limit-switch-top-case
pins
switch_lever
PCB板子固定
