Lucaszyf/Solar-Enhanced-Biomimetic-UAV/cad/No3/三维模型总装配/游泳圈装配体.SLDASM

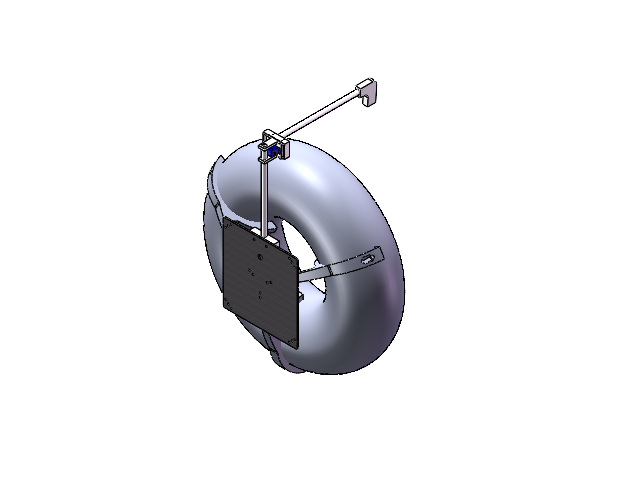
[picture p184: CAD file, 2026-10-14]
cad/No3/三维模型总装配/游泳圈装配体.SLDASM
3mm
游泳圈固定件 x 3
游泳圈模型V2
Tower Pro 9g Micro Servo SG90
6mm碳棍
固定座
6mm下部分碳棍
base_head
rotate-s
喷水装置齿轮
喷水装置齿轮配套
齿轮固定
