Lucaszyf/Solar-Enhanced-Biomimetic-UAV/cad/No3/三维模型总装配/机械爪总装.SLDASM

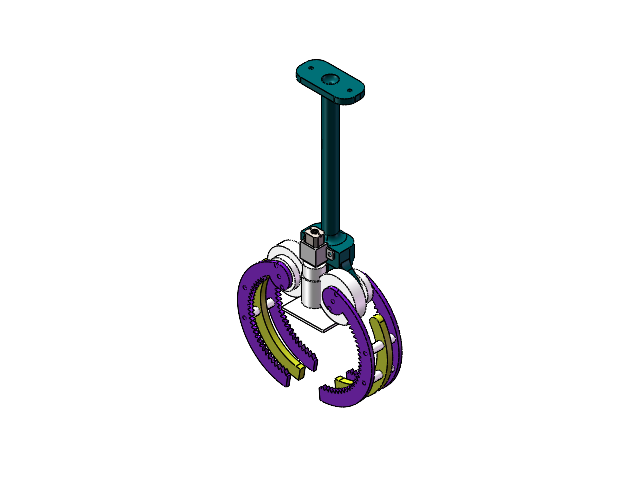
[picture p185: CAD file, 2026-10-14]
cad/No3/三维模型总装配/机械爪总装.SLDASM
partCon02_V2
motor
尼龙涡轮 x 2
金属蜗杆
爪子伸长件 x 2
n20_gearmotor_mount
M3-12 x 2
M3-9 x 4
M3-6 x 2
N20_A
触碰开关
limit-switch-bottomcase
limit-switch-top-case
pins
switch_lever
