Lucaszyf/Solar-Enhanced-Biomimetic-UAV/(list of files, cad)

Other CAD files:
cad/No1/3D零件图/爪子（配合）.SLDASM
cad/No1/3D尺寸图/舵机CAD及PDF档图纸/8.35KG塑胶壳舵机双出轴外形图.DWG
cad/No1/Lucas_3Dfile/3mm碳板切割/3mm厚度切割.DWG
cad/No1/Lucas_3Dfile/5mm碳板切割/5mm厚度切割.DWG
cad/华馨京科技 25-50kg 舵机模型图纸（含配件）/华馨京 25-50kg双轴舵机系列/华馨京 25-50kg双轴舵机外观尺寸图.dwg
cad/华馨京科技 25-50kg 舵机模型图纸（含配件）/华馨京 舵机 D型输出轴系列/华馨京 25-50kg单轴舵机外观尺寸图-D型输出轴/华馨京 25-50kg单轴舵机外观尺寸图（D轴）.dwg
cad/华馨京科技 25-50kg 舵机模型图纸（含配件）/华馨京 舵机 D型输出轴系列/华馨京 单轴舵机 RX8-U29H-M D型输出轴/华馨京 RX8-U29H-M 尺寸图（D型输出轴）.dwg
cad/No1/3D尺寸图/202315抛投器零件PDF档/3.连杆片.DWG
cad/No1/3D尺寸图/舵机CAD及PDF档图纸/1.3.7克微型舵机.DWG
cad/No1/3D尺寸图/舵机外形图/15,20KG全金属舵机外形图.SLDPRT
cad/No1/Lucas_3Dfile/尼龙碳纤维打印/inner suction cup connector.STEP
cad/华馨京科技 25-50kg 舵机模型图纸（含配件）/华馨京 25-50kg单轴舵机系列/华馨京 25-50kg单轴舵机外观尺寸图.dwg
cad/华馨京科技 25-50kg 舵机模型图纸（含配件）/华馨京 舵机 D型输出轴系列/华馨京 25-50kg双轴舵机外观尺寸图-D型输出轴/华馨京 25-50kg双轴舵机外观尺寸图（D轴）.dwg
cad/华馨京科技 OpenMV舵机云台图纸/华馨京 OpenMV舵机云台外观尺寸图.dwg
cad/No1/3D尺寸图/202315抛投器零件PDF档/2.输出轴4.DWG
cad/No1/3D尺寸图/25KG铝中壳舵机外形图.SLDPRT
cad/No1/3D尺寸图/舵机CAD及PDF档图纸/5,20KG全金属舵机外形图.DWG
cad/No2/9gServo舵机/servo.SLDPRT
cad/No1/3D尺寸图/202315抛投器零件PDF档/7.垫片4.DWG
cad/No1/3D尺寸图/舵机臂.DWG
cad/No1/Lucas_3Dfile/尼龙碳纤维打印/太阳能板夹持件.STEP
cad/No1/3D尺寸图/202315抛投器零件PDF档/9.M3螺丝.DWG
cad/No1/3D尺寸图/舵机CAD及PDF档图纸/12.40KG铝壳舵机外形图.DWG
cad/No1/3D尺寸图/舵机外形图/35KG塑胶壳舵机双出轴外形图.SLDPRT
cad/No2/太阳能折叠总装/圆柱齿轮17×2.SLDPRT
cad/No2/太阳能折叠总装/太阳能板子建模/折叠架电机.SLDPRT
cad/华馨京科技 25-50kg 舵机模型图纸（含配件）/华馨京 25-50kg舵机系列配件/华馨京 25-50kg舵机系列U型舵盘支架（50.7mm）支架尺寸图.dwg
cad/No1/3D尺寸图/202315抛投器零件PDF档/1.M2螺丝.DWG
cad/No1/3D尺寸图/舵机CAD及PDF档图纸/6.25KG铝中壳舵机外形图.DWG
cad/No1/Lucas_3Dfile/太阳能板夹持件新.STL
cad/华馨京科技 25-50kg 舵机模型图纸（含配件）/华馨京 25-50kg舵机系列配件/华馨京 25-50kg舵机系列U型机身支架（标准）尺寸图.dwg
cad/No1/3D尺寸图/舵机CAD及PDF档图纸/13.20G舵机外形图.dwg
cad/No1/2D/圆柱齿轮17×1.25从动.DWG
cad/No1/3D尺寸图/15,20KG全金属舵机外形图.SLDPRT
cad/No1/3D尺寸图/15.9217G舵机外形图(1).DWG
cad/No1/3D尺寸图/202315抛投器零件PDF档/1.抛丸器图纸.DWG
cad/No1/3D尺寸图/202315抛投器零件PDF档/8.铝块垫3.0.DWG
cad/No1/3D尺寸图/25KG铝中壳舵机外形图（2）.SLDPRT
cad/No1/3D尺寸图/25KG铝中壳舵机外形图（2）.STEP
cad/No1/3D尺寸图/45KG铝壳舵机外形图.SLDPRT
cad/No1/3D尺寸图/55KG全金属舵机外形图.SLDPRT
cad/No1/3D尺寸图/60KG全金属舵机外形图.SLDPRT
cad/No1/3D尺寸图/9217G舵机外形图.SLDPRT
cad/No1/3D尺寸图/TK-320MG.SLDPRT
cad/No1/3D尺寸图/TK-320MG.STEP
cad/No1/3D尺寸图/TS90M.STEP
cad/No1/3D尺寸图/舵机CAD及PDF档图纸/10.60KG全金属舵机外形图.DWG
cad/No1/3D尺寸图/舵机CAD及PDF档图纸/11.45KG铝壳舵机外形图.DWG
cad/No1/3D尺寸图/舵机CAD及PDF档图纸/14.25G舵机外形图.dwg
cad/No1/3D尺寸图/舵机CAD及PDF档图纸/3.12KG舵机半金属外形图.DWG
cad/No1/3D尺寸图/舵机CAD及PDF档图纸/4.12KG舵机全金属外形图.DWG
cad/No1/3D尺寸图/舵机CAD及PDF档图纸/7.35KG铝壳舵机双出轴外形图.DWG
cad/No1/3D尺寸图/舵机CAD及PDF档图纸/9.55KG全金属舵机外形图.DWG
cad/No1/3D零件图/大U梁.SLDPRT
cad/No1/3D零件图/短U支架.SLDPRT
cad/No1/3D零件图/金属主舵盘.SLDPRT
cad/No1/3D零件图/长U支架.SLDPRT
cad/No1/Lucas_3Dfile/8mm碳管.SLDPRT
cad/No1/Lucas_3Dfile/8x6碳管.SLDPRT
cad/No1/Lucas_3Dfile/8x6碳管02.SLDPRT
cad/No1/Lucas_3Dfile/CON_1.SLDPRT
cad/No1/Lucas_3Dfile/CON_2.SLDPRT
cad/No1/Lucas_3Dfile/CON_3.SLDPRT
cad/No1/Lucas_3Dfile/CON_4.SLDPRT
cad/No1/Lucas_3Dfile/CON_5.SLDPRT
cad/No1/Lucas_3Dfile/CUP_HOL.SLDPRT
cad/No1/Lucas_3Dfile/EXT_TUBE.SLDPRT
cad/No1/Lucas_3Dfile/INT_TUBE.SLDPRT
cad/No1/Lucas_3Dfile/Lucas/inner suction cup connector.SLDPRT
cad/No1/Lucas_3Dfile/Lucas/outer suction cup.SLDPRT
cad/No1/Lucas_3Dfile/Lucas/outerconnectorv2.SLDPRT
cad/No1/Lucas_3Dfile/UAV_FRAME01.SLDPRT
cad/No1/Lucas_3Dfile/board01.SLDPRT
cad/No1/Lucas_3Dfile/iconCon.SLDPRT
cad/No1/Lucas_3Dfile/part01.SLDPRT
cad/No1/Lucas_3Dfile/part02.SLDPRT
cad/No1/Lucas_3Dfile/partCon01.SLDPRT
cad/No1/Lucas_3Dfile/partCon02 .SLDPRT
cad/No1/Lucas_3Dfile/servodeck.STEP
cad/No1/Lucas_3Dfile/上下模半成品.SLDPRT
cad/No1/Lucas_3Dfile/上下模半成品02.SLDPRT
cad/No1/Lucas_3Dfile/下模具.SLDPRT
cad/No1/Lucas_3Dfile/下模具02.SLDPRT
cad/No1/Lucas_3Dfile/圆柱齿轮17×1.25从动.SLDPRT
cad/No1/Lucas_3Dfile/圆柱齿轮17×2.SLDPRT
cad/No1/Lucas_3Dfile/太阳能板.SLDPRT
cad/No1/Lucas_3Dfile/太阳能板夹持件.STL
cad/No1/Lucas_3Dfile/太阳能板夹持件v2.STL
cad/No1/Lucas_3Dfile/太阳能板夹持件舵机版.STL
cad/No1/Lucas_3Dfile/太阳能齿条固定.DXF
cad/No1/Lucas_3Dfile/太阳能齿条固定.SLDPRT
cad/No1/Lucas_3Dfile/太阳能齿条固定2.DXF
cad/No1/Lucas_3Dfile/太阳能齿条固定2.SLDPRT
cad/No1/Lucas_3Dfile/封闭盖子.SLDPRT
cad/No1/Lucas_3Dfile/封闭盖子02.SLDPRT
cad/No1/Lucas_3Dfile/尼龙碳纤维打印/outerconnectorv2.STEP
cad/No1/Lucas_3Dfile/尼龙碳纤维打印/partCon01.STEP
cad/No1/Lucas_3Dfile/尼龙碳纤维打印/partCon02 .STEP
cad/No1/Lucas_3Dfile/尼龙碳纤维打印/蜗杆1×1X104.STEP
cad/No1/Lucas_3Dfile/折叠架电机.SLDPRT
cad/No1/Lucas_3Dfile/折叠架电机.STL
cad/No1/Lucas_3Dfile/无人机机臂.SLDPRT
cad/No1/Lucas_3Dfile/机械爪/2D/part04.DWG
cad/No1/Lucas_3Dfile/机械爪/57545K659_303 Stainless Steel Worm.SLDPRT
cad/No1/Lucas_3Dfile/机械爪/57545K765_Metal Worm Gear.SLDPRT
cad/No1/Lucas_3Dfile/机械爪/part01.SLDPRT
cad/No1/Lucas_3Dfile/机械爪/part03.SLDPRT
cad/No1/Lucas_3Dfile/机械爪/吸盘总装.SLDASM
cad/No1/Lucas_3Dfile/机械爪/吸盘总装.STEP
cad/No1/Lucas_3Dfile/机械爪/圆柱齿轮17×1.2502.SLDPRT
cad/No1/Lucas_3Dfile/机械爪/机械爪总装.SLDASM
cad/No1/Lucas_3Dfile/机械爪/机械爪总装.STEP
cad/No1/Lucas_3Dfile/机械爪C01.SLDPRT
cad/No1/Lucas_3Dfile/桨叶范围.SLDPRT
cad/No1/Lucas_3Dfile/模型内胆.SLDPRT
cad/No1/Lucas_3Dfile/模型内胆02.SLDPRT
cad/No1/Lucas_3Dfile/法兰盘01.SLDPRT
cad/No1/Lucas_3Dfile/蜗杆1×1.SLDPRT
cad/No1/Lucas_3Dfile/蜗杆1×1_106.SLDPRT
cad/No1/Lucas_3Dfile/蜗杆1×1_106.STL
cad/No1/Lucas_3Dfile/蜗轮27×1.SLDPRT
cad/No1/Lucas_3Dfile/蜗轮27×1.STL
cad/No1/Lucas_3Dfile/遥控器支架.SLDPRT
cad/No1/Lucas_3Dfile/遥控器支架v1.SLDPRT
cad/No1/Lucas_3Dfile/遥控器支架v3.STL
cad/No1/Lucas_3Dfile/齿条0.106814150222053×2.SLDPRT
cad/No1/Lucas_3Dfile/齿条舵机.SLDPRT
cad/No1/Lucas_3Dfile/齿条舵机.STL
cad/No1/吸盘打印件/lower half.SLDPRT
cad/No1/吸盘打印件/lower half.STL
cad/No1/吸盘打印件/lowerhalfmold.SLDPRT
cad/No1/吸盘打印件/lowerhalfmold.STL
cad/No1/吸盘打印件/uphalfmold.STL
cad/No1/吸盘打印件/upper half.SLDPRT
cad/No1/吸盘打印件/upper half.STEP
cad/No1/吸盘打印件/upper half.STL
cad/No1/吸盘打印件/内胆.SLDPRT
cad/No1/吸盘打印件/内胆.STL
cad/No1/吸盘打印件/吸盘支撑.STL
cad/No1/吸盘打印件/模型内胆.STL
cad/No2/太阳能折叠总装/3mm.SLDPRT
cad/No2/太阳能折叠总装/3mm_v1.SLDPRT
cad/No2/太阳能折叠总装/9克.SLDPRT
cad/No2/太阳能折叠总装/M4-300.SLDPRT
cad/No2/太阳能折叠总装/arm.SLDPRT
cad/No2/太阳能折叠总装/body.SLDPRT
cad/No2/太阳能折叠总装/rotate.SLDPRT
cad/No2/太阳能折叠总装/rotate_v1.SLDPRT
cad/No2/太阳能折叠总装/圆柱齿轮10×2.SLDPRT
cad/No2/太阳能折叠总装/圆柱齿轮15×2.SLDPRT
cad/No2/太阳能折叠总装/圆柱齿轮17×22.SLDPRT
cad/No2/太阳能折叠总装/圆柱齿轮17×4.SLDPRT
cad/No2/太阳能折叠总装/圆柱齿轮20×2.SLDPRT
cad/No2/太阳能折叠总装/太阳能齿条固定件.SLDPRT
cad/No2/太阳能折叠总装/支架test1.SLDPRT
cad/No2/太阳能折叠总装/支架test1.STEP
cad/No2/太阳能折叠总装/轨道固定2.SLDPRT
cad/No2/太阳能折叠总装/轨道固定2.STEP
cad/No2/太阳能折叠总装/齿条0.106814150222053×2.SLDPRT
cad/No2/太阳能折叠总装/齿条0.213628300444106×4.SLDPRT
cad/No2/太阳能折叠总装/齿条V2.SLDPRT
cad/No2/太阳能折叠总装/齿条舵机test3.STEP
cad/No2/太阳能折叠总装/齿轮固定.SLDPRT
cad/No2/太阳能折叠总装/齿轮固定板.SLDPRT
cad/No3/三维模型总装配/3mm.SLDPRT
cad/No3/三维模型总装配/9g_servo_arm_dual.SLDPRT
cad/No3/三维模型总装配/DS3218MG MS24 Digital Servo 270.SLDPRT
cad/No3/三维模型总装配/M3-12.SLDPRT
cad/No3/三维模型总装配/M3-6.SLDPRT
cad/No3/三维模型总装配/M3-9.SLDPRT
cad/No3/三维模型总装配/M4-300.SLDPRT
cad/No3/三维模型总装配/PCB板子固定.SLDPRT
cad/No3/三维模型总装配/Screw-01 for DS3218MG.SLDPRT
cad/No3/三维模型总装配/Screw-02 for DS3218MG.SLDPRT
cad/No3/三维模型总装配/Servo Arm for DS3218MG.SLDPRT
cad/No3/三维模型总装配/Tower Pro 9g Micro Servo SG90.SLDPRT
cad/No3/三维模型总装配/bodyv2.SLDPRT
cad/No3/三维模型总装配/limit-switch-bottomcase.SLDPRT
cad/No3/三维模型总装配/n20_gearmotor_mount.SLDPRT
cad/No3/三维模型总装配/part04.SLDPRT
cad/No3/三维模型总装配/partCon02_V2.SLDPRT
cad/No3/三维模型总装配/pins.SLDPRT
cad/No3/三维模型总装配/rotate.SLDPRT
cad/No3/三维模型总装配/switch_lever.SLDPRT
cad/No3/三维模型总装配/固定件.SLDPRT
cad/No3/三维模型总装配/圆柱齿轮20×2.SLDPRT
cad/No3/三维模型总装配/太阳能齿条固定件.SLDPRT
cad/No3/三维模型总装配/尼龙涡轮.SLDPRT
cad/No3/三维模型总装配/支架test1_v1.SLDPRT
cad/No3/三维模型总装配/游泳圈固定件.SLDPRT
cad/No3/三维模型总装配/游泳圈模型V2.SLDPRT
cad/No3/三维模型总装配/爪子伸长件.SLDPRT
cad/No3/三维模型总装配/爪子和吸盘固定件.SLDPRT
cad/No3/三维模型总装配/触碰开关.SLDPRT
cad/No3/三维模型总装配/金属蜗杆.SLDPRT
cad/No3/三维模型总装配/齿条V2.SLDPRT
cad/No3/三维模型总装配/齿条固定件.SLDPRT
cad/No3/三维模型总装配/齿轮固定.SLDPRT
cad/No3/三维模型总装配/齿轮固定板.SLDPRT
cad/No3/游泳圈建模/6mm碳棍.SLDPRT
cad/No3/游泳圈建模/base.SLDPRT
cad/No3/游泳圈建模/base_head.SLDPRT
cad/No3/游泳圈建模/切割.DXF
cad/No3/游泳圈建模/切割.SLDPRT
cad/No3/游泳圈建模/游泳圈.SLDPRT
cad/No3/游泳圈建模/游泳圈固定件.3mf
cad/No3/游泳圈建模/游泳圈固定件.SLDPRT
cad/No3/游泳圈建模/游泳圈固定件.STEP
cad/华馨京科技 25-50kg 舵机模型图纸（含配件）/华馨京 25-50kg舵机系列配件/华馨京 25-50kg单轴舵机垫块尺寸图.dwg
cad/华馨京科技 25-50kg 舵机模型图纸（含配件）/华馨京 25-50kg舵机系列配件/华馨京 25-50kg舵机系列U型舵盘支架（37mm）-3D.STEP
cad/华馨京科技 25-50kg 舵机模型图纸（含配件）/华馨京 25-50kg舵机系列配件/华馨京 25-50kg舵机系列U型舵盘支架（37mm）尺寸图.dwg
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
