Lucaszyf/Solar-Enhanced-Biomimetic-UAV/cad/No3/游泳圈建模/PerformanceLog.txt

Number of Contacts: 1
Number of contact data: 18
