Lucaszyf/Solar-Enhanced-Biomimetic-UAV/cad/华馨京科技 OpenMV舵机云台图纸/华馨京 OpenMV舵机云台外观尺寸图-PDF.pdf

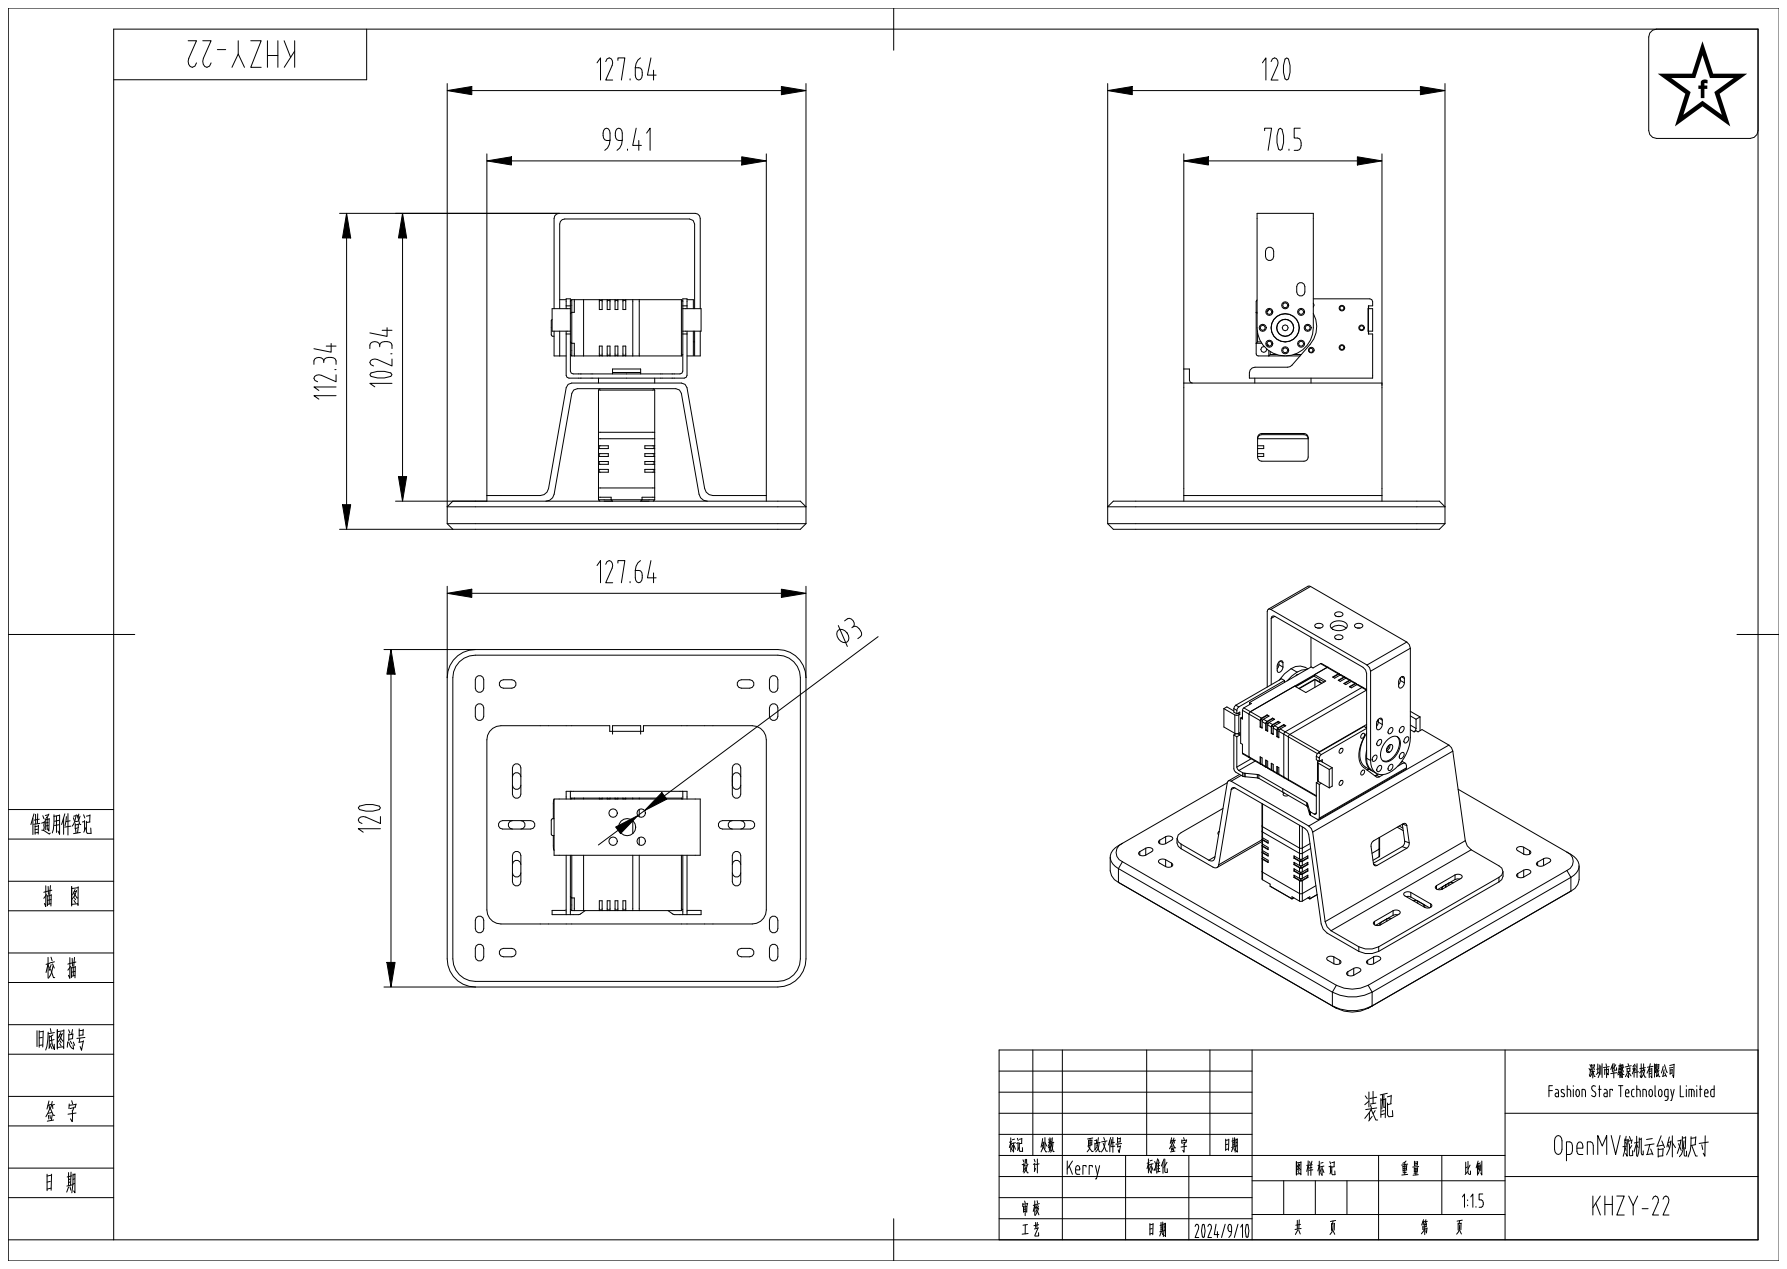
[picture p187: page 1]
