Lucaszyf/Solar-Enhanced-Biomimetic-UAV/cad/No1/3D尺寸图/15.9217G舵机外形图-Model.pdf

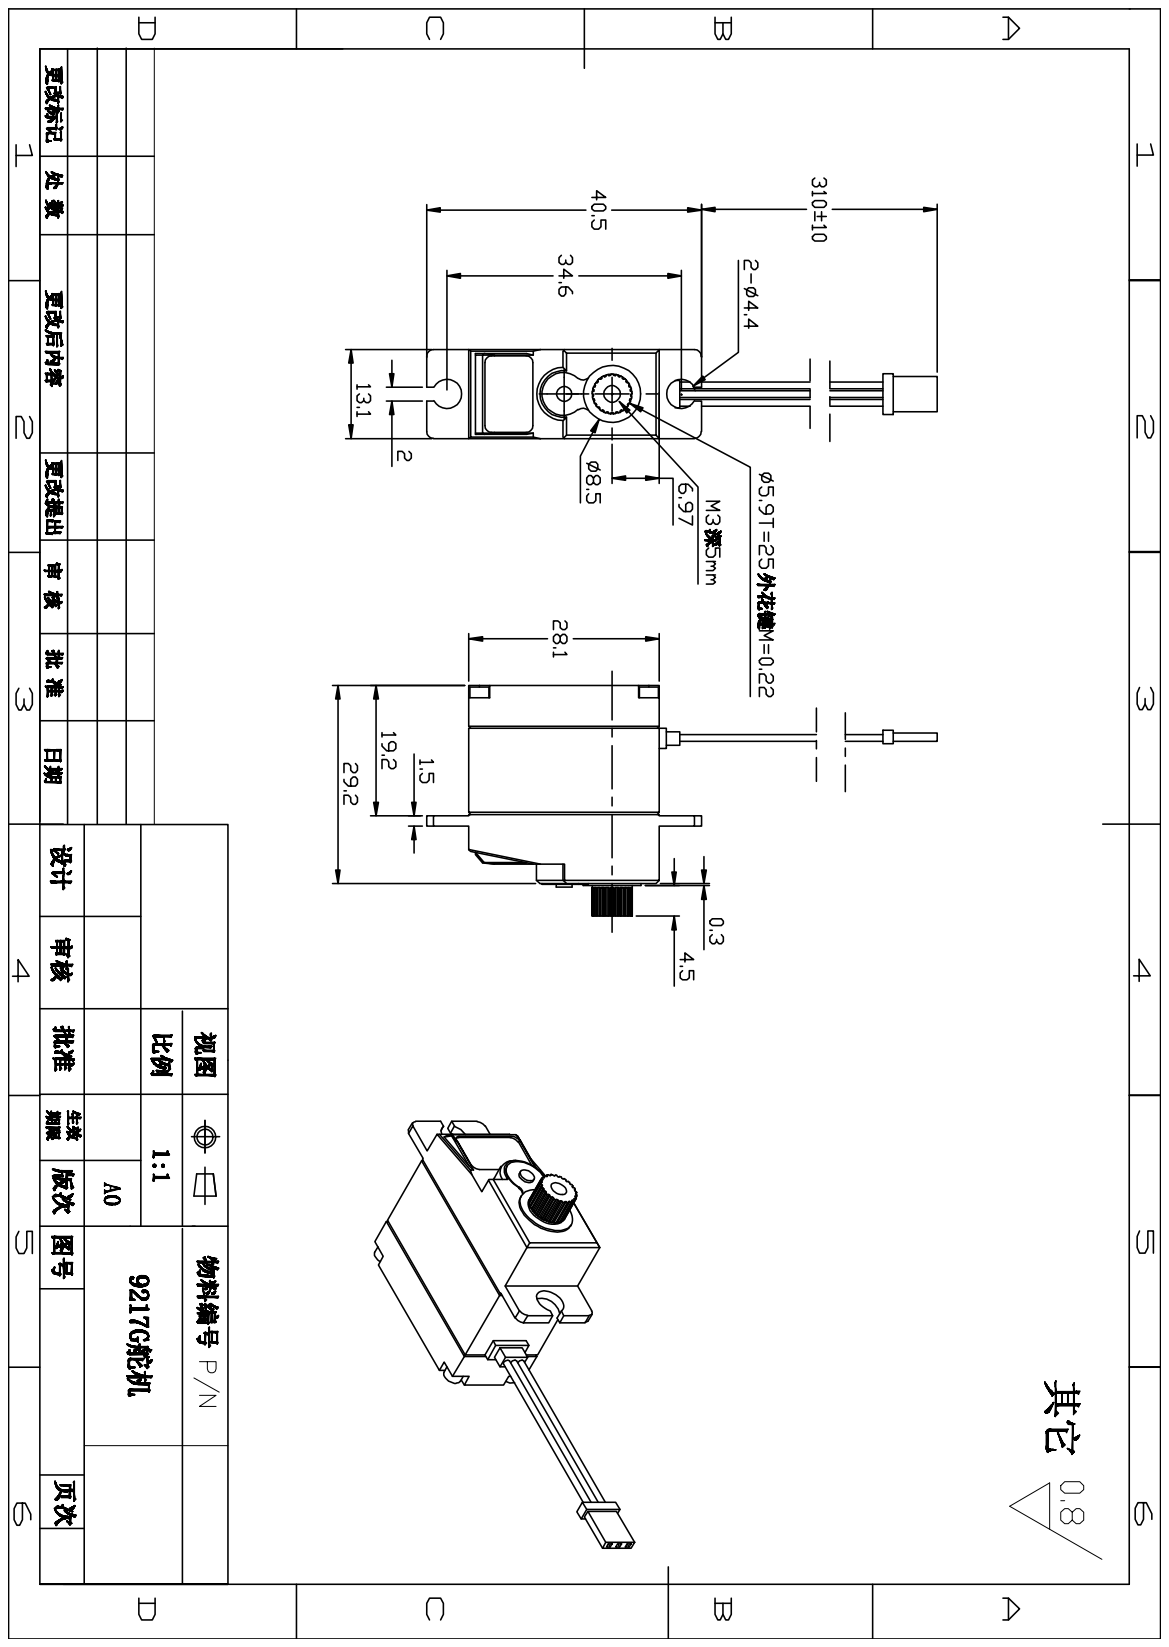
[picture p188: page 1]
