Lucaszyf/Solar-Enhanced-Biomimetic-UAV/cad/华馨京科技 25-50kg 舵机模型图纸（含配件）/华馨京 25-50kg双轴舵机系列/华馨京 25-50kg双轴舵机外观尺寸图-PDF.pdf

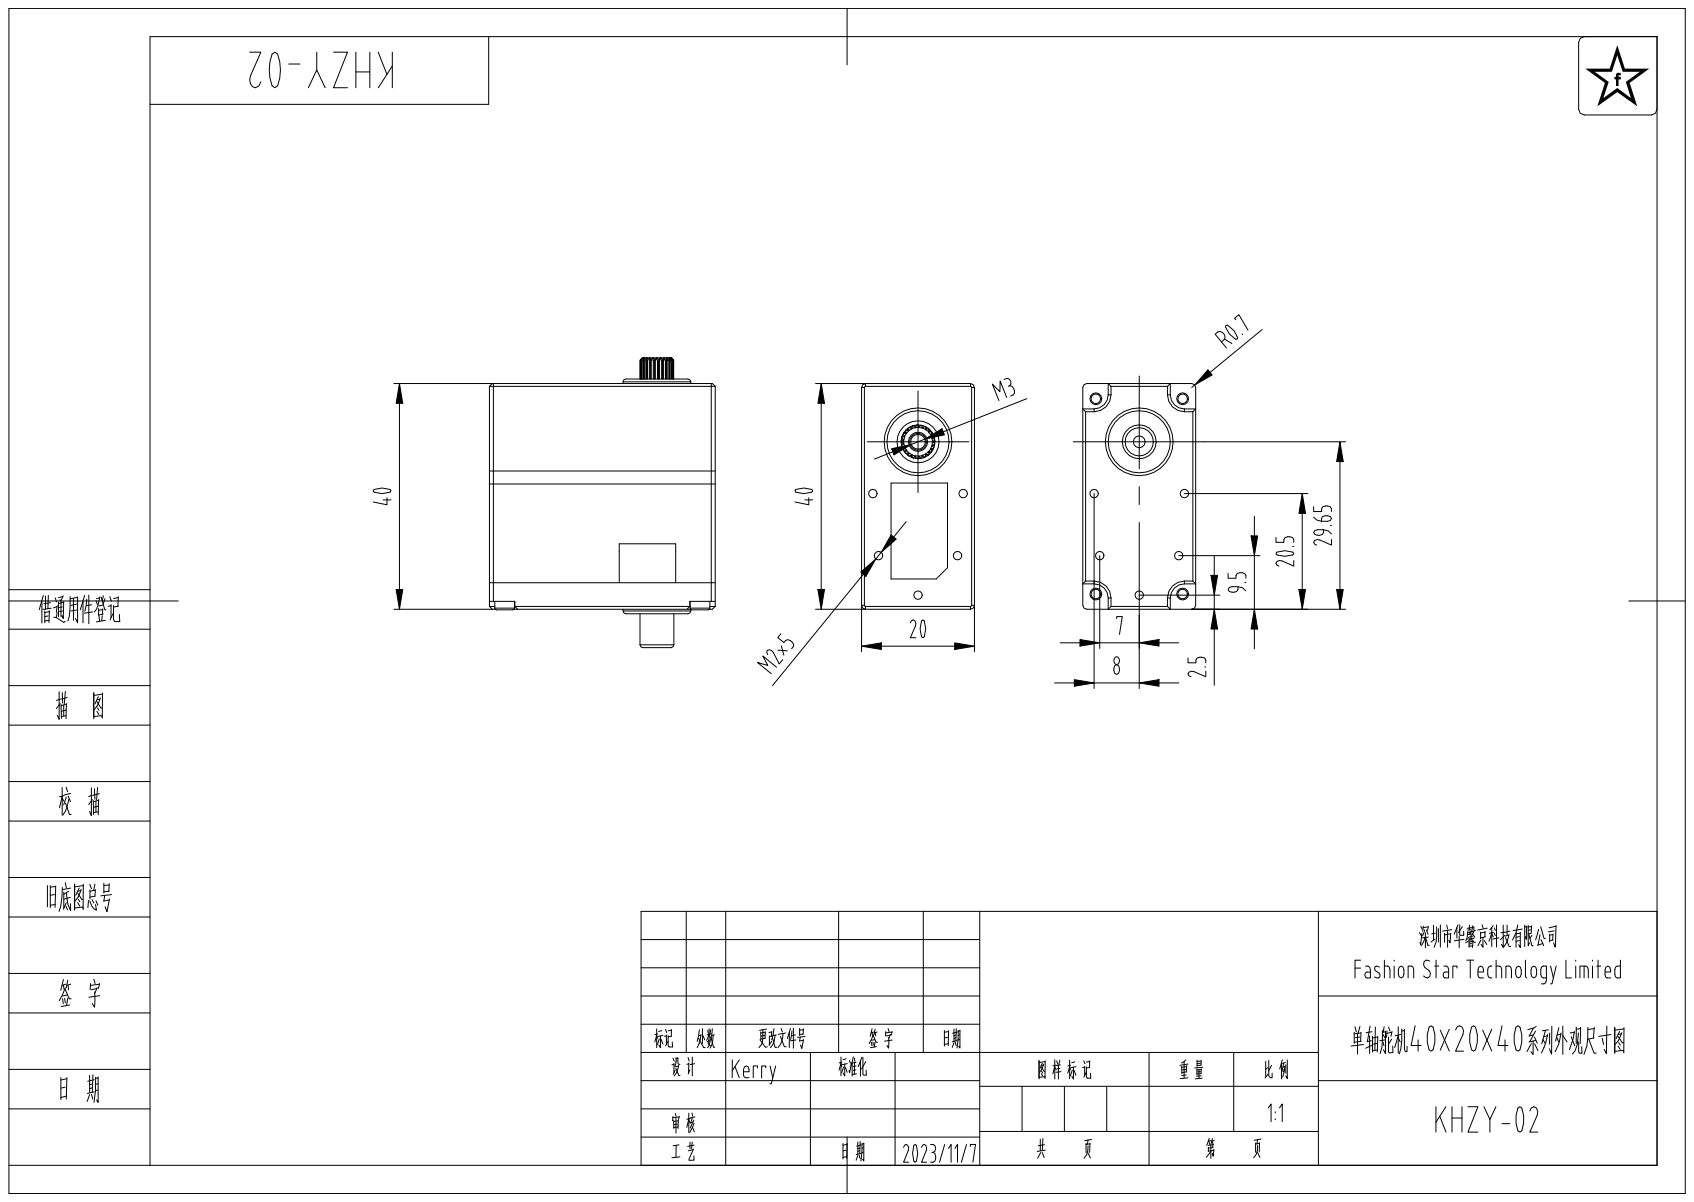
[picture p190: page 1]
