Lucaszyf/Solar-Enhanced-Biomimetic-UAV/cad/华馨京科技 25-50kg 舵机模型图纸（含配件）/华馨京 25-50kg舵机系列配件/华馨京 25-50kg单轴舵机垫块尺寸图-PDF.pdf

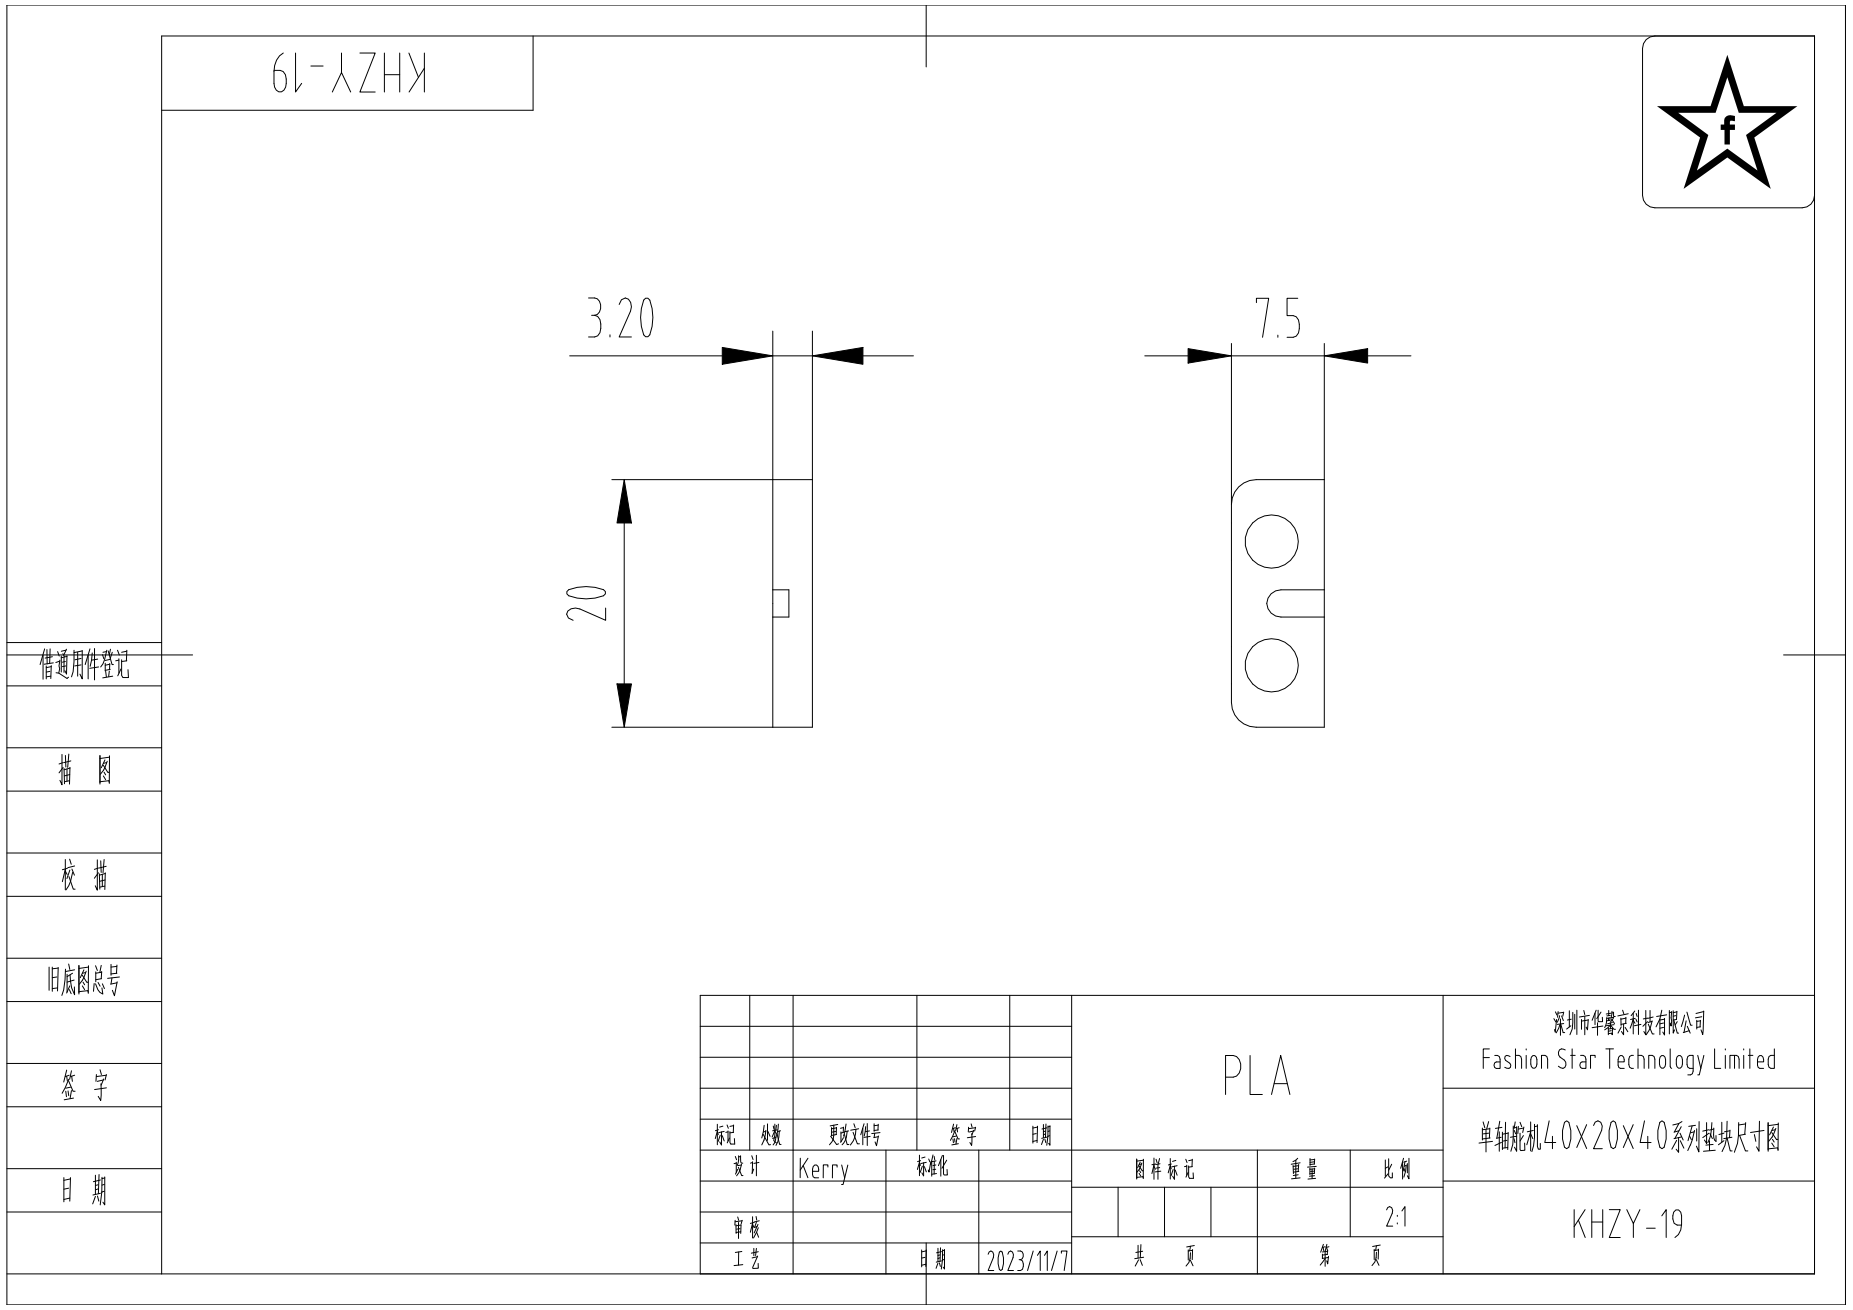
[picture p191: page 1]
