Lucaszyf/Solar-Enhanced-Biomimetic-UAV/cad/华馨京科技 25-50kg 舵机模型图纸（含配件）/华馨京 25-50kg舵机系列配件/华馨京 25-50kg舵机系列U型机身支架（标准）支架尺寸图-PDF.pdf

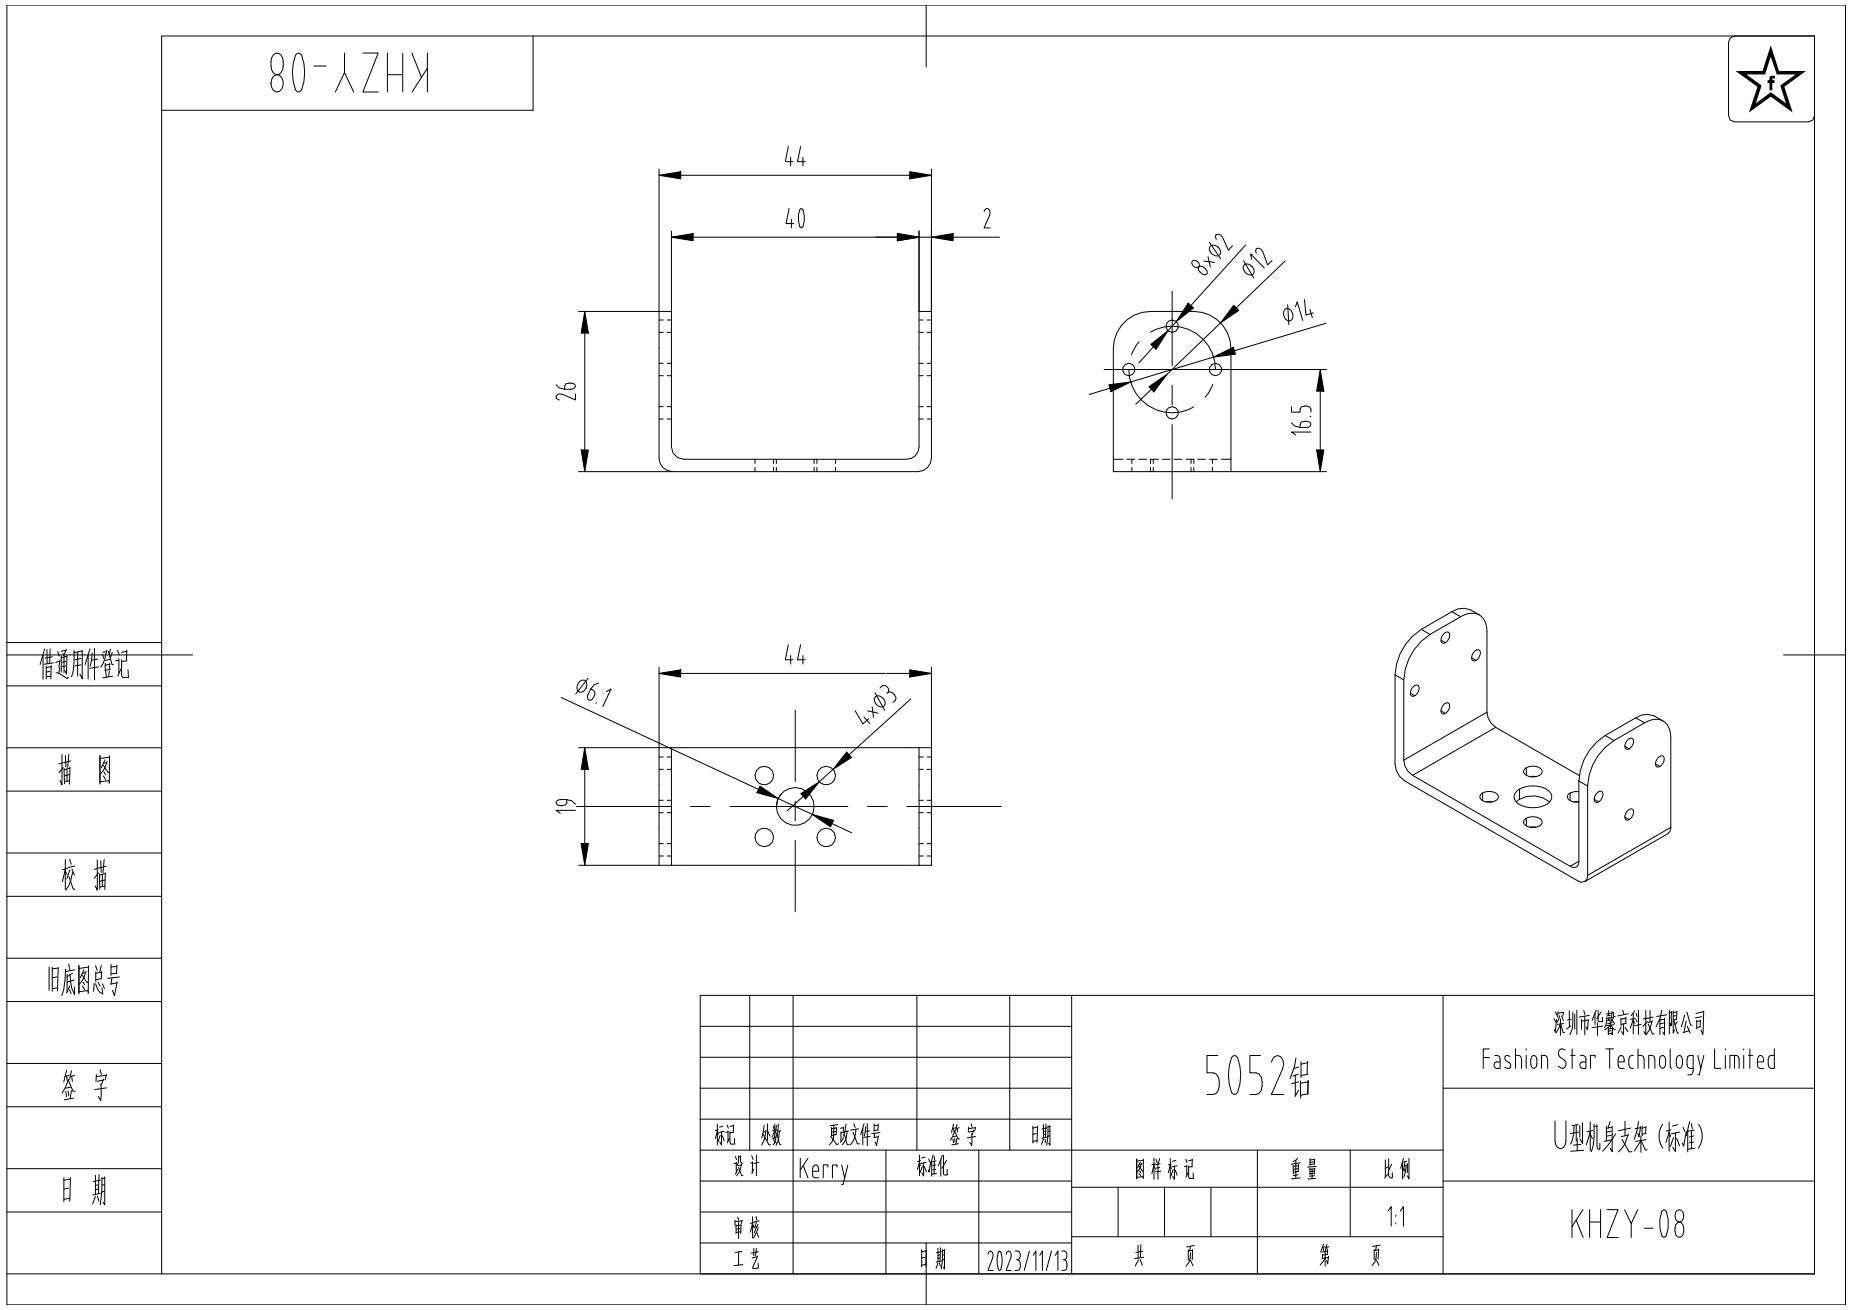
[picture p192: page 1]
