Lucaszyf/Solar-Enhanced-Biomimetic-UAV/cad/华馨京科技 25-50kg 舵机模型图纸（含配件）/华馨京 25-50kg舵机系列配件/华馨京 25-50kg舵机系列U型舵盘支架（50.7mm）支架尺寸图-PDF.pdf

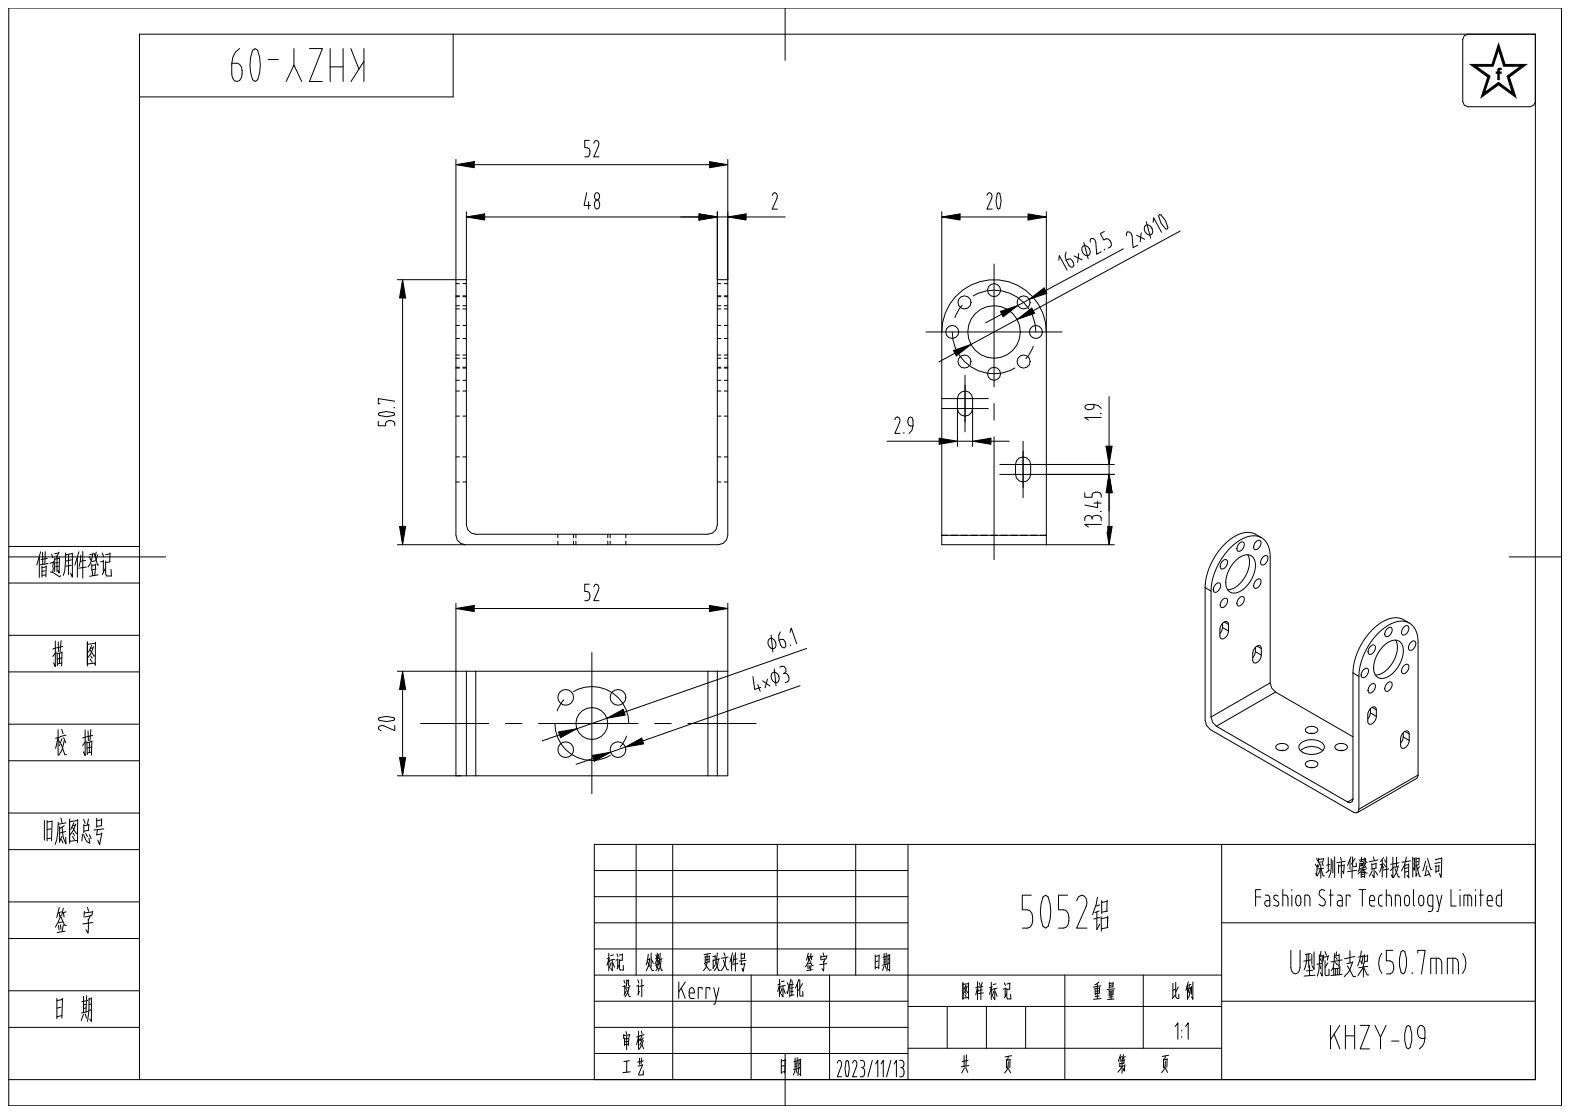
[picture p194: page 1]
