Lucaszyf/Solar-Enhanced-Biomimetic-UAV/cad/No1/3D尺寸图/202315抛投器零件PDF档/1.M2螺丝-Model.pdf

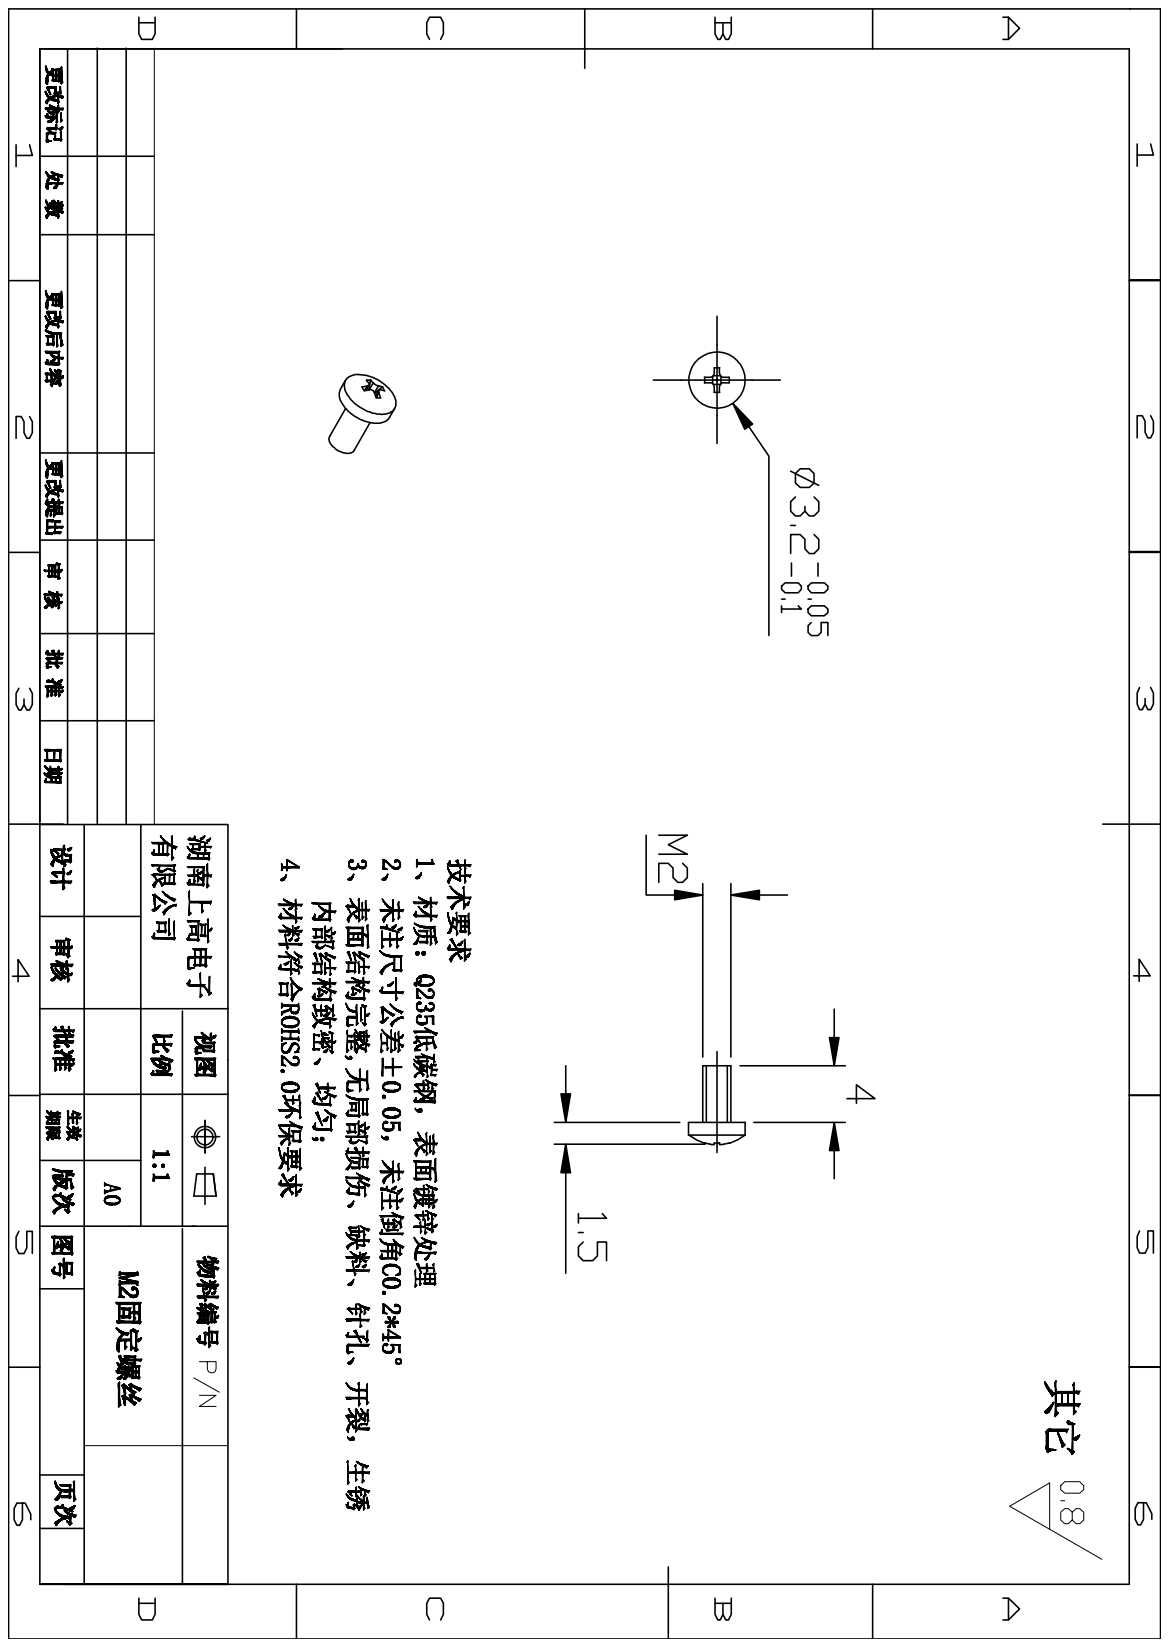
[picture p199: page 1]
