Lucaszyf/Solar-Enhanced-Biomimetic-UAV/cad/No1/3D尺寸图/202315抛投器零件PDF档/1.抛丸器图纸-Model.pdf

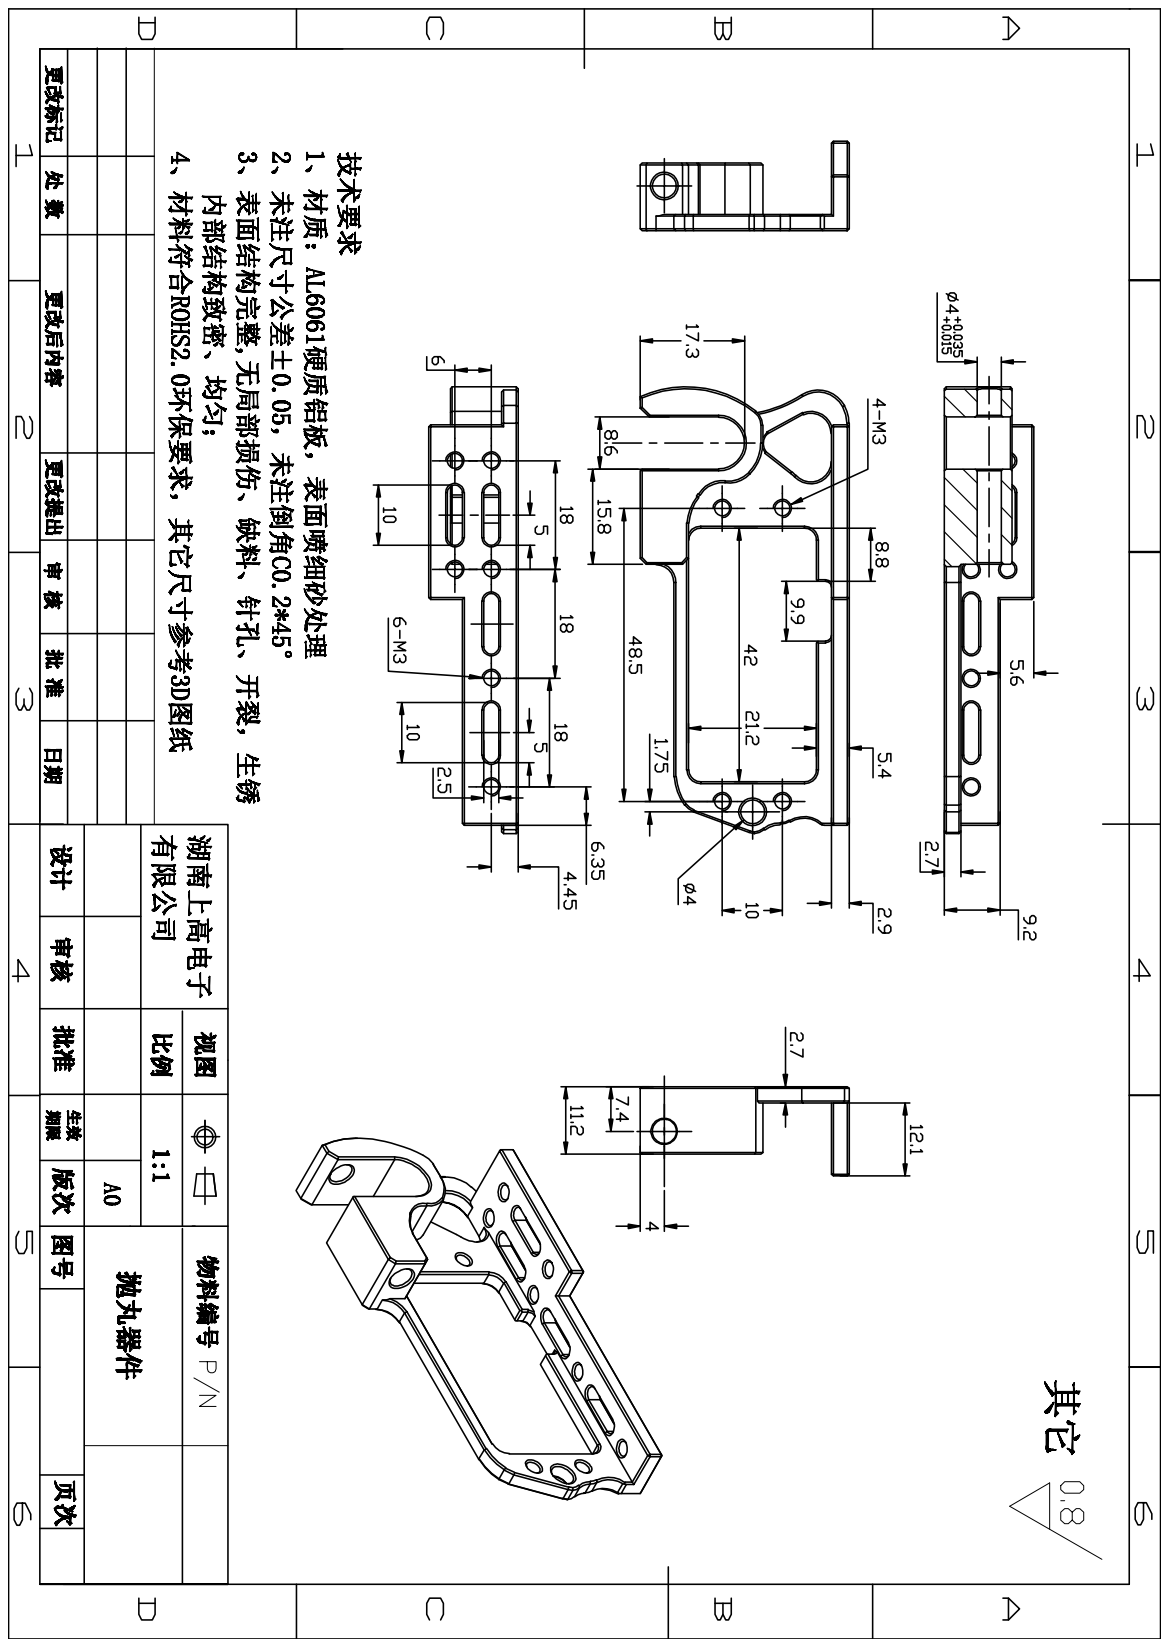
[picture p200: page 1]
