Lucaszyf/Solar-Enhanced-Biomimetic-UAV/cad/No1/3D尺寸图/202315抛投器零件PDF档/2.输出轴4-Model.pdf

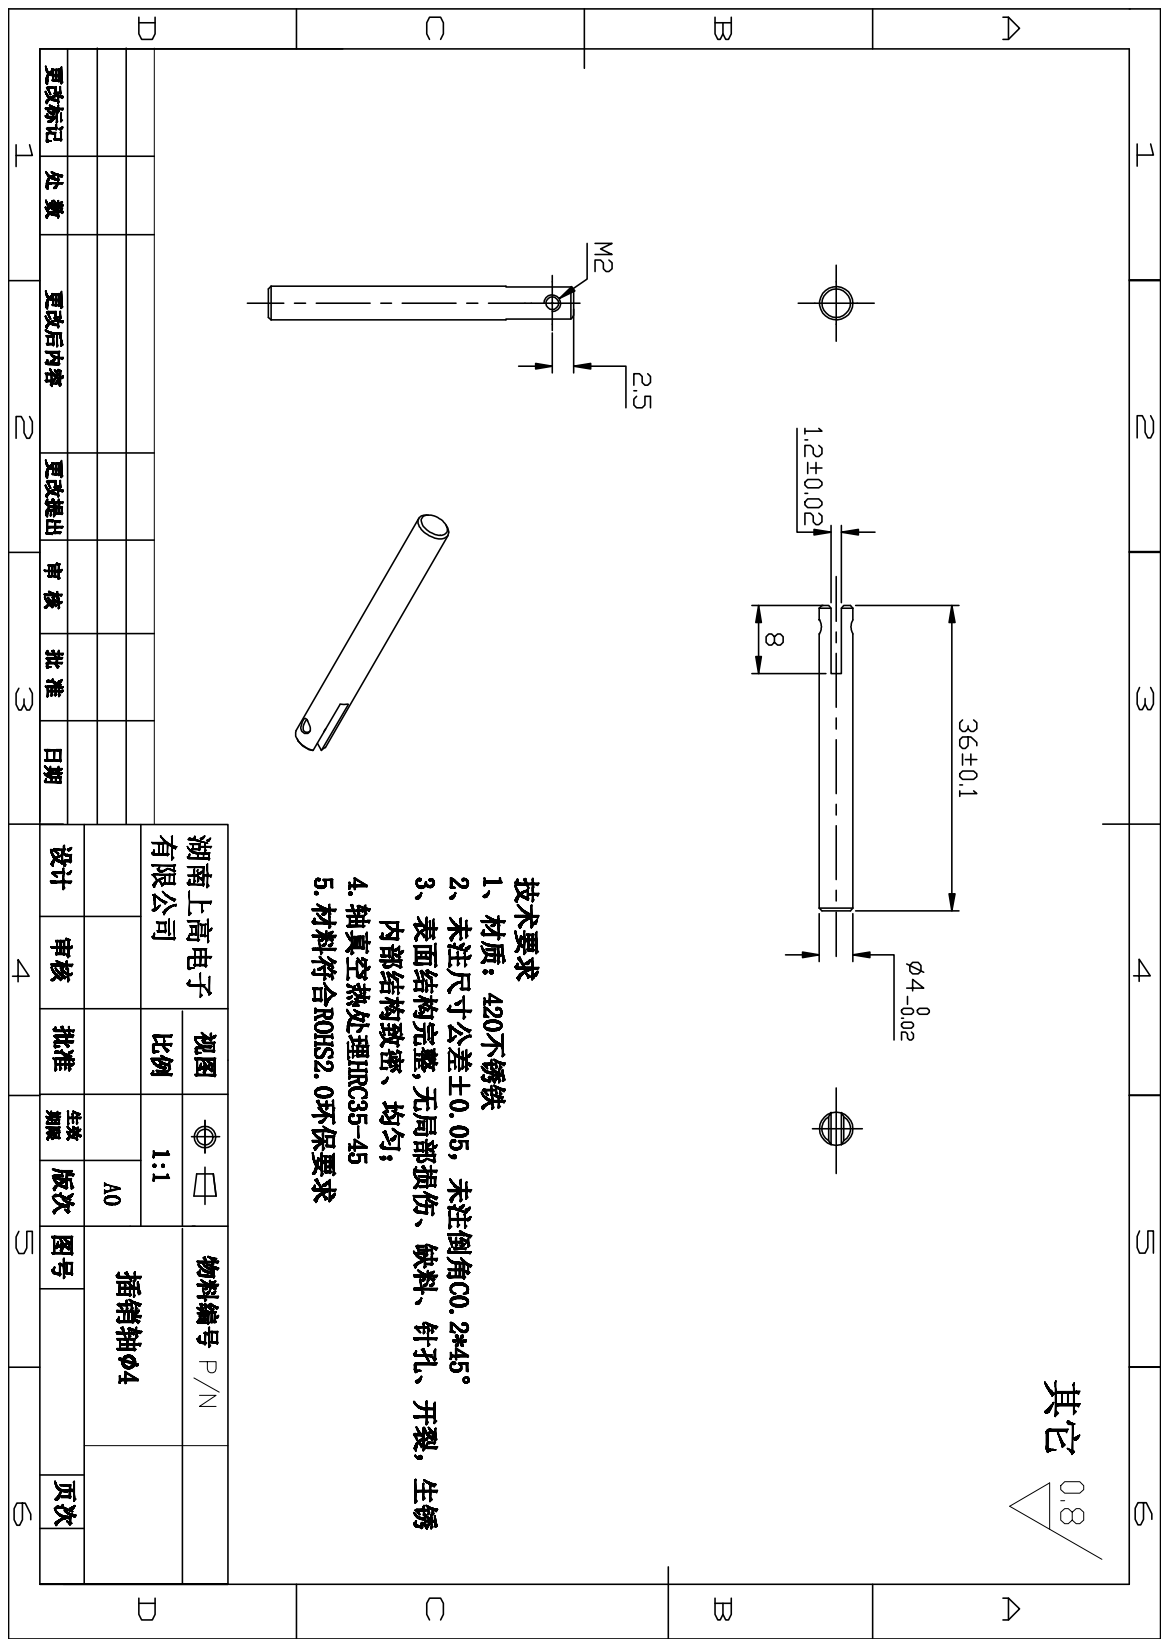
[picture p201: page 1]
