Lucaszyf/Solar-Enhanced-Biomimetic-UAV/cad/No1/3D尺寸图/202315抛投器零件PDF档/3.连杆片-Model.pdf

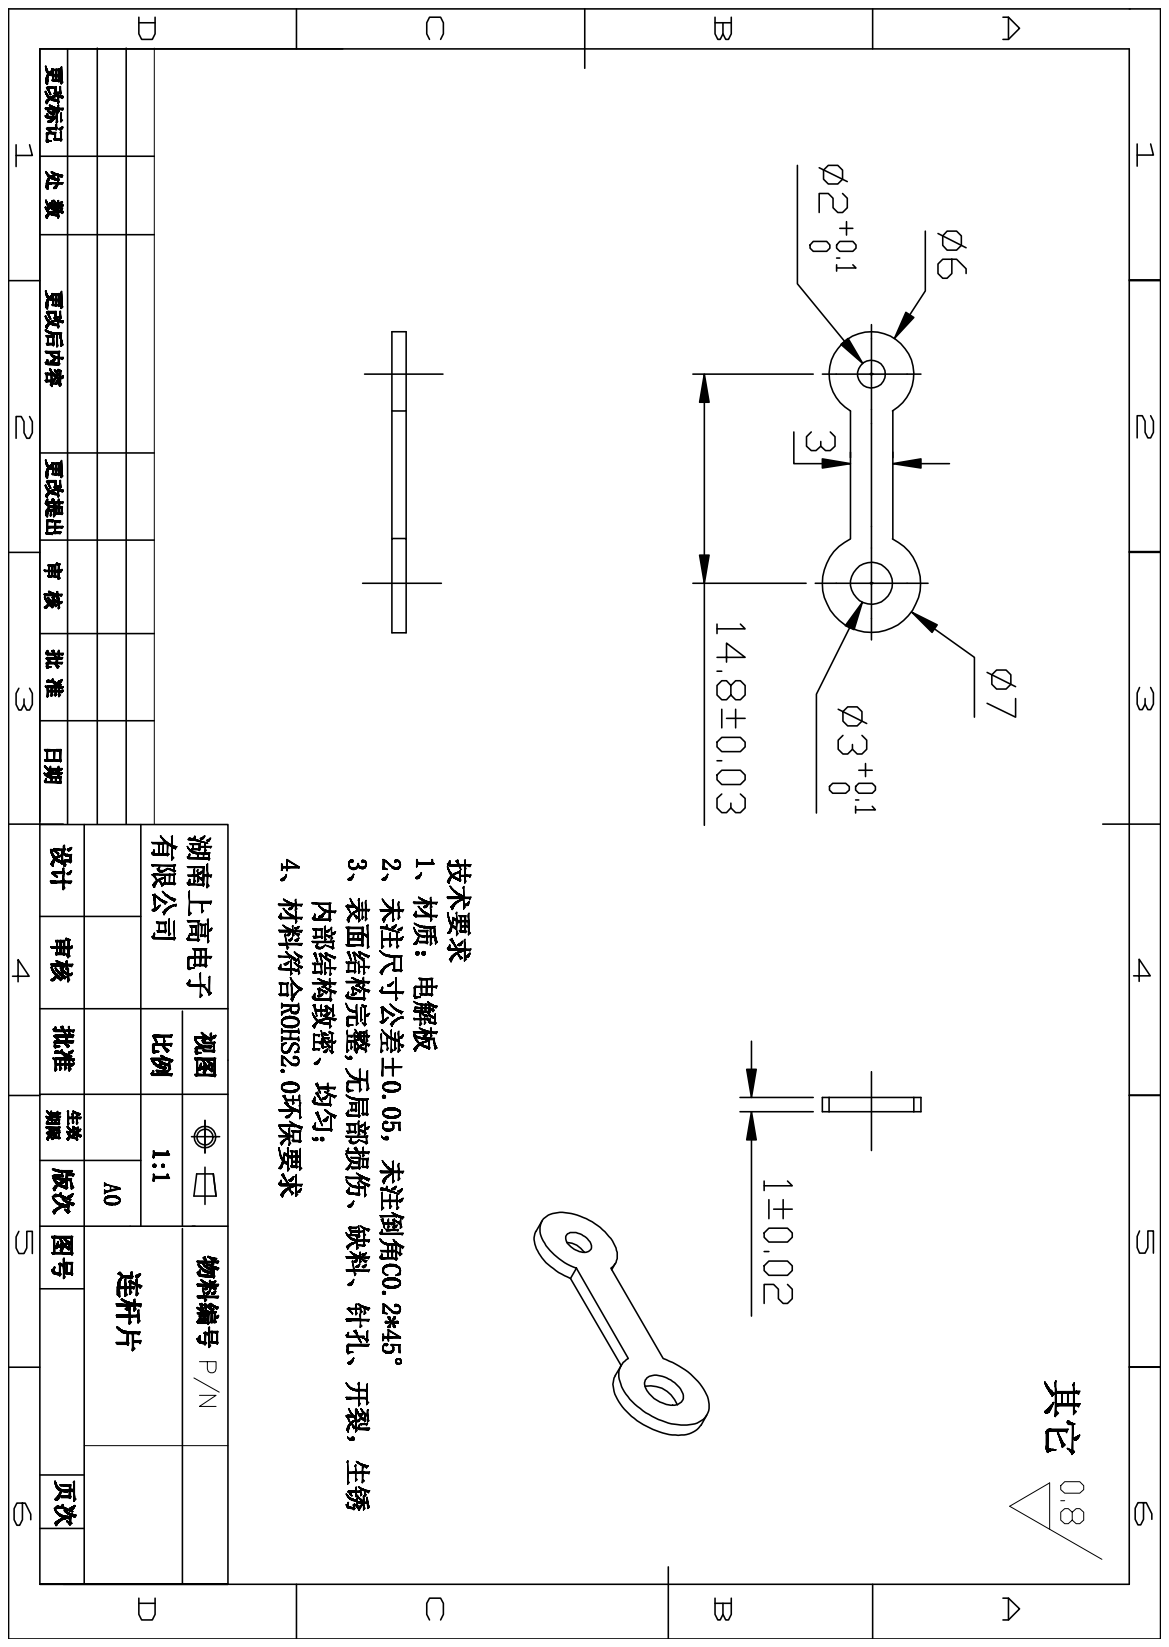
[picture p202: page 1]
