Lucaszyf/Solar-Enhanced-Biomimetic-UAV/cad/No1/3D尺寸图/202315抛投器零件PDF档/7.垫片4-Model.pdf

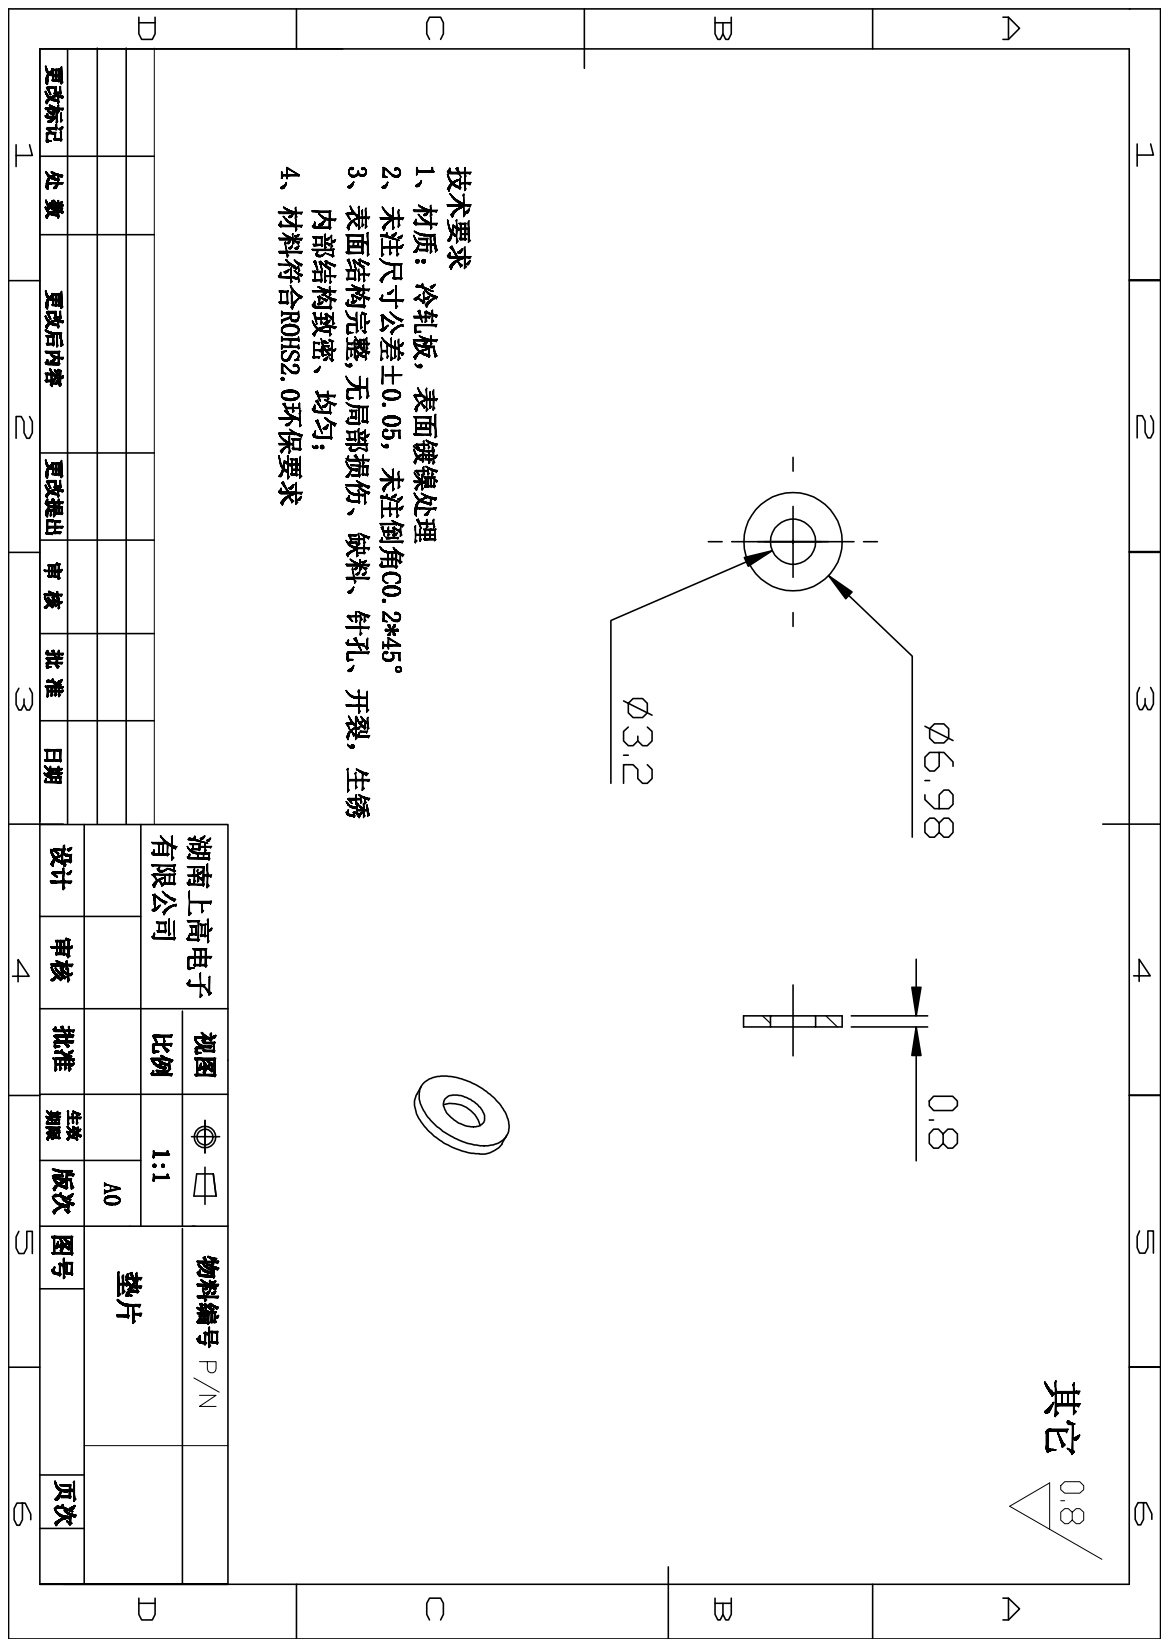
[picture p203: page 1]
