Lucaszyf/Solar-Enhanced-Biomimetic-UAV/cad/No1/3D尺寸图/202315抛投器零件PDF档/8.铝块垫3.0-Model.pdf

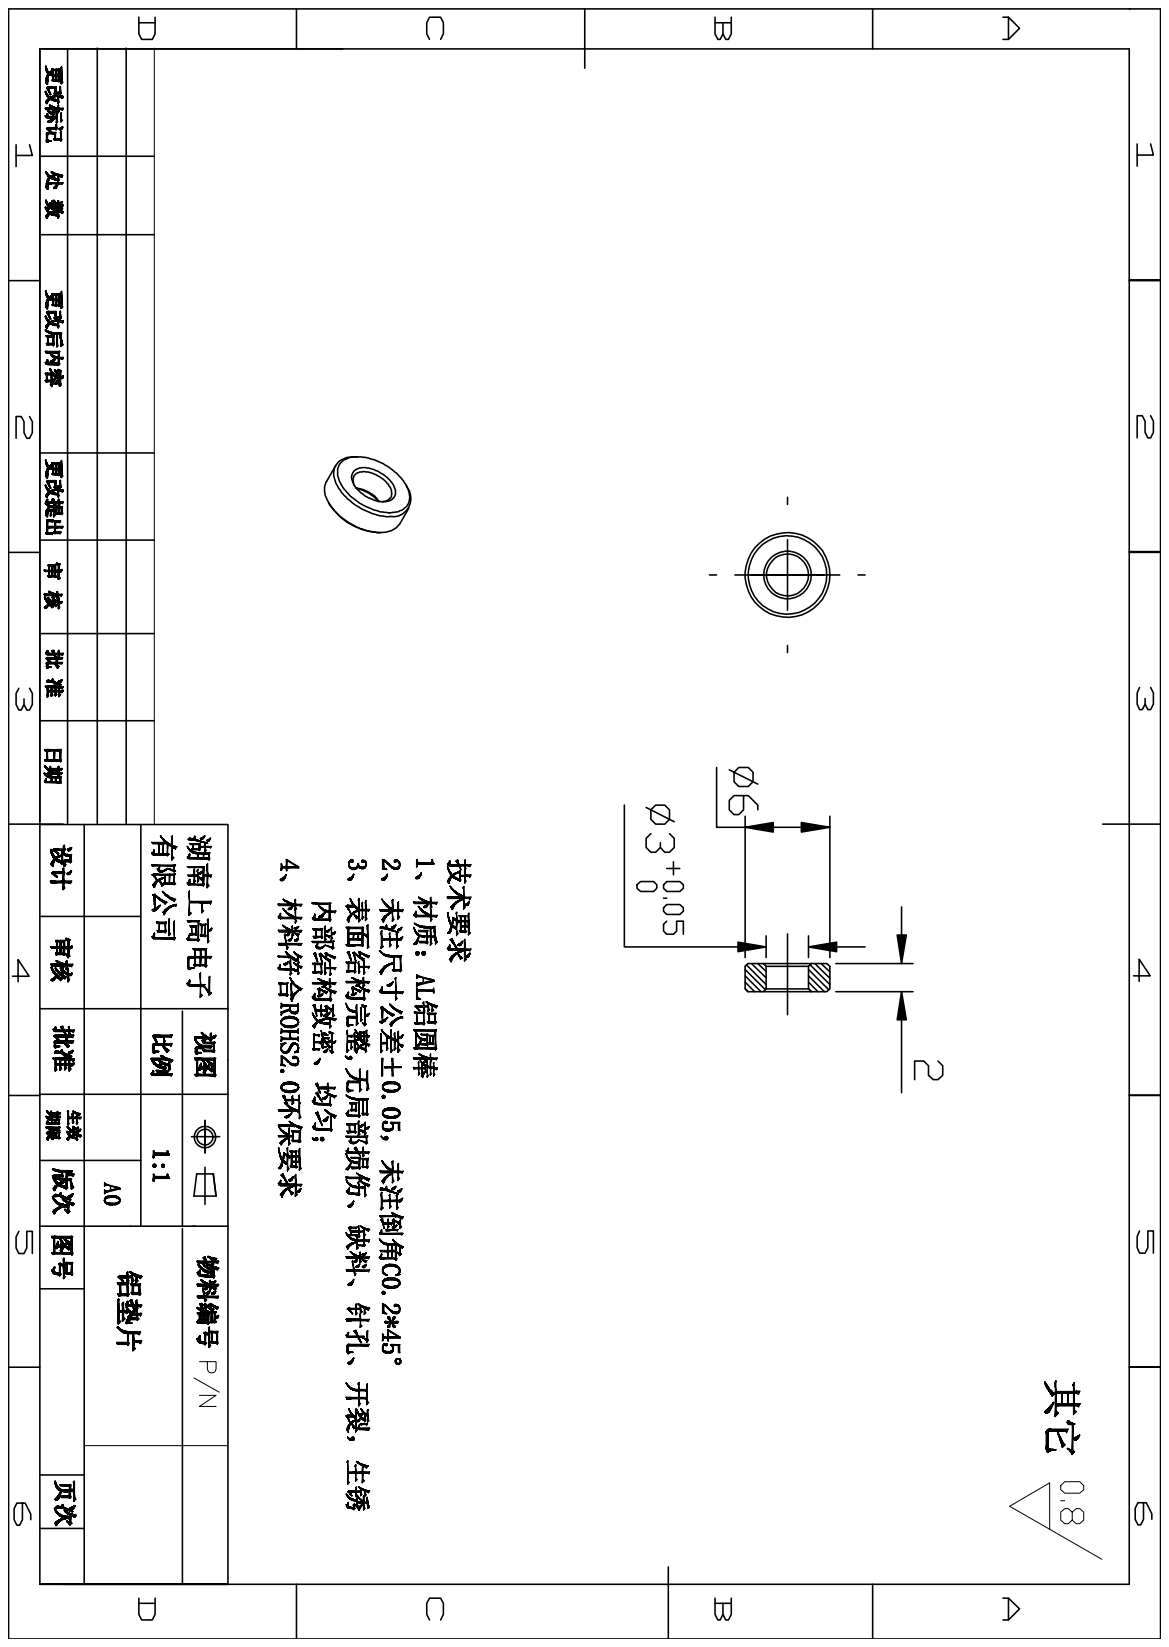
[picture p204: page 1]
