Lucaszyf/Solar-Enhanced-Biomimetic-UAV/cad/No1/3D尺寸图/202315抛投器零件PDF档/9.M3螺丝-Model.pdf

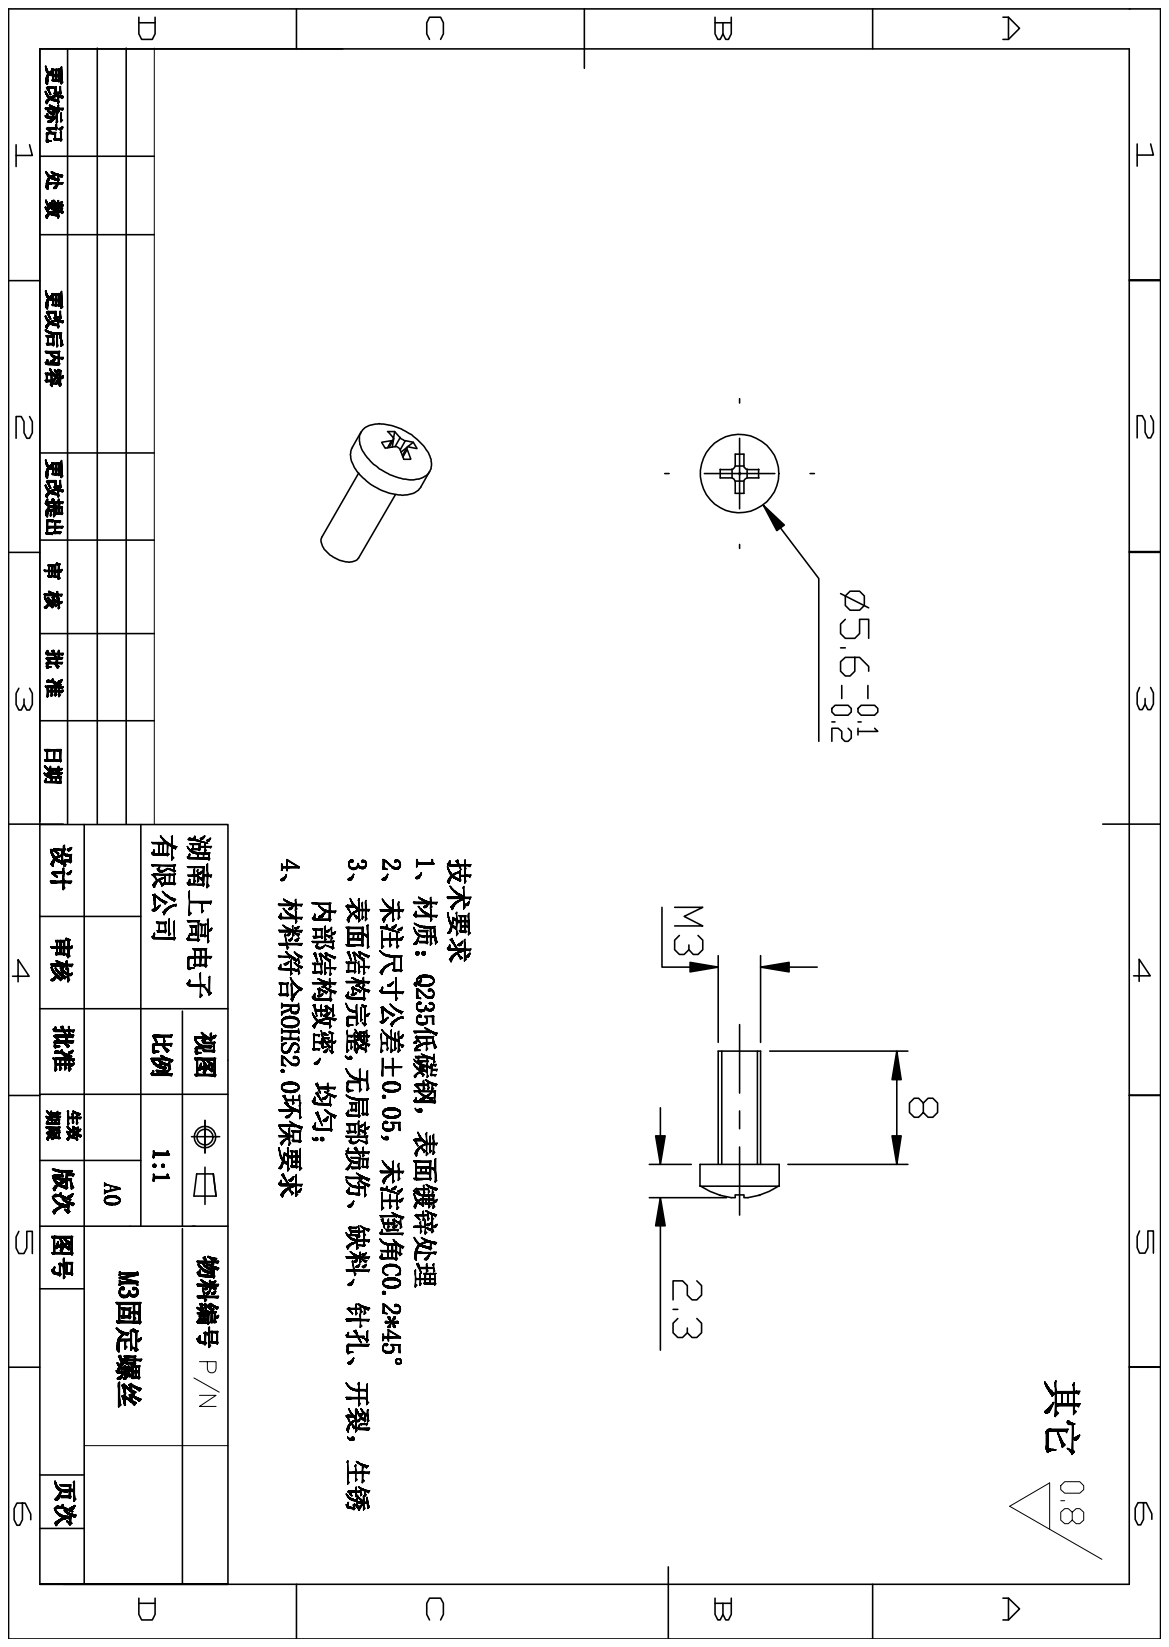
[picture p205: page 1]
