Lucaszyf/Solar-Enhanced-Biomimetic-UAV/cad/No1/3D尺寸图/舵机CAD及PDF档图纸/1.3.7克微型舵机-Model.pdf

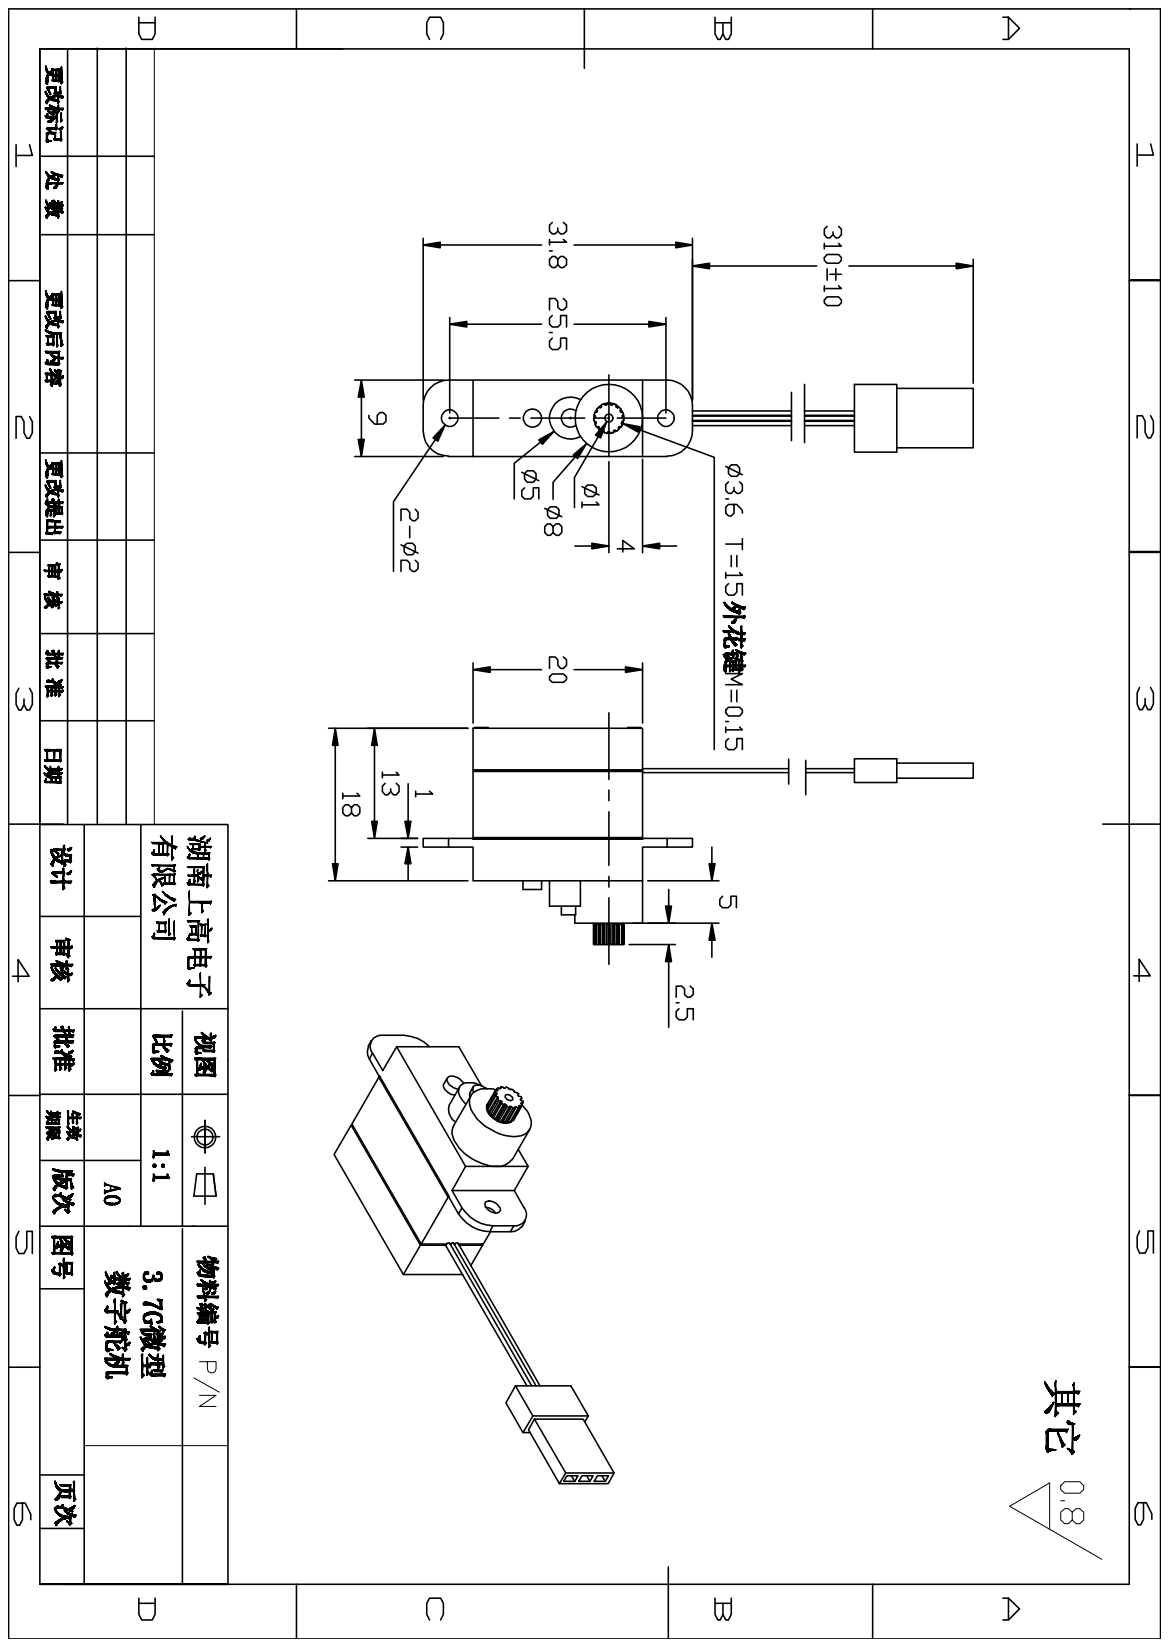
[picture p206: page 1]
