Lucaszyf/Solar-Enhanced-Biomimetic-UAV/cad/No1/3D尺寸图/舵机CAD及PDF档图纸/10.60KG全金属舵机外形图-Model.pdf

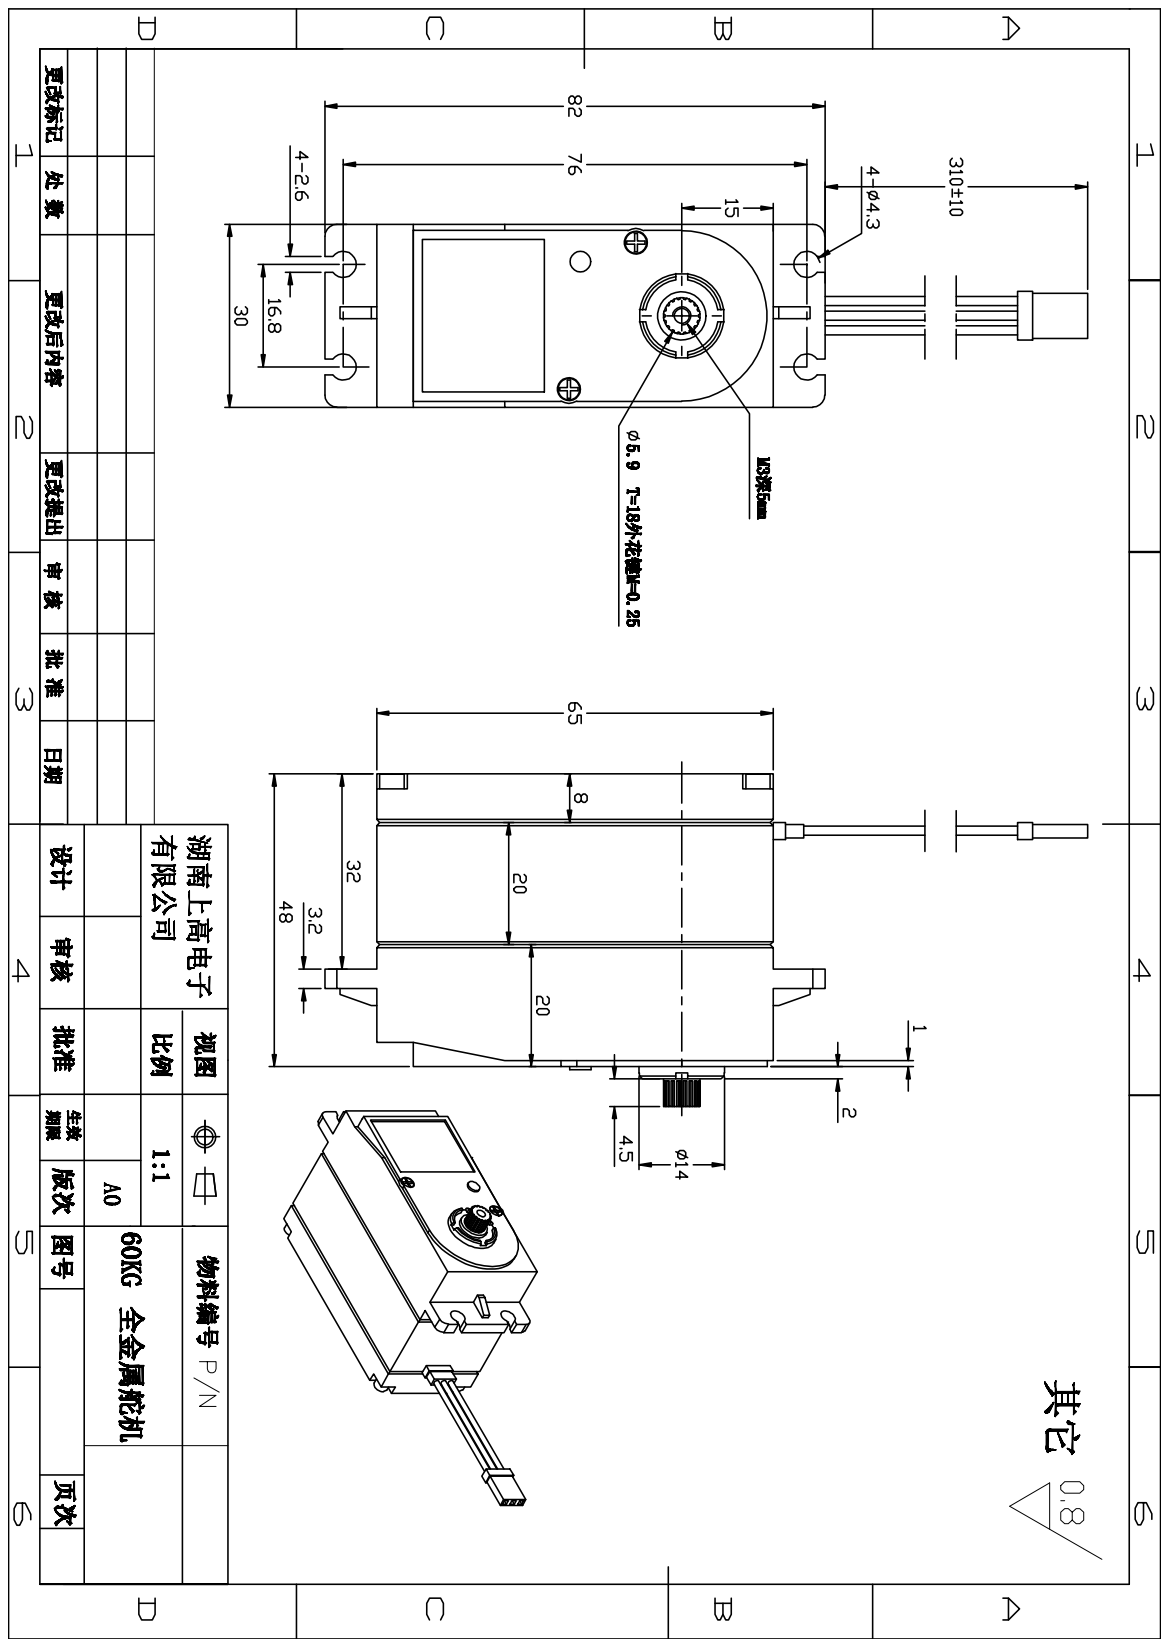
[picture p207: page 1]
