Lucaszyf/Solar-Enhanced-Biomimetic-UAV/cad/No1/3D尺寸图/舵机CAD及PDF档图纸/11.45KG铝壳舵机外形图-Model.pdf

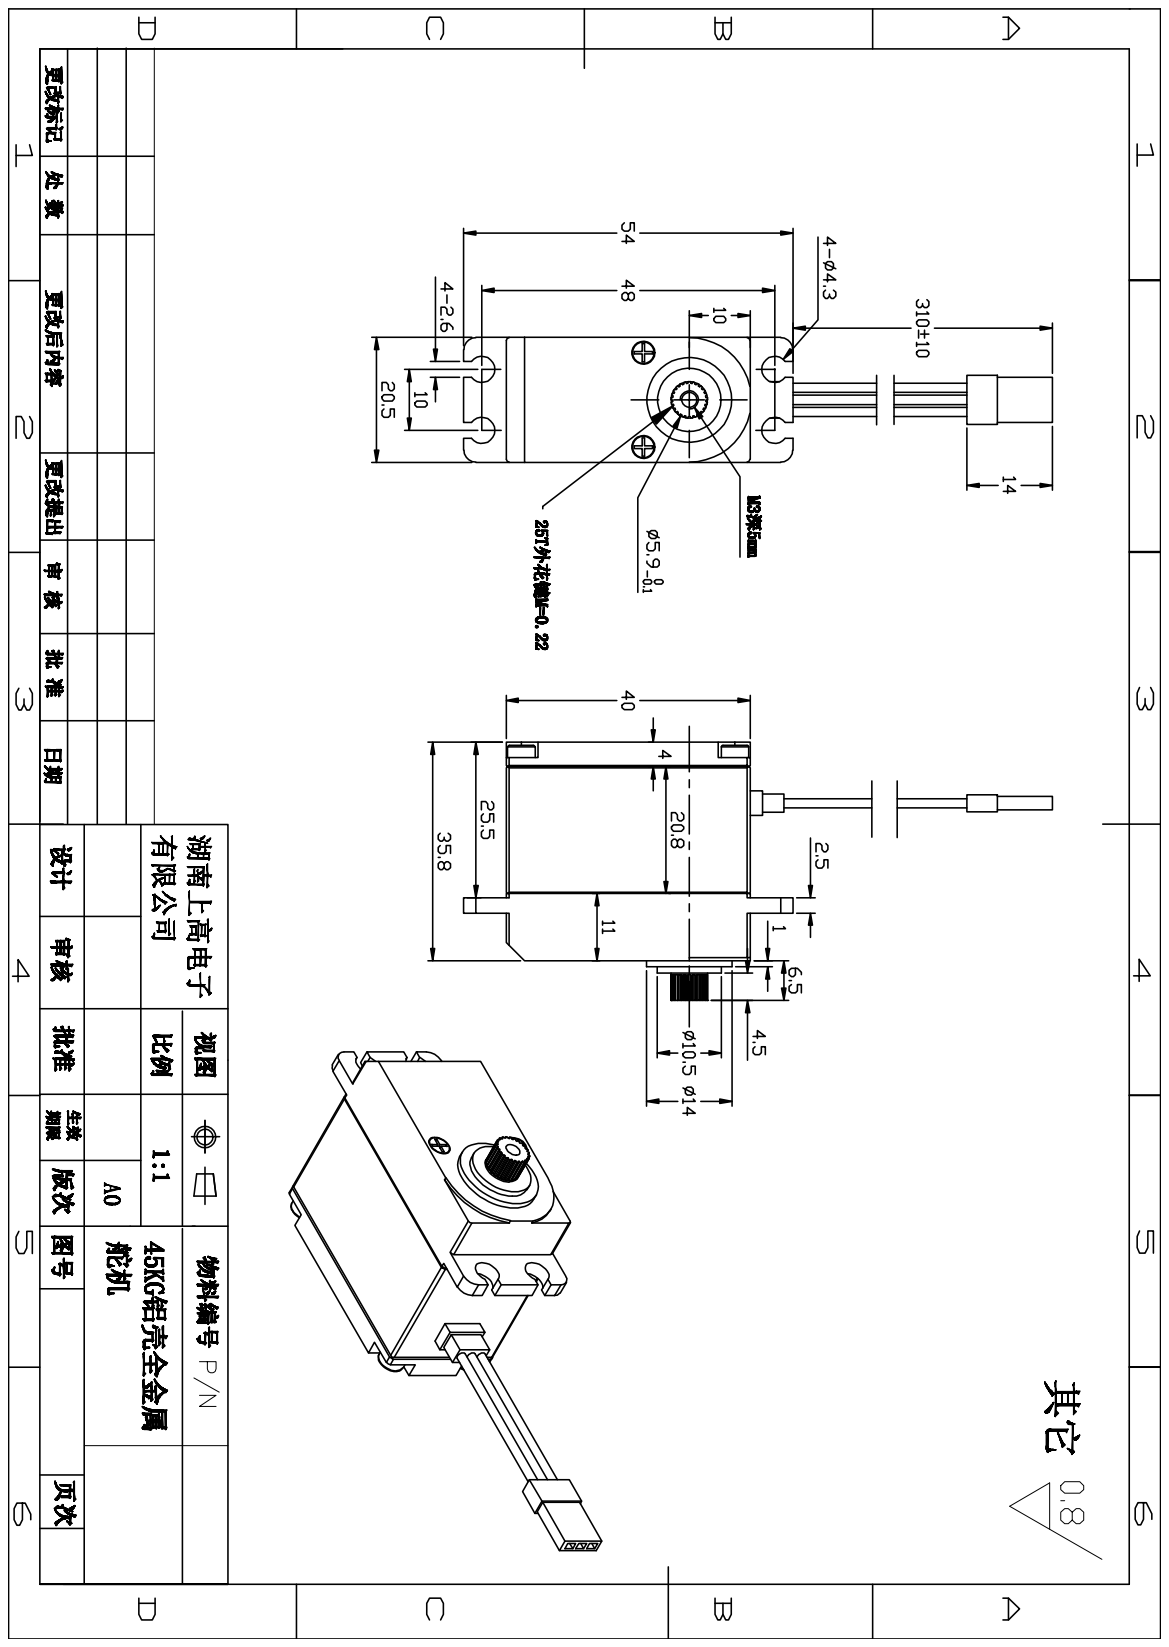
[picture p208: page 1]
