Lucaszyf/Solar-Enhanced-Biomimetic-UAV/cad/No1/3D尺寸图/舵机CAD及PDF档图纸/12.40KG铝壳舵机外形图-Model.pdf

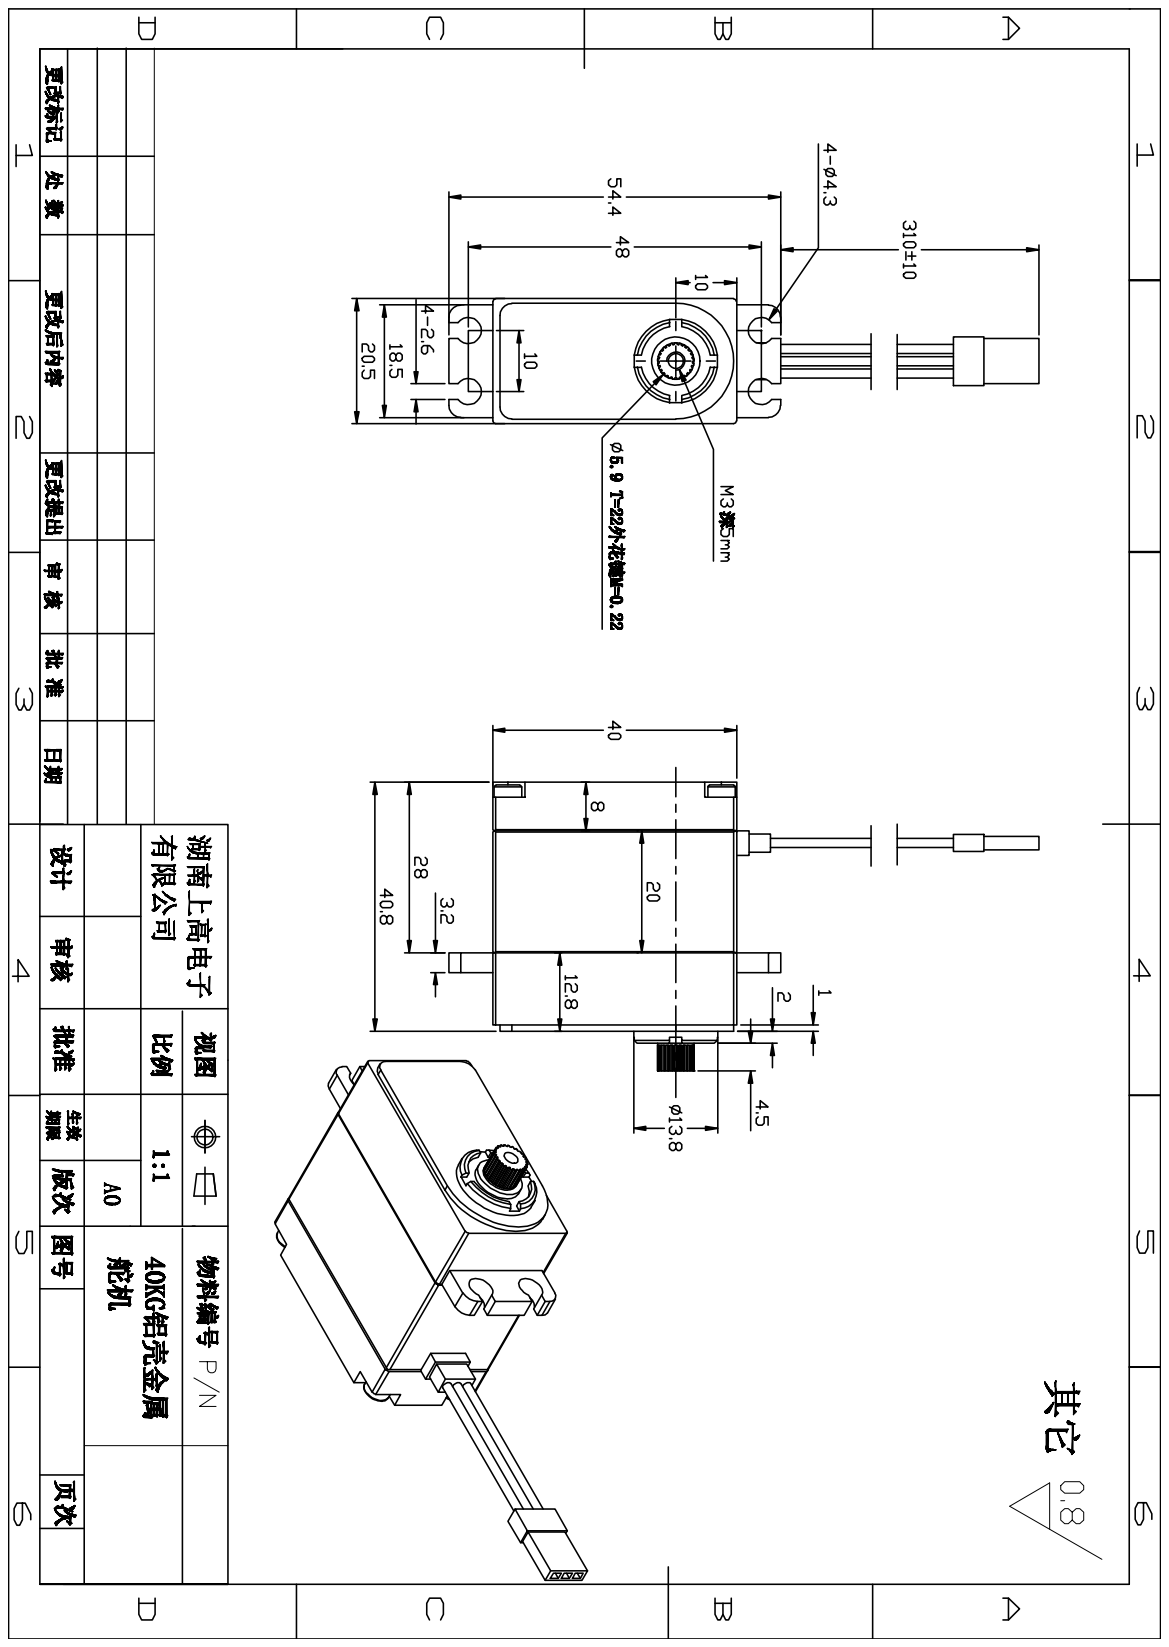
[picture p209: page 1]
