Lucaszyf/Solar-Enhanced-Biomimetic-UAV/cad/No1/3D尺寸图/舵机CAD及PDF档图纸/13.20G舵机外形图-Model.pdf

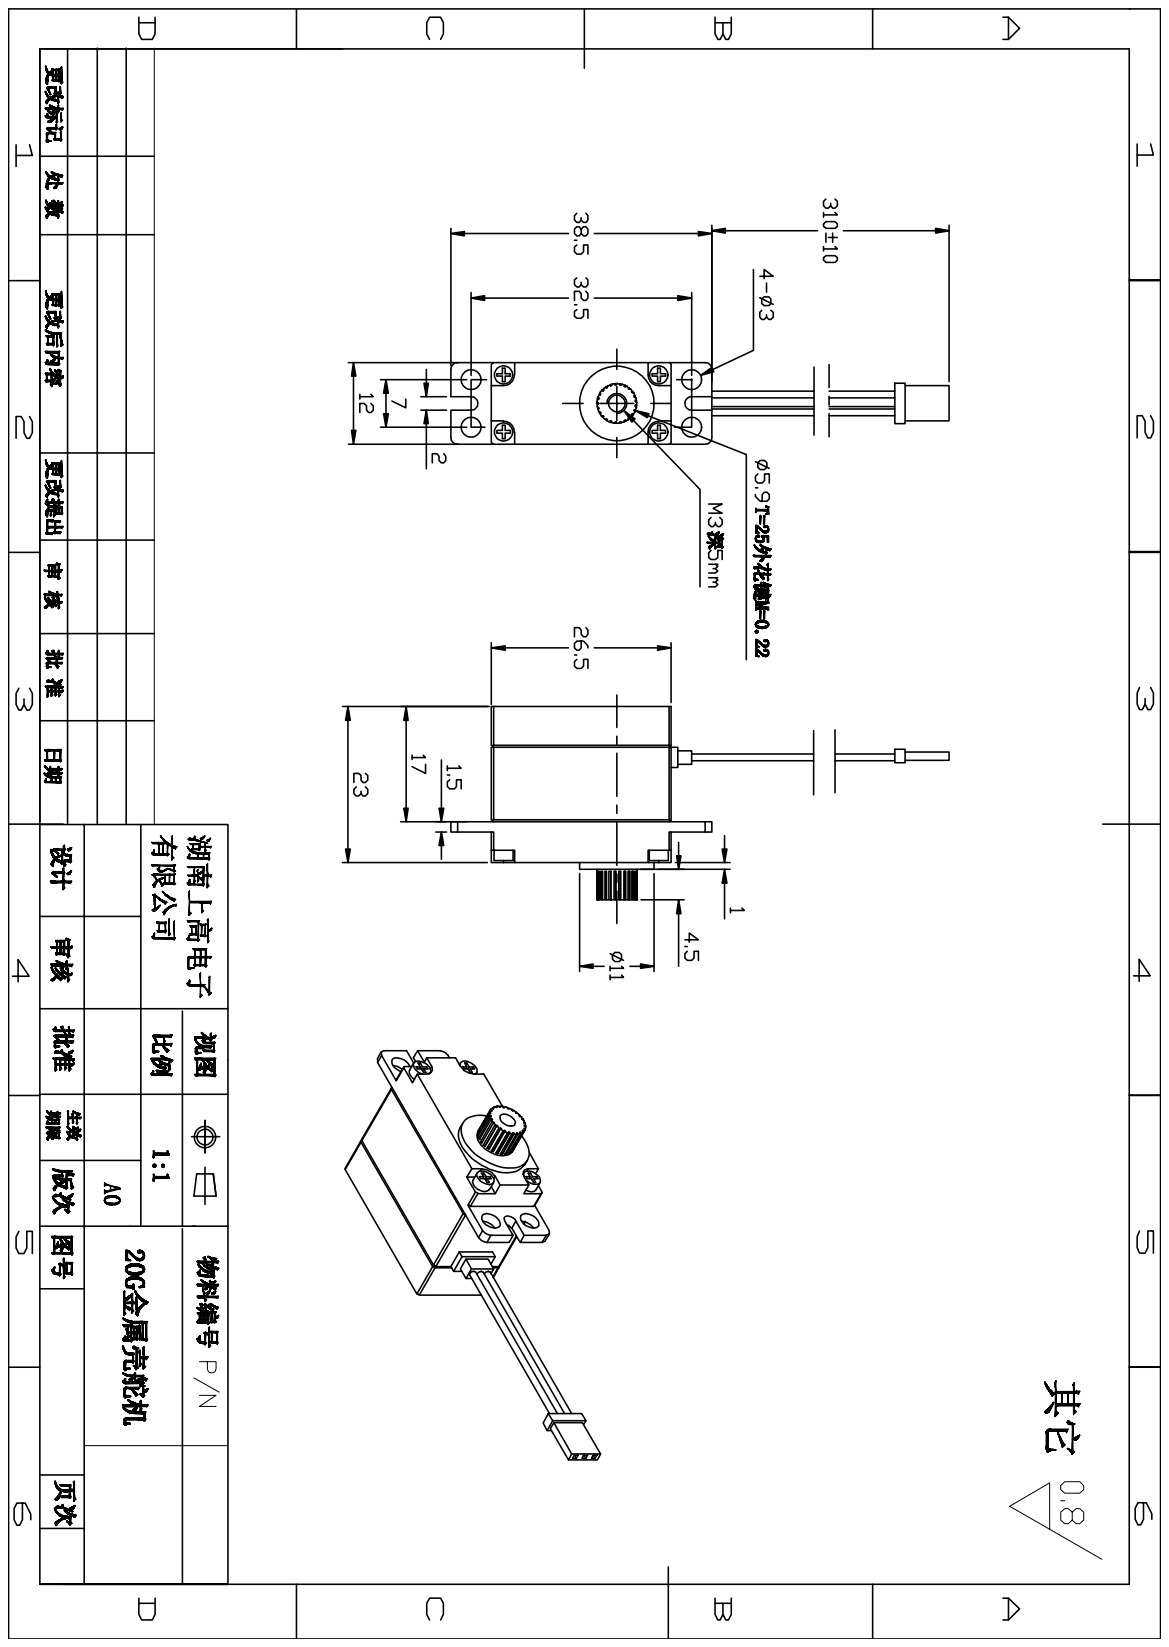
[picture p210: page 1]
