Lucaszyf/Solar-Enhanced-Biomimetic-UAV/cad/No1/3D尺寸图/舵机CAD及PDF档图纸/2.9克微型数字舵机-Model.pdf

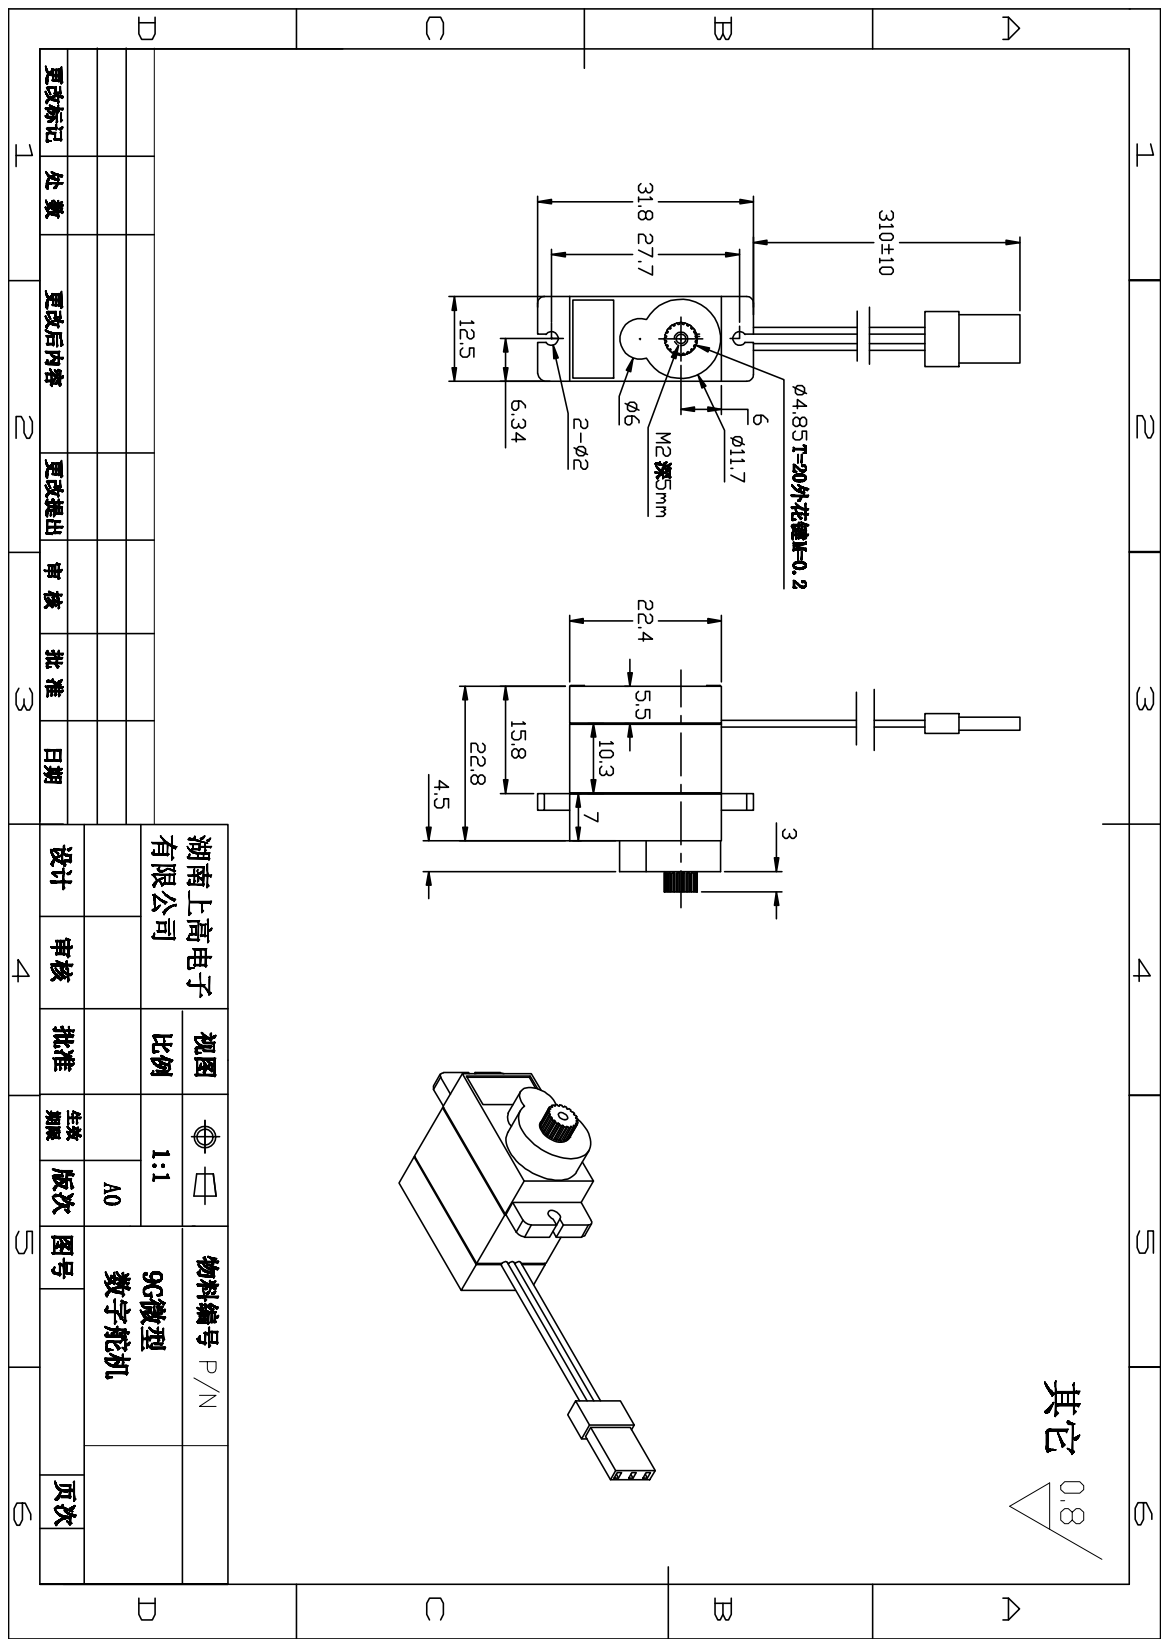
[picture p212: page 1]
