Lucaszyf/Solar-Enhanced-Biomimetic-UAV/cad/No1/3D尺寸图/舵机CAD及PDF档图纸/3.12KG舵机半金属外形图-Model.pdf

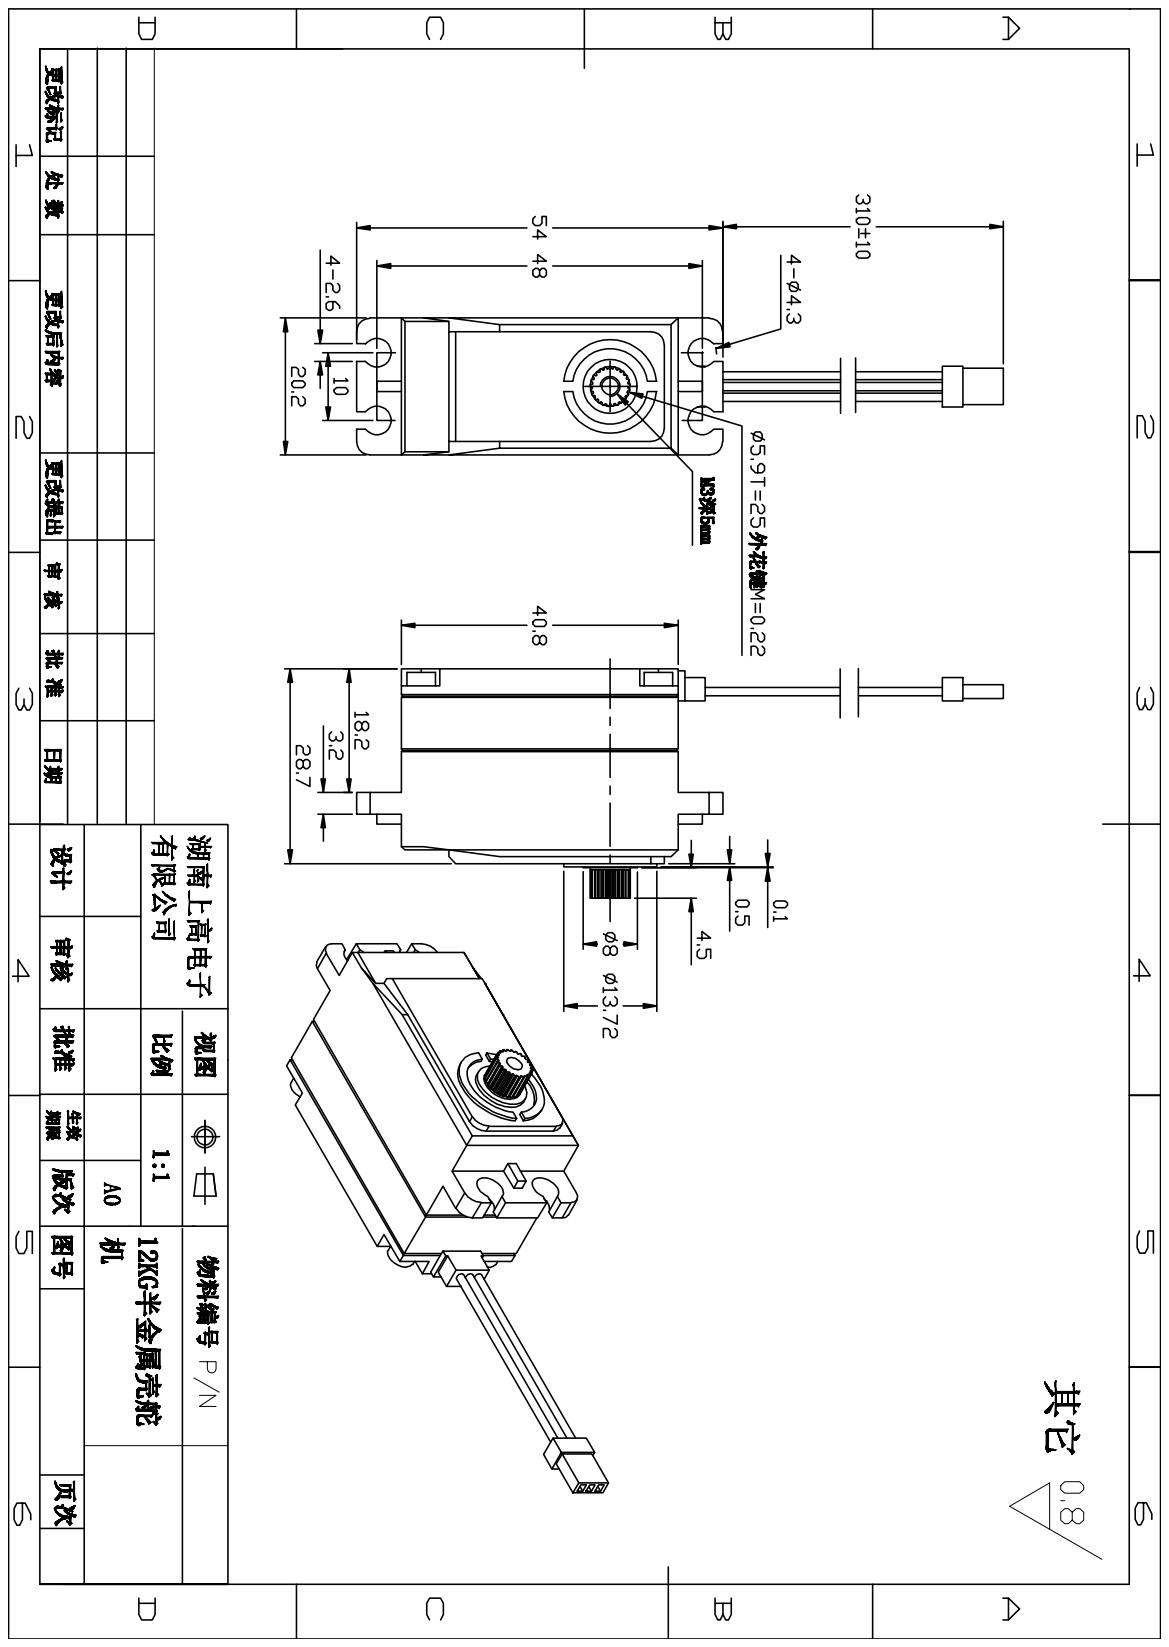
[picture p213: page 1]
