Lucaszyf/Solar-Enhanced-Biomimetic-UAV/cad/No1/3D尺寸图/舵机CAD及PDF档图纸/4.12KG舵机全金属外形图-Model.pdf

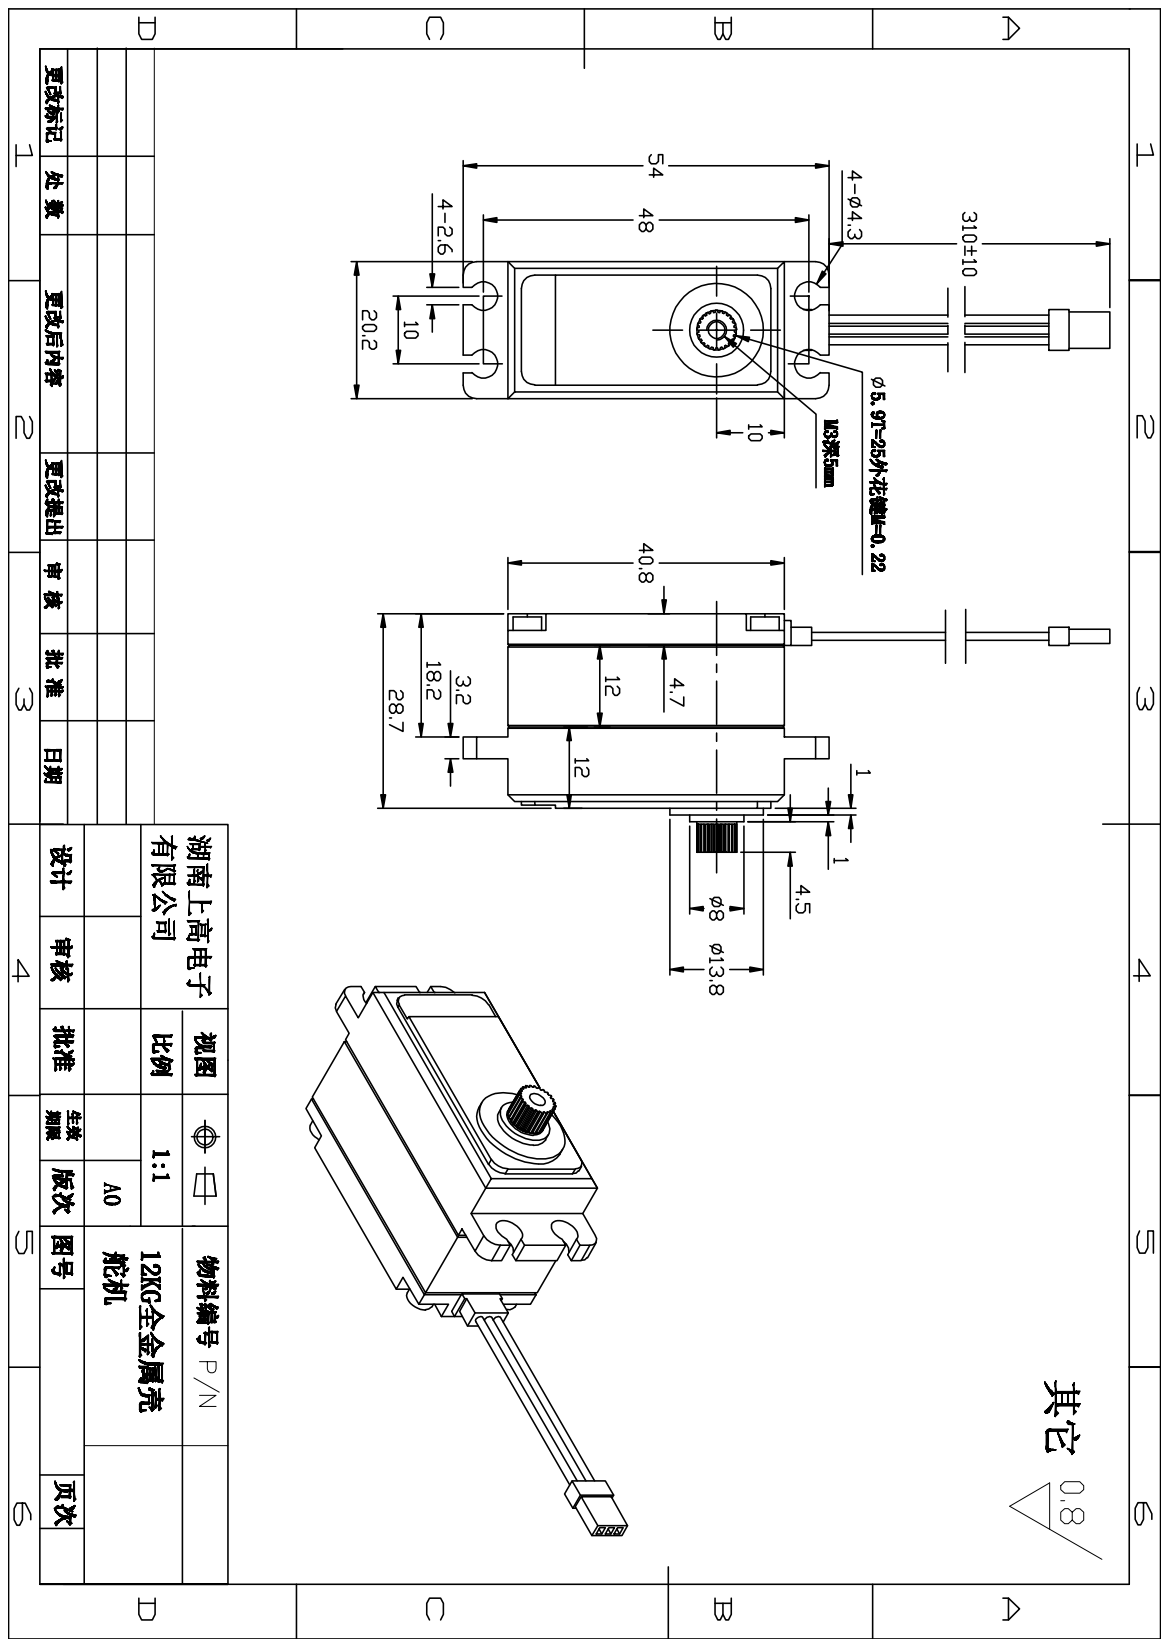
[picture p214: page 1]
