Lucaszyf/Solar-Enhanced-Biomimetic-UAV/cad/No1/3D尺寸图/舵机CAD及PDF档图纸/5,20KG全金属舵机外形图-Model.pdf

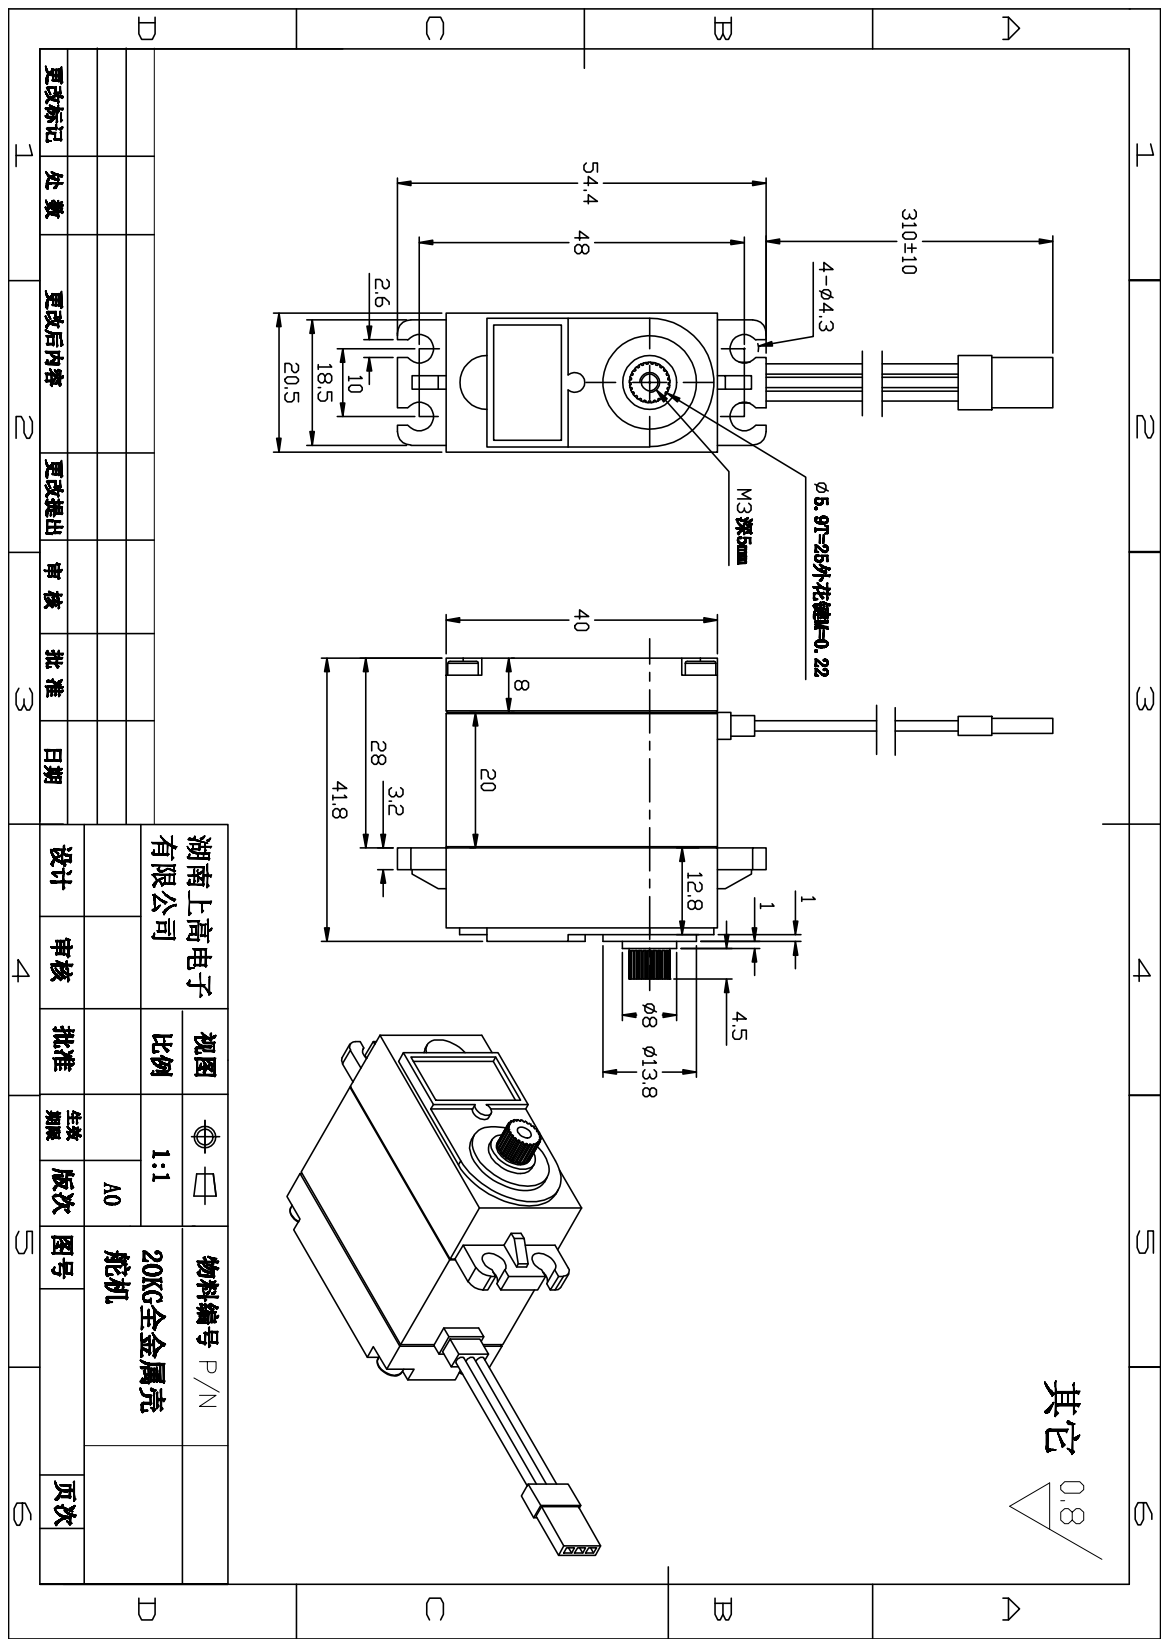
[picture p215: page 1]
