Lucaszyf/Solar-Enhanced-Biomimetic-UAV/cad/No1/3D尺寸图/舵机CAD及PDF档图纸/6.25KG铝中壳舵机外形图-Model.pdf

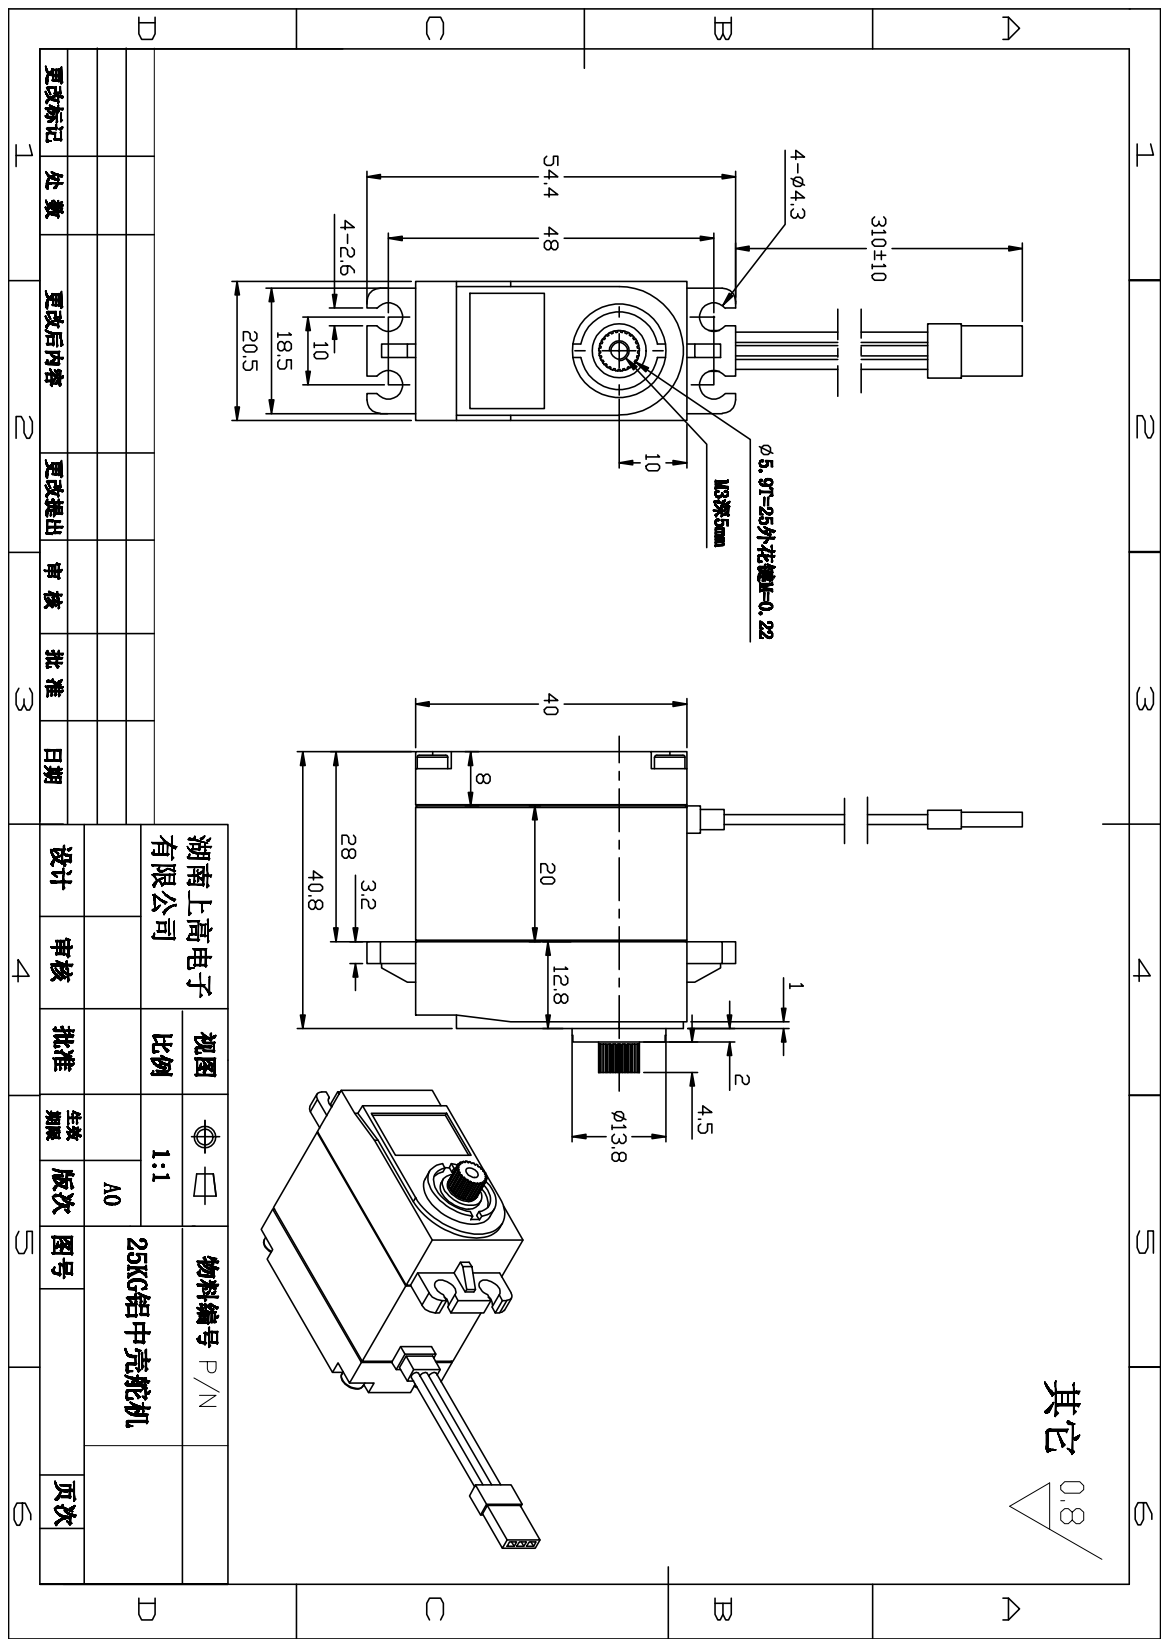
[picture p216: page 1]
