Lucaszyf/Solar-Enhanced-Biomimetic-UAV/cad/No1/3D尺寸图/舵机CAD及PDF档图纸/7.35KG铝壳舵机双出轴外形图-Model.pdf

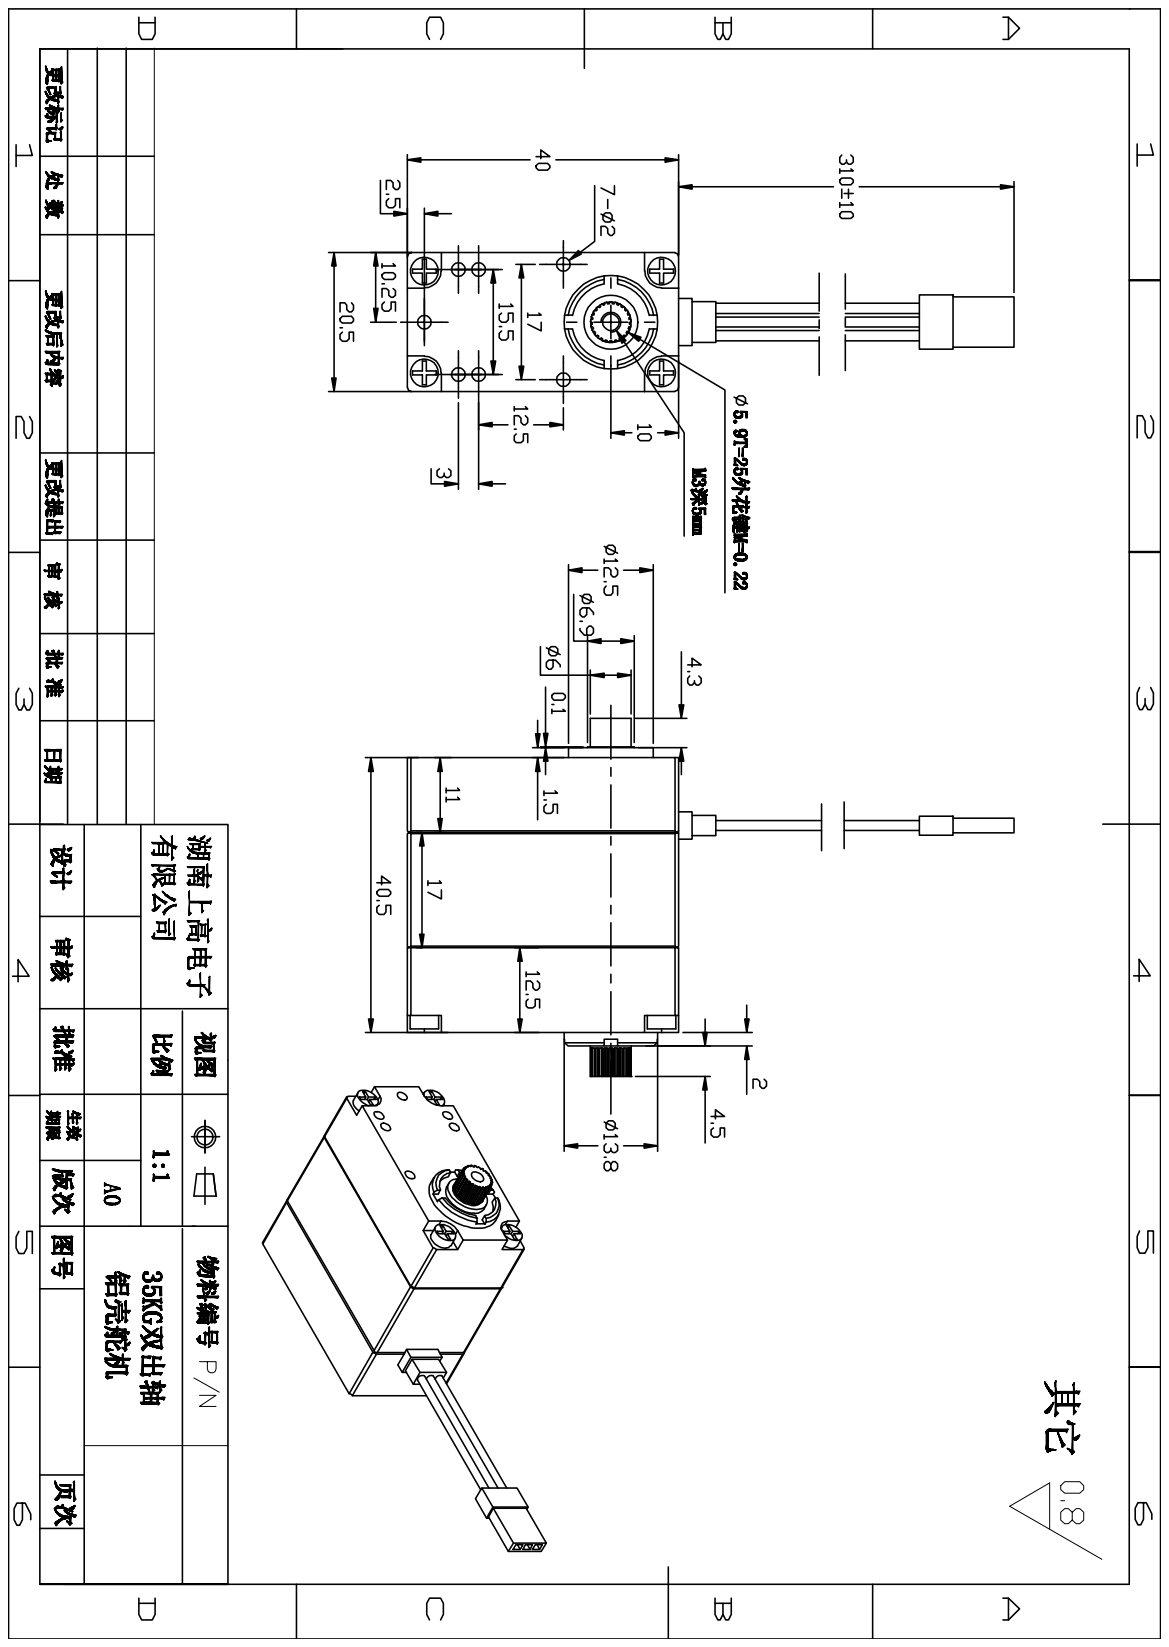
[picture p217: page 1]
