Lucaszyf/Solar-Enhanced-Biomimetic-UAV/cad/No1/3D尺寸图/舵机CAD及PDF档图纸/8.35KG塑胶壳舵机双出轴外形图-Model.pdf

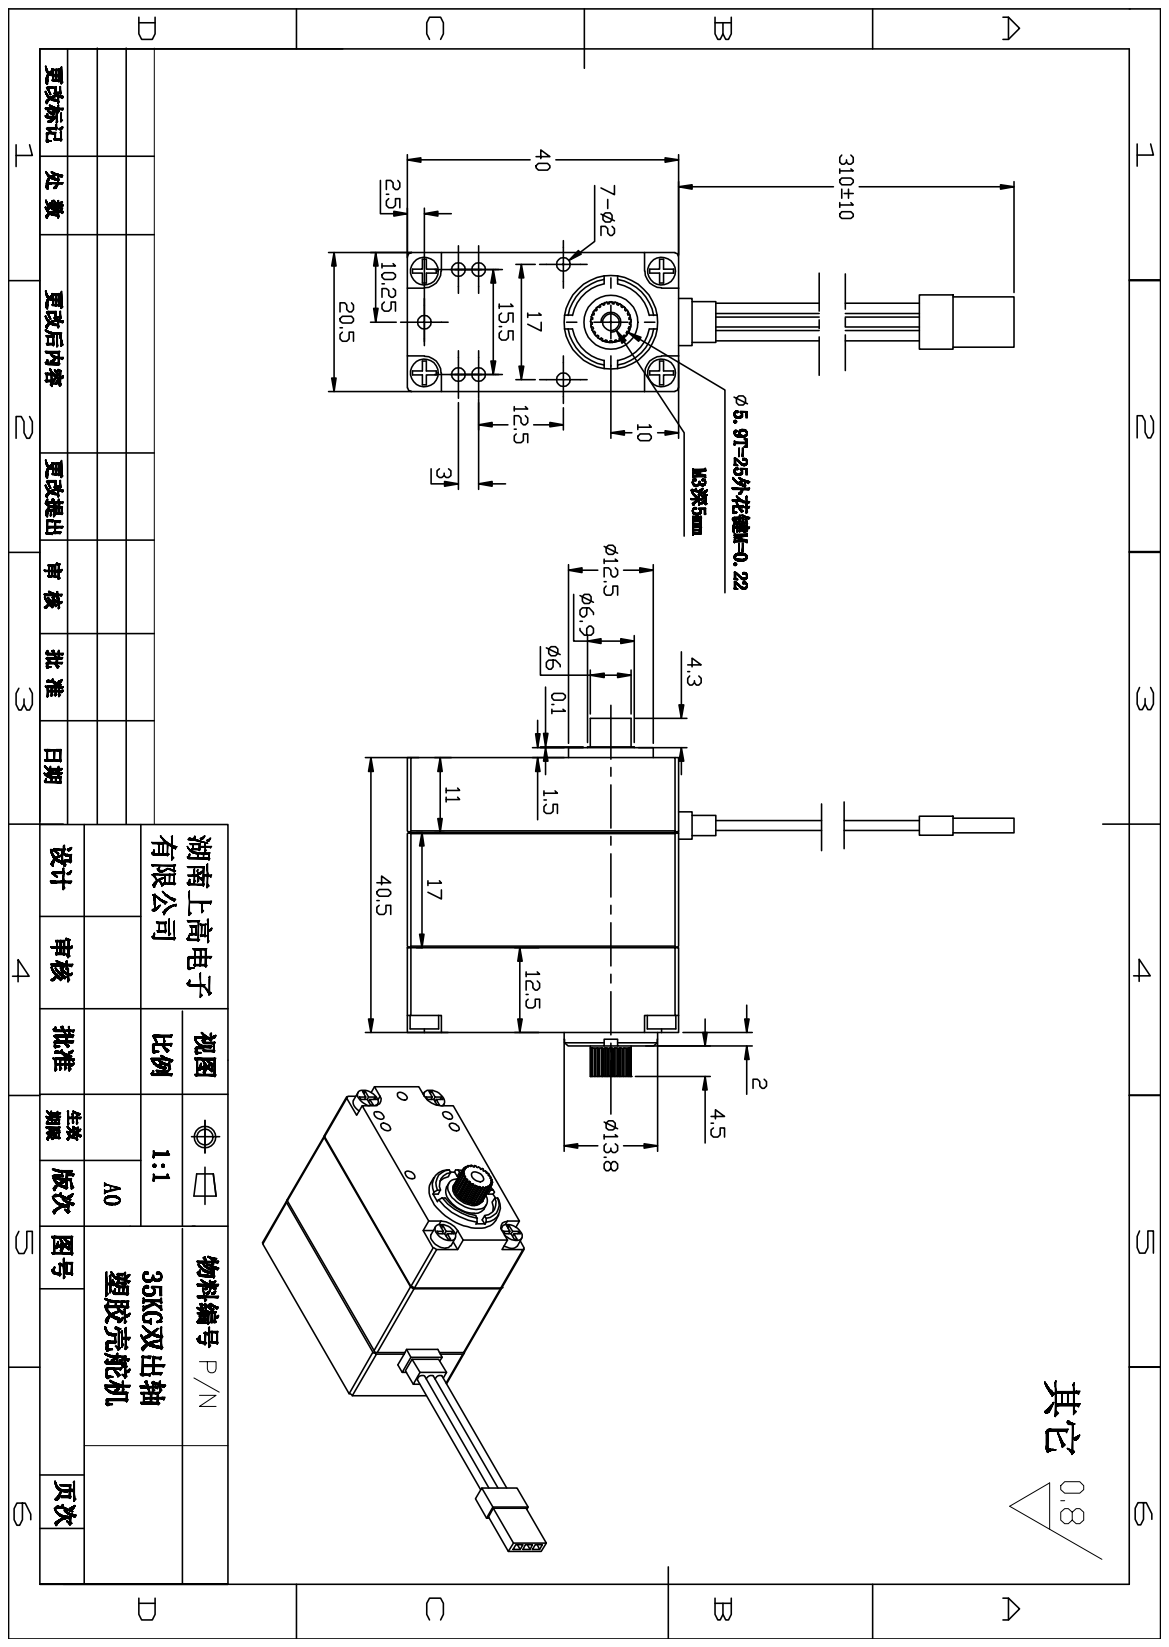
[picture p218: page 1]
