Lucaszyf/Solar-Enhanced-Biomimetic-UAV/cad/华馨京科技 25-50kg 舵机模型图纸（含配件）/华馨京 舵机 D型输出轴系列/华馨京 25-50kg单轴舵机外观尺寸图-D型输出轴/华馨京 25-50kg单轴舵机外观尺寸图（D轴）-PDF.pdf

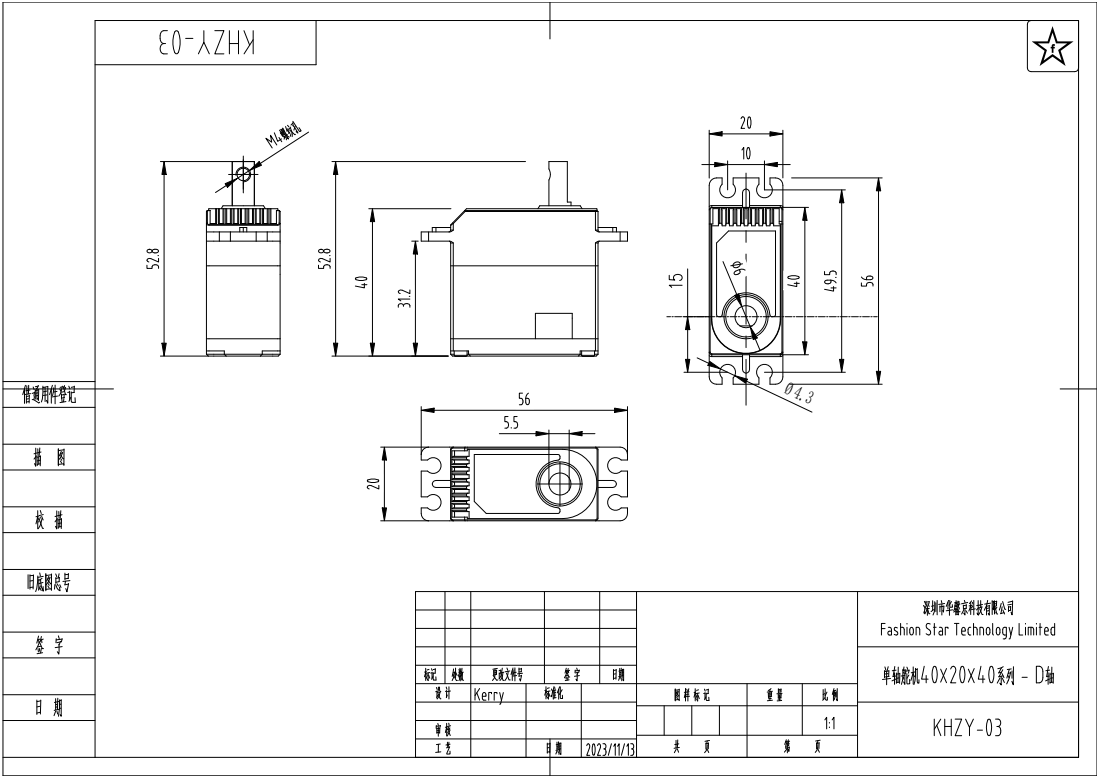
[picture p220: page 1]
