Lucaszyf/Solar-Enhanced-Biomimetic-UAV/cad/华馨京科技 25-50kg 舵机模型图纸（含配件）/华馨京 舵机 D型输出轴系列/华馨京 单轴舵机 RX8-U29H-M D型输出轴/华馨京 RX8-U29H-M 尺寸图（D型输出轴）-PDF.pdf

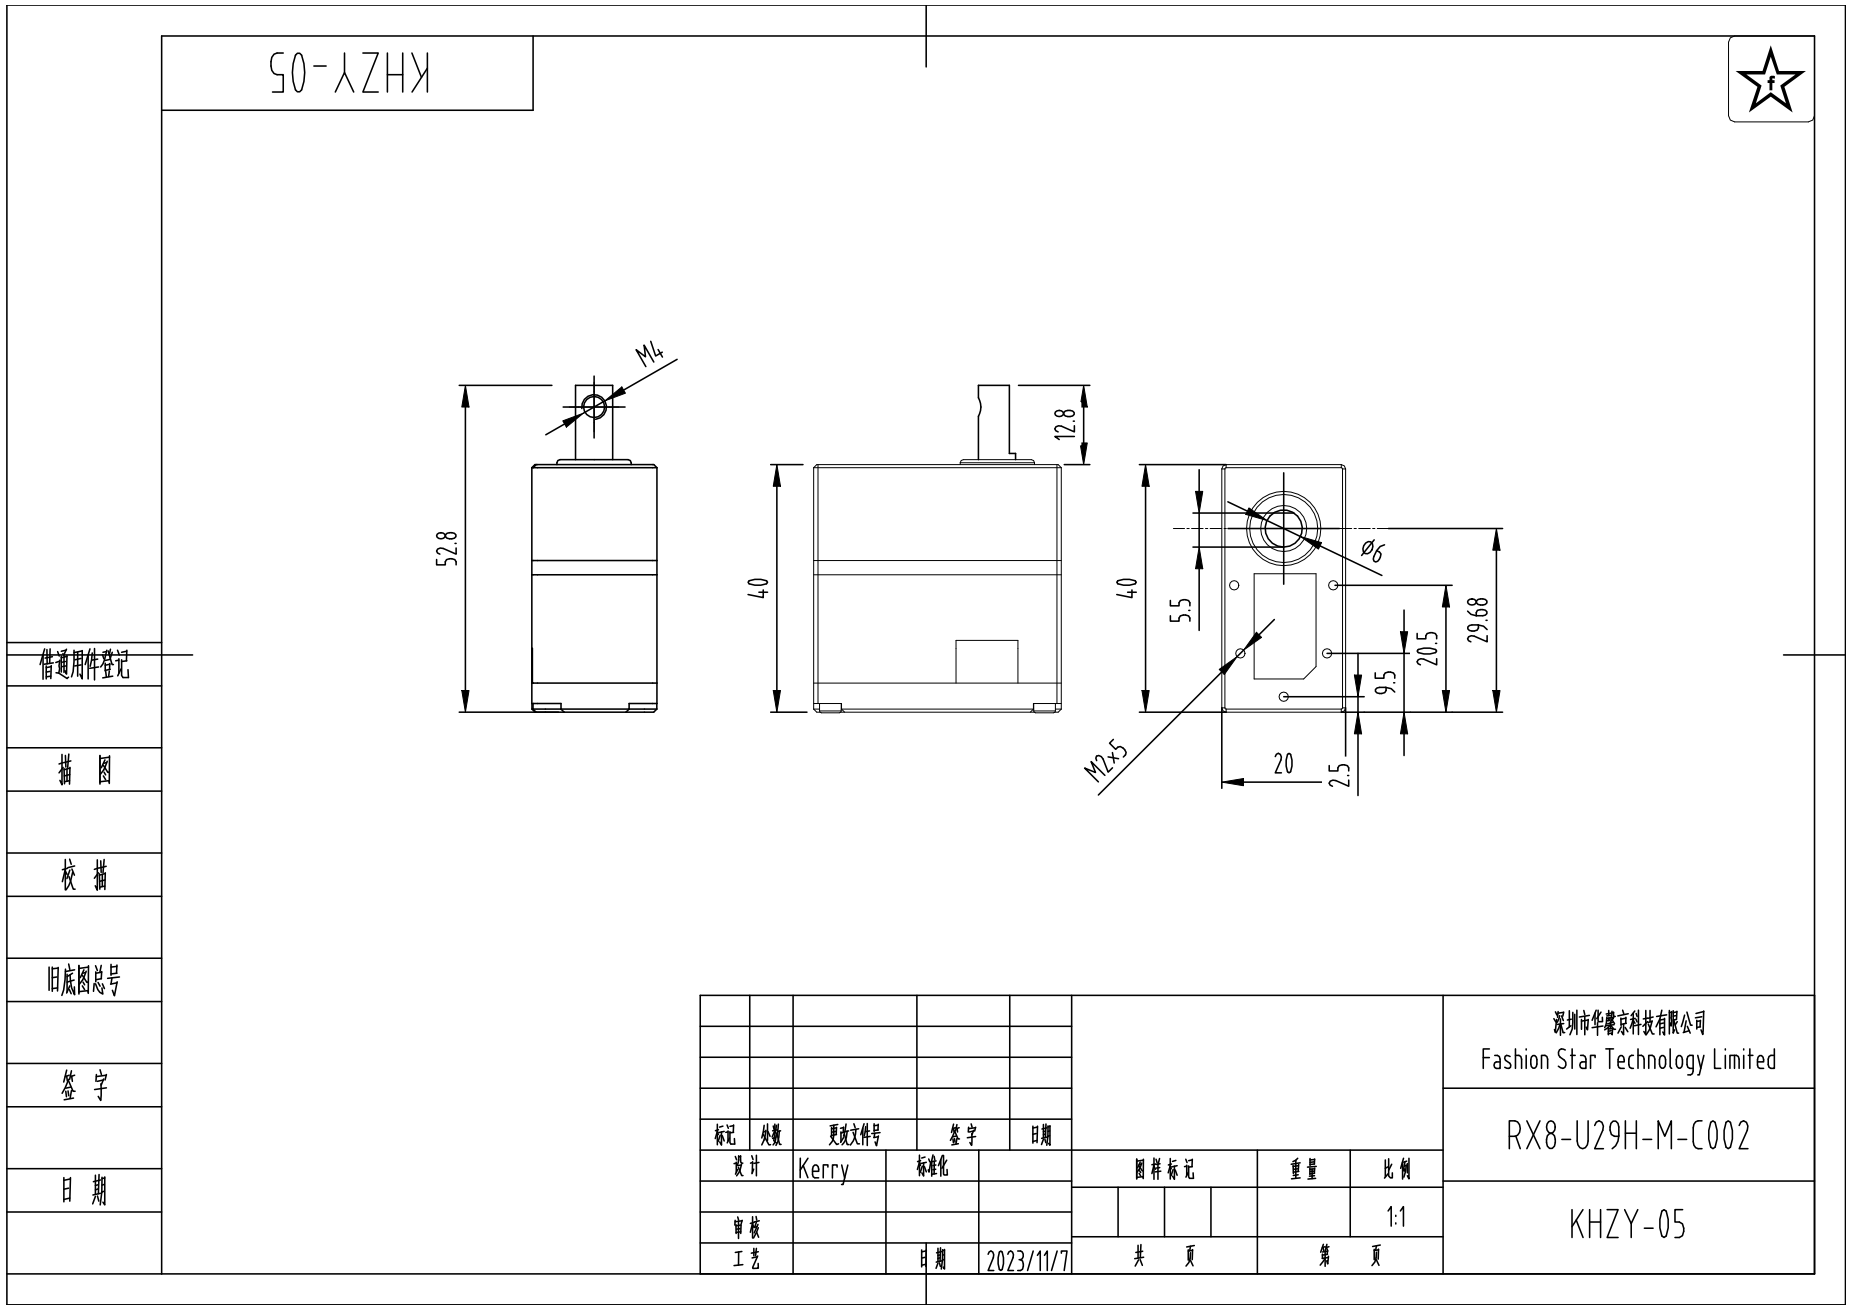
[picture p222: page 1]
