Lucaszyf/Solar-Enhanced-Biomimetic-UAV/(list of files, drawings)

Other design files:
src/No2/电路板/PCB_主控板_2024-08-05.json
src/No2/电路板/PCB_电源板_2024-08-05.json
src/No2/电路板/SCH_Lucas主控板_2024-08-05.json
src/No2/电路板/SCH_Lucas项目降压板_2024-08-05.json
