Lucaszyf/Solar-Enhanced-Biomimetic-UAV/src/No1/Drone_code/SRC/drivers/Drv_gps.c

/******************** (C) COPYRIGHT 2017 ANO Tech ********************************
 * 描述    ：SPL06气压计驱动
**********************************************************************************/
#include "drv_spl06.h"

#include "Drv_gps.h"
#include "Ano_Imu.h"
#include "Ano_RC.h"

#define GPS_UART	USART1

GPS_INF Gps_information;
unsigned short len;

unsigned char GPS_ubx_check_sum(unsigned char *Buffer)
{
	unsigned char CK_A = 0, CK_B = 0;
	unsigned short  i;
	
	len = Buffer[4] + (Buffer[5]<<8);
	if (len > 100)
	{
		return 0;
	}
	for (i = 2; i < len+6; i++)
	{
		CK_A = CK_A + Buffer[i];
		CK_B = CK_B + CK_A;
	}
	if (CK_A == Buffer[len+6] && CK_B == Buffer[len+7])
	{
		return 1;
	}
	else
	{
		return 0;
	}
}

static void UART_Write_D(const unsigned char *send_buff, unsigned char len)
{
	unsigned char i;
	
	for (i = 0; i < len; i++)
	{
		while(USART_GetFlagStatus(GPS_UART, USART_FLAG_TC)== RESET);
		USART_SendData(GPS_UART,send_buff[i]);
	}
}



const unsigned char gps_petrol_out_config[28]=
{
//	0xB5,0x62,0x06,0x00,0x14,0x00,0x01,0x00,0x00,0x00,0xD0,0x08,0x00,0x00,0x80,0x25,0x00,0x00,0x07,0x00,0x01,0x00,0x00,0x00,0x00,0x00,0xA0,0xA9
	0xB5,0x62,0x06,0x00,0x14,0x00,0x01,0x00,0x00,0x00,0xD0,0x08,0x00,0x00,0x00,0xC2,0x01,0x00,0x01,0x00,0x01,0x00,0x00,0x00,0x00,0x00,0xB8,0x42
};

const unsigned char gps_pvt_out_config[90]=
{
	0xB5,0x62,0x06,0x01,0x08,0x00,0x01,0x07,0x00,0x01,0x00,0x00,0x00,0x00,0x18,0xE1,
//	0xB5,0x62,0x06,0x01,0x08,0x00,0x01,0x12,0x01,0x01,0x01,0x01,0x01,0x00,0x27,0x3D
	0xB5,0x62,0x06,0x01,0x08,0x00,0x01,0x02,0x00,0x00,0x00,0x00,0x00,0x00,0x12,0xB9,
	0xB5,0x62,0x06,0x01,0x08,0x00,0x01,0x03,0x00,0x00,0x00,0x00,0x00,0x00,0x13,0xC0,
	0xB5,0x62,0x06,0x01,0x08,0x00,0x01,0x06,0x00,0x00,0x00,0x00,0x00,0x00,0x16,0xD5,
	0xB5,0x62,0x06,0x01,0x08,0x00,0x01,0x12,0x00,0x00,0x00,0x00,0x00,0x00,0x22,0x29
};

const unsigned char gps_rate_out_config[16]=
{
	0xB5,0x62,0x06,0x08,0x06,0x00,0x64,0x00,0x01,0x00,0x01,0x00,0x7A,0x12  //len 14
};

const unsigned char Enter_Send[]={0xB5,0x62,0x06,0x00,0x01,0x00,0x01,0x08,0x22};

void gps_baudrate_config(void)
{
	Delay_ms(200);
//		UART_Write_D(gps_rate_out_config,14);
	UART_Write_D(gps_petrol_out_config,28);

	UART_Write_D(Enter_Send,sizeof(Enter_Send));
		Delay_ms(20);
}

void gps_config(void)
{
	Delay_ms(100);

	UART_Write_D(gps_pvt_out_config,90);
		Delay_ms(20);

	UART_Write_D(gps_rate_out_config,14);
		Delay_ms(20);

//	UART_Write_D(gps_petrol_out_config,28);
//		Delay_ms(20);
	
	UART_Write_D(Enter_Send,sizeof(Enter_Send));
		Delay_ms(20);
}

float wcx_acc_use;		
float wcy_acc_use;
void Drv_GpsPin_Init(void)
{
	USART_InitTypeDef USART_InitStructure;
	NVIC_InitTypeDef NVIC_InitStructure;
	GPIO_InitTypeDef GPIO_InitStructure;
	
	RCC_APB2PeriphClockCmd ( RCC_APB2Periph_USART1,ENABLE ); 
    RCC_AHB1PeriphClockCmd ( RCC_AHB1Periph_GPIOA, ENABLE );

    //???????
    NVIC_InitStructure.NVIC_IRQChannel = USART1_IRQn;
    NVIC_InitStructure.NVIC_IRQChannelPreemptionPriority = NVIC_UART1_P;
    NVIC_InitStructure.NVIC_IRQChannelSubPriority = NVIC_UART1_S;
    NVIC_InitStructure.NVIC_IRQChannelCmd = ENABLE;
    NVIC_Init ( &NVIC_InitStructure );


    GPIO_PinAFConfig ( GPIOA, GPIO_PinSource9, GPIO_AF_USART1 );
    GPIO_PinAFConfig ( GPIOA, GPIO_PinSource10, GPIO_AF_USART1 );
	
	//??PC12??UART5 Tx
    GPIO_InitStructure.GPIO_Pin = GPIO_Pin_9;
    GPIO_InitStructure.GPIO_Mode = GPIO_Mode_AF;
    GPIO_InitStructure.GPIO_Speed = GPIO_Speed_50MHz;
    GPIO_InitStructure.GPIO_OType = GPIO_OType_PP;
    GPIO_InitStructure.GPIO_PuPd = GPIO_PuPd_UP ;
    GPIO_Init ( GPIOA, &GPIO_InitStructure );
    //??PD2??UART5 Rx
    GPIO_InitStructure.GPIO_Pin = GPIO_Pin_10 ;
    GPIO_InitStructure.GPIO_Mode = GPIO_Mode_AF;
    GPIO_InitStructure.GPIO_Speed = GPIO_Speed_50MHz;
    GPIO_InitStructure.GPIO_OType = GPIO_OType_OD;
    GPIO_InitStructure.GPIO_PuPd = GPIO_PuPd_DOWN ;
    GPIO_Init ( GPIOA, &GPIO_InitStructure );

	USART_DeInit(GPS_UART);
	USART_StructInit(&USART_InitStructure);
	USART_InitStructure.USART_BaudRate          =   9600;//38400;//9600;//38400;
	USART_InitStructure.USART_WordLength        =   USART_WordLength_8b;
	USART_InitStructure.USART_StopBits          =   USART_StopBits_1;
	USART_InitStructure.USART_Parity            =   USART_Parity_No;
	USART_InitStructure.USART_Mode              =   USART_Mode_Rx | USART_Mode_Tx;
	USART_InitStructure.USART_HardwareFlowControl = USART_HardwareFlowControl_None;
	USART_Init(GPS_UART,&USART_InitStructure);
	USART_Cmd(GPS_UART,ENABLE);
	
	gps_baudrate_config();
	
//	USART_Cmd(GPS_UART,DISABLE);
	USART_InitStructure.USART_BaudRate          =   38400;//38400;//9600;//38400;
	USART_InitStructure.USART_WordLength        =   USART_WordLength_8b;
	USART_InitStructure.USART_StopBits          =   USART_StopBits_1;
	USART_InitStructure.USART_Parity            =   USART_Parity_No;
	USART_InitStructure.USART_Mode              =   USART_Mode_Rx | USART_Mode_Tx;
	USART_InitStructure.USART_HardwareFlowControl = USART_HardwareFlowControl_None;
	USART_Init(GPS_UART,&USART_InitStructure);
	USART_Cmd(GPS_UART,ENABLE);
	
	gps_baudrate_config();


//		USART_Cmd(GPS_UART,DISABLE);
    //??UART5
    //??????
    USART_InitStructure.USART_BaudRate = 115200;       //????????????
    USART_InitStructure.USART_WordLength = USART_WordLength_8b;  //8???
    USART_InitStructure.USART_StopBits = USART_StopBits_1;   //??????1????
    USART_InitStructure.USART_Parity = USART_Parity_No;    //??????
    USART_InitStructure.USART_HardwareFlowControl = USART_HardwareFlowControl_None; //???????
    USART_InitStructure.USART_Mode = USART_Mode_Tx | USART_Mode_Rx;  //???????
    USART_Init ( GPS_UART, &USART_InitStructure );
    USART_Cmd ( GPS_UART, ENABLE );		
		gps_config();
		
    //??UART5????
    USART_ITConfig ( GPS_UART, USART_IT_RXNE, ENABLE );
    //??USART5


}

unsigned char GPS_data_buff[100];
unsigned char GPS_get_cnt = 0;
_fc_ext_sensor_st ext_sens;
void GPS_data_analysis(void)
{
	s32 gps_hmsl,gps_N_vel,gps_E_vel,gps_D_vel;
	Gps_information.last_N_vel = (float)Gps_information.N_vel;							//记录上次南北向速度
	Gps_information.last_E_vel = (float)Gps_information.E_vel;							//记录上次东西向速度
	
	Gps_information.satellite_num = GPS_data_buff[29];									//卫星数量
	Gps_information.longitude = GPS_data_buff[30] + (GPS_data_buff[31]<<8) + (GPS_data_buff[32]<<16) + (GPS_data_buff[33]<<24);		//经度
	Gps_information.latitude  = GPS_data_buff[34] + (GPS_data_buff[35]<<8) + (GPS_data_buff[36]<<16) + (GPS_data_buff[37]<<24);		//纬度
	gps_hmsl                  = GPS_data_buff[42] + (GPS_data_buff[43]<<8) + (GPS_data_buff[44]<<16) + (GPS_data_buff[45]<<24);		//海拔
	gps_N_vel = Gps_information.N_vel	  = GPS_data_buff[54] + (GPS_data_buff[55]<<8) + (GPS_data_buff[56]<<16) + (GPS_data_buff[57]<<24);		//南向速度
	gps_E_vel = Gps_information.E_vel	  = GPS_data_buff[58] + (GPS_data_buff[59]<<8) + (GPS_data_buff[60]<<16) + (GPS_data_buff[61]<<24);		//东向速度
	gps_D_vel                             = GPS_data_buff[62] + (GPS_data_buff[63]<<8) + (GPS_data_buff[64]<<16) + (GPS_data_buff[65]<<24);		//地向速度
	
	Gps_information.N_vel /=10;								//单位换算 cm/s
	Gps_information.E_vel /=10;								//单位换算 cm/s	

	if (Gps_information.satellite_num >= 6 && Gps_information.new_pos_get == 0)			//卫星数量到达6颗,且第一次获取经纬度点
	{
		Gps_information.new_pos_get = 1;
		Gps_information.start_longitude = Gps_information.longitude;
		Gps_information.start_latitude  = Gps_information.latitude;
		Gps_information.hope_latitude  = 0;
		Gps_information.hope_longitude = 0;

	}
	
	if (Gps_information.new_pos_get)
	{
		Gps_information.latitude_offset  = Gps_information.latitude  - Gps_information.start_latitude;
		Gps_information.longitude_offset = Gps_information.longitude - Gps_information.start_longitude;
	}

	Gps_information.run_heart++;	
	
	//v7协议处理
	ext_sens.fc_gps.st_data.FIX_STA = 2;//null
	ext_sens.fc_gps.st_data.S_NUM = Gps_information.satellite_num;
	ext_sens.fc_gps.st_data.LNG = Gps_information.longitude;
	ext_sens.fc_gps.st_data.LAT = Gps_information.latitude;
	ext_sens.fc_gps.st_data.ALT_GPS = gps_hmsl / 10; //mm->cm
	ext_sens.fc_gps.st_data.N_SPE = gps_N_vel / 10;	  //mm->cm
	ext_sens.fc_gps.st_data.E_SPE = gps_E_vel / 10;	  //mm->cm
	ext_sens.fc_gps.st_data.D_SPE = gps_D_vel / 10;	  //mm->cm
	//按协议处理赋值
//	u32 tmp;
//	tmp = ubx.pvt_data.pDOP * 0.01f;
//	tmp = LIMIT(tmp, 0, 200);
//	ext_sens.fc_gps.st_data.PDOP_001 = tmp;
//	tmp = ubx.pvt_data.sAcc * 0.01f;
//	tmp = LIMIT(tmp, 0, 200);
//	ext_sens.fc_gps.st_data.SACC_001 = tmp;
//	tmp = ubx.pvt_data.vAcc * 0.01f;
//	tmp = LIMIT(tmp, 0, 200);
//	ext_sens.fc_gps.st_data.VACC_001 = tmp;
}


void Uart1_GPS_IRQ(void)  
{  
	unsigned char RX_dat;  

	if ( GPS_UART->SR & USART_SR_ORE ) //ORE??
    {
        RX_dat = GPS_UART->DR;
    }
	
	if(USART_GetITStatus(GPS_UART,USART_IT_RXNE)==SET)//USART_IT_RXNE:????  
	{   
		USART_ClearITPendingBit(GPS_UART,USART_IT_RXNE);  
		RX_dat=USART_ReceiveData(GPS_UART); 
		if (GPS_get_cnt == 0)
		{
			if (RX_dat == 0xB5)									//帧头1
			{
				GPS_data_buff[GPS_get_cnt] = RX_dat;
				GPS_get_cnt = 1;
			}
		}
		else if (GPS_get_cnt == 1)
		{
			if (RX_dat == 0x62)									//帧头2
			{
				GPS_data_buff[GPS_get_cnt] = RX_dat;
				GPS_get_cnt = 2;
			}
			else
			{
				GPS_get_cnt = 0;
			}
		}
		else
		{
			GPS_data_buff[GPS_get_cnt] = RX_dat;
			GPS_get_cnt++;
			if (GPS_get_cnt >= 100)
			{
				GPS_get_cnt = 0;
				
				if (GPS_ubx_check_sum(GPS_data_buff))			//GPS数据校验
				{
					GPS_data_analysis();						//GPS数据解析
				}
			}
		}			
	}	
} 


void WCXY_Acc_Get_Task(void)//最小周期
{
	wcx_acc_use += 0.02f *(imu_data.w_acc[X] - wcx_acc_use);
	wcy_acc_use += 0.02f *(imu_data.w_acc[Y] - wcy_acc_use);
}

static u8 home_locked;
void GPS_Data_Processing_Task(u8 dT_ms)
{
	static float err_N_step, err_E_step;
	static unsigned char last_gps_heart = 0; 
	
	if (Gps_information.run_heart != last_gps_heart)
	{
		last_gps_heart = Gps_information.run_heart;
		err_N_step = (float)(Gps_information.N_vel - Gps_information.last_N_vel)/10;		//计算两次GPS速度误差作为插值
		err_E_step = (float)(Gps_information.E_vel - Gps_information.last_E_vel)/10;
	}
	Gps_information.last_N_vel += err_N_step;									//对速度插值
	Gps_information.last_E_vel += err_E_step;
	
	if (Gps_information.satellite_num >= 6 
					&& flag.flight_mode >= LOC_HOLD)//CH_N[AUX1] > -200 )
	{
		if(1) //(!flag.taking_off)
		{
			switchs.gps_on = 1;							//开启GPS模式
		}
	}
	else
	{
		switchs.gps_on = 0;							//关闭GPS模式
	}
	//没有起飞的时候才能记录返航点
	if (!flag.taking_off)
	{
		if (switchs.gps_on)
		{
			Gps_information.hope_latitude = Gps_information.latitude_offset;		//记录期望位置为当前位置
			Gps_information.hope_longitude = Gps_information.longitude_offset;
			Gps_information.home_latitude = Gps_information.latitude_offset;		//记录返航点位置
			Gps_information.home_longitude = Gps_information.longitude_offset;
			home_locked = 1;
		}
	}
	else
	{
		if (switchs.gps_on && home_locked != 0)
		{	
			if (flag.flight_mode == RETURN_HOME || flag.rc_loss_back_home )//(CH_N[AUX1] > 200)
			{
				if (!Gps_information.Back_home_f)			
				{
					Gps_information.Back_home_f = TRUE;		//打开返航
					Gps_information.hope_latitude = Gps_information.home_latitude;			//改变期望位置为起飞点位置
					Gps_information.hope_longitude = Gps_information.home_longitude;
				}
			}	
			else
			{
				if (Gps_information.Back_home_f)			
				{
					Gps_information.Back_home_f = FALSE;	//关闭返航
					Gps_information.hope_latitude = Gps_information.latitude_offset;		//改变期望位置为当前位置
					Gps_information.hope_longitude = Gps_information.longitude_offset;
				}
			}
		}			
	}
}
