Lucaszyf/Solar-Enhanced-Biomimetic-UAV/src/No2/程序/SuperDrone_Pro_Upixels/SRC/drivers/Drv_UP_Flow.c

#include "Drv_UP_flow.h"
#include "Drv_Usart.h"
#include "Drv_laser.h"
#include "Drv_time.h"
#include "BSP_Init.h"



#define delay_ms Delay_ms
#define Drv_Uart4SendBuf Uart4_Send

const static uint8_t Sensor_cfg[]={
0x12, 0x80, 
0x11, 0x30, 
0x1b, 0x06, 
0x6b, 0x43, 
0x12, 0x20, 
0x3a, 0x00, 
0x15, 0x02, 
0x62, 0x81, 
0x08, 0xa0, 
0x06, 0x68, 
0x2b, 0x20, 
0x92, 0x25, 
0x27, 0x97, 
0x17, 0x01, 
0x18, 0x79, 
0x19, 0x00, 
0x1a, 0xa0, 
0x03, 0x00, 
0x13, 0x00, 
0x01, 0x13, 
0x02, 0x20, 
0x87, 0x16, 
0x8c, 0x01, 
0x8d, 0xcc, 
0x13, 0x07, 
0x33, 0x10, 
0x34, 0x1d, 
0x35, 0x46, 
0x36, 0x40, 
0x37, 0xa4, 
0x38, 0x7c, 
0x65, 0x46, 
0x66, 0x46, 
0x6e, 0x20, 
0x9b, 0xa4, 
0x9c, 0x7c, 
0xbc, 0x0c, 
0xbd, 0xa4, 
0xbe, 0x7c, 
0x20, 0x09, 
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
};

#define CIRCLE_P(n,a,b) ((a) + ((n)-(a))%((b)-(a)))
#define OF_BUFFER_NUM 14

uint8_t of_init_cnt;
uint8_t of_buf_update_cnt;
uint8_t OF_DATA[OF_BUFFER_NUM];


static uint8_t com_getdata[OF_BUFFER_NUM]= {0};//buffer

u8 Drv_OFInit(void)
{
	uint8_t send_buffer[10];
	uint8_t i;
	//rst
	of_init_cnt = 0;
	
	//
	send_buffer[0] = 0xAA;
	Drv_Uart4SendBuf(send_buffer, 1);

	send_buffer[0] = 0xAB;
	send_buffer[1] = 0x96;
	send_buffer[2] = 0x26;
	send_buffer[3] = 0xbc;
	send_buffer[4] = 0x50;
	send_buffer[5] = 0x5c;
	Drv_Uart4SendBuf(send_buffer, 6);

	//check_ack
	delay_ms(10);
	//
	if (of_init_cnt >= 3)
	{
		if (com_getdata[0] == 0xab && com_getdata[1] == 0x00 && com_getdata[2] == 0xab)
		{
			of_init_cnt = 0;
		}
		else
		{
			of_init_cnt = 10;
		}
	}
	else
	{
		of_init_cnt = 10;
	}
		
	//
	uint8_t len = 161;
	for(i=0; i<len;i+=2 )
	{
		send_buffer[0] = 0xBB;	 
		send_buffer[1] = 0xdc;	
		send_buffer[2] = Sensor_cfg[i];
		send_buffer[3] = Sensor_cfg[i+1];
		send_buffer[4] = (0xdc^send_buffer[2]^send_buffer[3]);
		Drv_Uart4SendBuf(send_buffer, 5);

		//check_ack
		delay_ms(10);
		//
		if(of_init_cnt >= 3)
		{
			if (com_getdata[0] == 0xbb && com_getdata[1] == 0x00 && com_getdata[2] == 0xbb)
			{
				of_init_cnt = 0;

			}
			else
			{
				of_init_cnt = 10;

			}
		}
		else
		{
			of_init_cnt = 10;
		}
				
	}
	
	send_buffer[0] = 0xDD;
	//
	Drv_Uart4SendBuf(send_buffer, 1);

	
	
	if(of_init_cnt == 10)
	{
		//光流初始化检测
//		while(1)
//		{
//				for(u8 i = 0;i<2;i++)
//				{
//					led_on(LED_ALL);
//					//
//					delay_ms(200);
//					//
//					led_off(LED_ALL);
//					//
//					delay_ms(200);
//				}
//				//
//				delay_ms(1500);
//				//			
//		}
		return (0);
	}
	else
	{
		//
		of_init_cnt = 255;
		//
		//of_init_type = 2;
		return (1);
	}
	
	
}


void OFGetByte(uint8_t data)
{
	static uint8_t in_p=0,head_p = 0;
	
	//
//	if(of_init_cnt!=255 )
//	{
//		if(of_init_cnt<OF_BUFFER_NUM)
//		{
//			com_getdata[of_init_cnt++] = data;
//		}
//	}
//	else	
//	{
		//		
		com_getdata[in_p++] = data;
		in_p %= OF_BUFFER_NUM;

		if(in_p == head_p)
		{
			if(
						 (com_getdata[CIRCLE_P(head_p   ,0,OF_BUFFER_NUM)] == 0xFE)
					&& (com_getdata[CIRCLE_P(head_p+1 ,0,OF_BUFFER_NUM)] == 0x0A)
					&& (com_getdata[CIRCLE_P(head_p+13,0,OF_BUFFER_NUM)] == 0x55)
				)
			{
				for(uint8_t i=0; i<OF_BUFFER_NUM; i++)
				{
					OF_DATA[i] = com_getdata[CIRCLE_P(head_p+i,0,OF_BUFFER_NUM)];
				}
				of_buf_update_cnt++;
				if(com_getdata[CIRCLE_P(head_p+11,0,OF_BUFFER_NUM)] == 0x64)LASER_LINKOK = 1;
				else LASER_LINKOK=0;
			}
			else
			{		
				head_p ++;
				head_p %= OF_BUFFER_NUM;
			}
		}
//	}
}
/*
//优象原始数据
void OFGetByte(u8 bytedata)
{	
	static u8 rec_sta=0;
	
	OF_DATA[rec_sta] = bytedata;
	//
	if(rec_sta==0)
	{
		if(bytedata==0xFE)
		{
			rec_sta++;
		}
		else
		{
			rec_sta=0;
		}
	}
	else if(rec_sta==1)
	{
		if(bytedata==0x0A)
		{
			rec_sta++;
		}	
		else
		{
			rec_sta=0;
		}		
	}
	else if(rec_sta==13)
	{
		if(bytedata==0x55)
		{
			//解析成功
			//Flow_Data_Analysis(flow_buf);
			//
			rec_sta=0;
		}
		else
		{
			rec_sta=0;
		}		
	}else
	{
		rec_sta++;
	}
}
*/
