Lucaszyf/Solar-Enhanced-Biomimetic-UAV/src/No2/程序/SuperDrone_Pro/SRC/drivers/Drv_usart.h

#ifndef _USART_H
#define _USART_H

#include "stm32f4xx.h"

extern u8 Rx_Buf[];
void Usart2_Init(u32 br_num);
void Usart2_IRQ(void);
void Usart2_Send(unsigned char *DataToSend ,u8 data_num);
void Serial_SendString(char *String);
void Serial_SendByte(uint8_t Byte);

void Usart3_Init ( u32 br_num );
void Usart3_IRQ ( void );
static void Usart3_Send ( unsigned char *DataToSend , u8 data_num );

void Uart4_Init(u32 br_num);
void Uart4_IRQ(void);
void Uart4_Send(unsigned char *DataToSend ,u8 data_num);

void Uart5_Init(u32 br_num);
void Uart5_IRQ(void);
void Uart5_Send(unsigned char *DataToSend ,u8 data_num);
#endif
