Lucaszyf/Solar-Enhanced-Biomimetic-UAV/src/最新版本代码/ESP_drone_v2/ESP_drone/bsp_SW.h

#ifndef BSP_SW_H
#define BSP_SW_H
#include "Arduino.h"
#include "bsp_usart.h"
#include "bsp_attachment.h"
#include "bsp_solarpanel.h"
#include "bsp_gpio.h"
#include "bsp_servo.h"

void interpret_SW();

#endif
